Invoker-pray/INT8-CIM-of-jiao/Thesis/paper/paper.tex

\documentclass[bachelor,compact,nofont]{xjtuthesis}

% --- 手动字体设置（nofont 选项，因 Times New Roman / Arial 在 Linux 上不可用）---
\setmainfont{Liberation Serif}
\setsansfont{Liberation Sans}
\setmonofont{Liberation Mono}
\setCJKmainfont{Source Han Serif CN}
\setCJKsansfont{Source Han Serif CN}
\setCJKmonofont{Source Han Serif CN}
\setCJKfamilyfont{hei}{Source Han Serif CN}
\newcommand{\hei}{\CJKfamily{hei}}

% --- 额外宏包（正文内容需要）---
\usepackage{float}
\usepackage{pdfpages}
\usepackage{multirow}
\usepackage{tabularx}
\usepackage{listings}
\usepackage{xcolor}
\usepackage[bookmarksnumbered=true,bookmarksopen=true,bookmarksopenlevel=1,breaklinks=true,colorlinks=true,linkcolor=black,citecolor=black,urlcolor=black,plainpages=false,pdfborder=0 0 0]{hyperref}

% --- 图形路径 ---
\graphicspath{{figures/}{pics/}}

% --- 代码环境 ---
\lstset{
  basicstyle=\small\ttfamily,
  keywordstyle=\color{blue},
  commentstyle=\color{gray},
  numbers=left,
  numberstyle=\tiny\color{gray},
  frame=single,
  breaklines=true,
  captionpos=b
}

% --- 公式编号：分章编号 (章-序号) ---
\numberwithin{equation}{chapter}
\renewcommand{\theequation}{\thechapter-\arabic{equation}}

\begin{document}

\makeatletter
\g@addto@macro\normalsize{%
  \abovedisplayskip=3pt plus 1pt minus 1pt%
  \abovedisplayshortskip=3pt plus 1pt minus 1pt%
  \belowdisplayskip=5pt plus 1pt minus 1pt%
  \belowdisplayshortskip=5pt plus 1pt minus 1pt%
}
\makeatother
% ======================================================================
% 论文元信息
% ======================================================================
\ctitle{数字存算一体阵列架构设计与FPGA验证}
\cauthor{焦宏宝}
\ccollege{电子与信息学部\ \ 微电子学院}
\cmajor{微电子科学与工程}
\cclass{微电子2202班}
\corgnization{西安交通大学}
\stunum{2221411116}
\csupervisor{梁峰}
\cproddate{2026年05月}
\ckeywords{存算一体；INT8量化推理；FPGA验证；CIM阵列；AXI4-Stream DMA；双缓冲；PicoRV32}

\etitle{Design and FPGA Verification of a Digital Computing-in-Memory Array Architecture}
\eauthor{Jiao Hongbao}
\esupervisor{Liang Feng}
\ekeywords{Computing-in-Memory; INT8 quantized inference; FPGA verification; CIM array; AXI4-Stream DMA; double buffering; PicoRV32}

\cabstract{
随着深度学习在边缘智能场景中的广泛部署，传统冯·诺依曼架构中处理器与存储器分离所带来的数据搬运瓶颈日益突出。存算一体（Computing-in-Memory, CIM）技术通过在存储阵列内部或近存储位置完成计算，从体系结构层面缓解"内存墙"问题。

本文设计并实现了一种面向边缘推理的INT8数字存算一体矩阵计算阵列架构，在PYNQ-Z2（Zynq-7020）FPGA平台上完成了综合、部署与板级验证。系统以16×16 CIM Tile为原子计算单元，通过乘法器时分复用将单Tile的DSP48占用由256降至约64，在220块DSP的资源预算内部署输出并行度PAR\_OB=2/3（周期级仿真扫描至16）。核心引擎通过多级流水线状态机实现权重加载、零点减法、MAC运算、偏置累加、ReLU激活、重量化与结果写回的完整推理数据通路。数据通路采用AXI4-Stream + DMA双向批量传输替代逐字MMIO，配合输入/输出双缓冲乒乓结构与OBUF→IBUF层融合机制，将LeNet-5端到端延迟从约3,194 ms/幅降至29.88 ms/幅（约107倍数据通路加速）。软件侧引入块对角权重打包（SQ-mapping），将稀疏小卷积核场景下的MVM调用次数削减90\%以上。控制路径方面，集成了PicoRV32 RISC-V软核，通过总线桥接与双端口BRAM实现纯PL侧自主推理，且CIM IP完全不需修改。

实验结果表明，在64 MHz签核频率（PAR\_OB=2，WNS +0.013 ns）下，MLP网络（784→128→10）端到端延迟为1.94 ms/幅（约513 fps），LeNet-5 CNN端到端延迟为29.88 ms/幅（约33.5 fps），分类准确率99\%--100\%，全部硬件输出与自研Python整数golden model逐元素bit-exact一致。在与ARM Cortex-A9纯软件（NumPy/BLAS）同口径对比中，CIM硬件计算核快约65--191倍，系统级端到端仍快约1.23--2.24倍。PicoRV32模式以更少的逻辑资源（FF减少约2136个）实现纯PL自主推理，全部logits与ARM路径bit-exact一致。
}

\eabstract{
With the widespread deployment of deep learning at the edge, the data movement bottleneck caused by the separation of processor and memory in traditional von Neumann architectures has become increasingly prominent. Computing-in-Memory (CIM) technology mitigates the ``memory wall'' problem by performing computation within or near memory arrays.

This thesis designs and implements an INT8 digital CIM matrix computation array architecture for edge inference, with synthesis, deployment, and board-level verification on the PYNQ-Z2 (Zynq-7020) FPGA platform. The system employs a 16$\times$16 CIM Tile as the atomic compute unit; multiplier time-multiplexing reduces the per-tile DSP48 count from 256 to approximately 64, enabling output parallelism PAR\_OB=2/3 within the 220-DSP budget (with a cycle-level simulation sweep up to 16). The core engine implements the complete inference datapath—weight loading, zero-point subtraction, MAC operation, bias accumulation, ReLU activation, requantization, and result writeback—through a multi-stage pipelined FSM. The data path adopts an AXI4-Stream + DMA bidirectional bulk-transfer architecture in place of per-word MMIO, combined with input/output double-buffer ping-pong and OBUF$\rightarrow$IBUF layer fusion, reducing the LeNet-5 end-to-end latency from approximately 3,194 ms/image to 29.88 ms/image (about a 107$\times$ data-path speedup). On the software side, block-diagonal weight packing (SQ-mapping) is introduced to cut the number of MVM invocations for sparse small-kernel convolutions by over 90\%. For the control path, a PicoRV32 RISC-V soft-core is integrated; with a bus bridge and dual-port BRAMs, the accelerator achieves autonomous inference in pure programmable logic with zero modification to the CIM IP.

Experimental results show that at the 64 MHz signoff frequency (PAR\_OB=2, WNS +0.013 ns), the MLP network (784$\rightarrow$128$\rightarrow$10) achieves 1.94 ms/image end-to-end (about 513 fps), while LeNet-5 achieves 29.88 ms/image (about 33.5 fps), with classification accuracy of 99\%--100\%. All hardware outputs are element-wise bit-exact with a custom Python integer golden model. In an apples-to-apples comparison against pure ARM Cortex-A9 software (NumPy/BLAS), the CIM hardware is about 65--191$\times$ faster at the compute-core level and remains 1.23--2.24$\times$ faster at the system level. The PicoRV32 mode achieves autonomous inference in pure programmable logic with fewer logic resources (approximately 2,136 fewer FFs than ARM mode), and all logits are bit-exact with the ARM path.
}

% ======================================================================
% 封面、摘要、目录
% ======================================================================
\xjtuchead
\clearpage
\phantom{x}
\thispagestyle{empty}
\clearpage
\setcounter{page}{1}
\xjtucinfopage
\xjtueinfopage
\xjtutoc
\clearpage

% ======================================================================
% 正文开始
% ======================================================================
\xjtucontent

% ====================================================================
\chapter{绪论}
% ====================================================================

\section{选题背景}

近年来，以YOLO\cite{10}、SSD\cite{11}为代表的深度学习目标检测算法在智能安防、工业视觉、无人系统与车载感知等场景中被广泛采用，其共同特点是需要在较高精度下实现接近实时的推理能力，而网络内部又以卷积/矩阵乘加（MAC）为主导计算负载，导致整体计算量与数据访问量都十分庞大。YOLO将检测任务端到端地建模为单网络回归问题，SSD则是通过多尺度特征图上的卷积预测实现单阶段检测，这类方法在追求速度与精度的同时，也使得卷积算子成为系统性能与功耗优化的核心瓶颈之一。

进一步观察可以发现，无论是YOLO、SSD这类检测网络，还是更轻量的多层感知机（MLP）与LeNet-5等分类网络，其主干运算都可以归结为矩阵-向量乘法（Matrix-Vector Multiplication, MVM）：全连接层本身就是一次MVM，而卷积层在经过im2col变换之后同样可以转化为矩阵乘法的形式。这意味着，只要硬件能够高效地完成维度可配置的INT8 MVM运算，并在其后衔接偏置累加、激活函数与重量化等定点后处理，便可以覆盖绝大多数边缘推理网络的核心算力需求。这一观察是本文将设计目标聚焦于"面向任意层的通用INT8 MVM计算阵列"、而非针对某一特定网络定制专用电路的根本出发点；它使得同一套RTL能够通过运行时配置服务于不同规模、不同结构的网络，从而在工程上获得更好的复用性与可维护性。

然而，在传统冯·诺依曼架构中，处理器与存储器相互分离，权重与特征图等数据需要在存储层级与计算单元之间频繁搬运，导致数据搬运资源开销远比实际计算要大，系统性能逐渐受限于存储带宽与访问延迟，"内存墙（Memory Wall）"问题由此形成并长期存在（如图\ref{fig:vn_vs_cim}所示，图中左侧传统架构中计算单元与存储器分离，数据需在层级间频繁搬运，受"内存墙"制约）。Wulf与McKee早在1995年就指出处理器速度提升与存储器速度提升之间的差距会不断扩大，从而限制系统级性能提升\cite{1}。与此同时，能效维度的矛盾更加突出：在先进工艺条件下，数据搬运（尤其是跨层级、跨片外存储访问）相对于算术运算存在着显著更高的能量代价，使得"算得快"并不等价于"算得省"。Horowitz在ISSCC 2014的报告中系统讨论了计算系统的能耗拆分，强调需要从体系结构与数据流层面减少昂贵的数据访问\cite{2}。面向CNN的专用加速器研究也进一步表明：通过数据复用与数据流优化降低（尤其是片外）访存开销，是实现低功耗实时推理的关键路径之一\cite{3}。在边缘计算场景（比如电池供电、散热受限和实时性要求较高的场景）中，上述矛盾更加尖锐，传统"分离式计算-存储"模式难以同时满足吞吐与能效需求。图\ref{fig:energy_per_op}对比了典型算术运算与不同层级存储访问的单次操作能耗（对数坐标，45nm工艺典型值\cite{2}），可见片外DRAM访问的能耗比一次8-bit MAC运算高出约两个数量级，直观地解释了想要实现低功耗推理为何要同时降低数据搬运而非单纯提升算力。

\begin{figure}[H]
	\centering
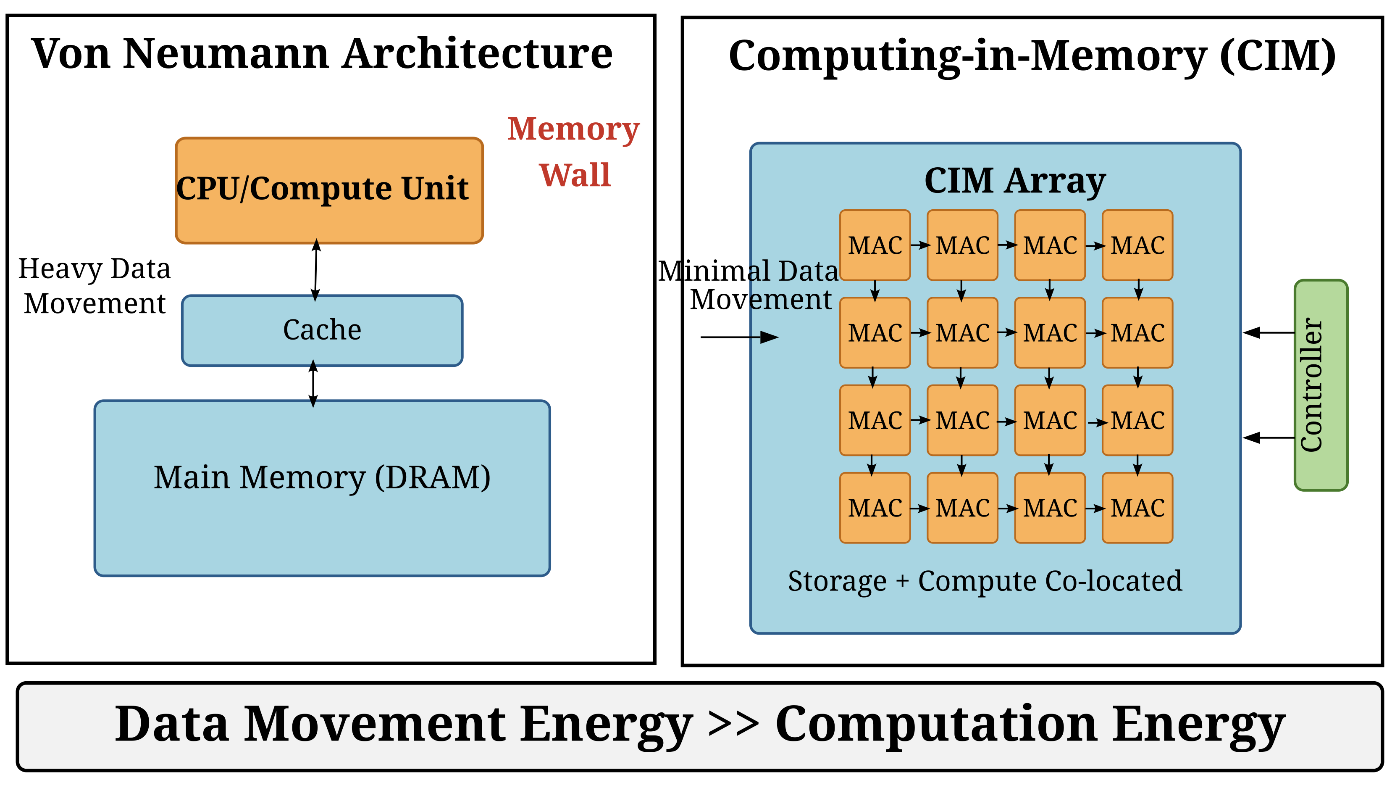
[picture p5: Thesis/paper/pics/1-1.png]
	
	\caption{冯·诺依曼架构与存算一体架构对比示意图}
	\label{fig:vn_vs_cim}
\end{figure}

\begin{figure}[H]
	\centering
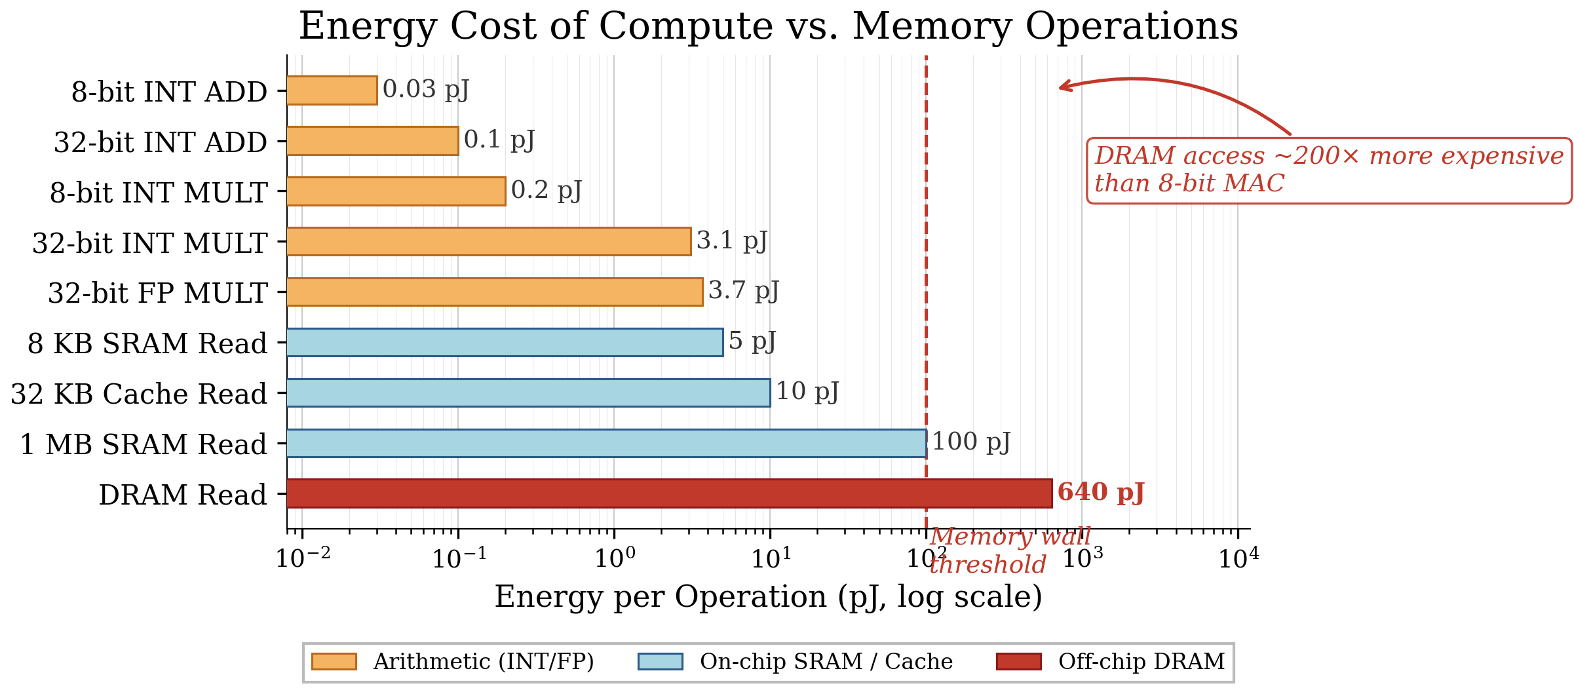
[picture p6: Thesis/paper/pics/1-2.png]
	
	\caption{计算与存储操作的单次能耗对比（pJ，对数坐标）}
	\label{fig:energy_per_op}
\end{figure}

存算一体（Computing-in-Memory, CIM）技术通过在存储阵列内部或近存储位置完成计算，将"数据搬运"转化为"原位计算"，从体系结构层面缓解冯·诺依曼瓶颈（如图\ref{fig:vn_vs_cim}所示，右侧为存算一体架构，将计算单元嵌入存储阵列内部，实现存储与计算的位置协同，显著减少数据搬运）。Nature Electronics的一些综述工作提出了覆盖不同存储器参与程度的CIM全谱系分类框架，并指出CIM可在逻辑运算与乘加运算等基本原语上实现能效提升\cite{4}。在诸多实现路径中，基于标准CMOS工艺的SRAM-CIM具有速度快、工艺成熟、可靠性高、与主流数字设计流程兼容等优点，是面向工程落地与系统集成的重要路线之一\cite{5}。Chuan-Jia Jhang团队系统综述了SRAM-CIM在AI边缘设备中的挑战与发展趋势\cite{30}，Si Xin与Dong Fangyuan团队也从设计挑战与方法学角度对SRAM-CIM进行了全面回顾\cite{31}\cite{34}。目前来讲，CIM技术被认为是突破内存墙、提升能效与吞吐率的重要方向。

从应用角度看，为在精度、硬件复杂度与系统吞吐之间取得平衡，INT8量化推理已成为工业界与学术界常用的落地方案之一。Jacob等人提出的整数算术推理量化方法表明，通过合理的量化尺度与训练以及恰当的校准策略，可在保持精度的前提下实现高效的整数运算推理流程\cite{6}。从硬件角度看，已有研究在SRAM-CIM宏单元中展示了面向多比特MAC的实现范式，如8b MAC的SRAM CIM宏以及支持Signed-INT8的SRAM CIM宏等工作，说明"多比特、可用于实际推理精度需求"的SRAM-CIM在工程上具有可行性\cite{8}\cite{32}。另外，在硬件加速方面，FPGA因其可重构性、低延迟与较高的能效比，已成为神经网络推理加速的重要平台\cite{meng2025}，已有工作在此基础上探索了注意力机制等特定算子的FPGA硬件加速\cite{feng2024}。

基于上述背景，本课题面向边缘智能推理的能效与实时性需求，在标准CMOS SRAM工艺假设下，设计了一种支持INT8数据类型的数字存算一体矩阵计算阵列架构（设计空间定位与两种实现极端的分析见§\ref{sec:two_extremes}）：以字级近存储方式组织权重存储与乘加及部分积生成（权重驻留BRAM、乘加由DSP48完成），结合合理的阵列并行组织、累加与数据通路调度，降低数据搬运开销并提升并行吞吐；通过Synopsys的VCS工具完成仿真测试，在AMD的Vivado(2024.2版本)完成综合和布局布线，并在FPGA平台完成实际综合部署与功能验证，形成了可复现的验证平台与完整代码交付。

\section{国内外现状及发展趋势}

存算一体研究近年来快速发展，已形成覆盖器件/电路/架构/算法的多层次技术体系。相关工作从实现介质（SRAM、DRAM、RRAM/PCM等）与计算形态（模拟/数字、阵列内/近存储）对CIM进行系统分类，指出其共同目标是减少访存与数据移动开销、利用阵列并行来提升吞吐\cite{4}\cite{5}\cite{12}\cite{14}\cite{30}\cite{31}\cite{34}\cite{r12}。近五年来，全数字SRAM-CIM在能效与精度上持续突破，相关宏单元与处理器工作密集涌现\cite{r1}\cite{r6}\cite{r8}\cite{r9}，成为面向边缘AI的重要研究热点。图\ref{fig:cim_taxonomy}按存储介质（SRAM/DRAM/RRAM/PCM等）与计算形态（模拟/数字、阵列内/近存储）给出了CIM技术的谱系分类，并标注了各分支的代表性工作；本文的设计落在"SRAM-CIM → 数字SRAM-CIM"这一分支（图中红框高亮），与ReDCIM、TranCIM、MulTCIM等数字CIM工作处于同一技术路线。

\begin{figure}[H]
	\centering
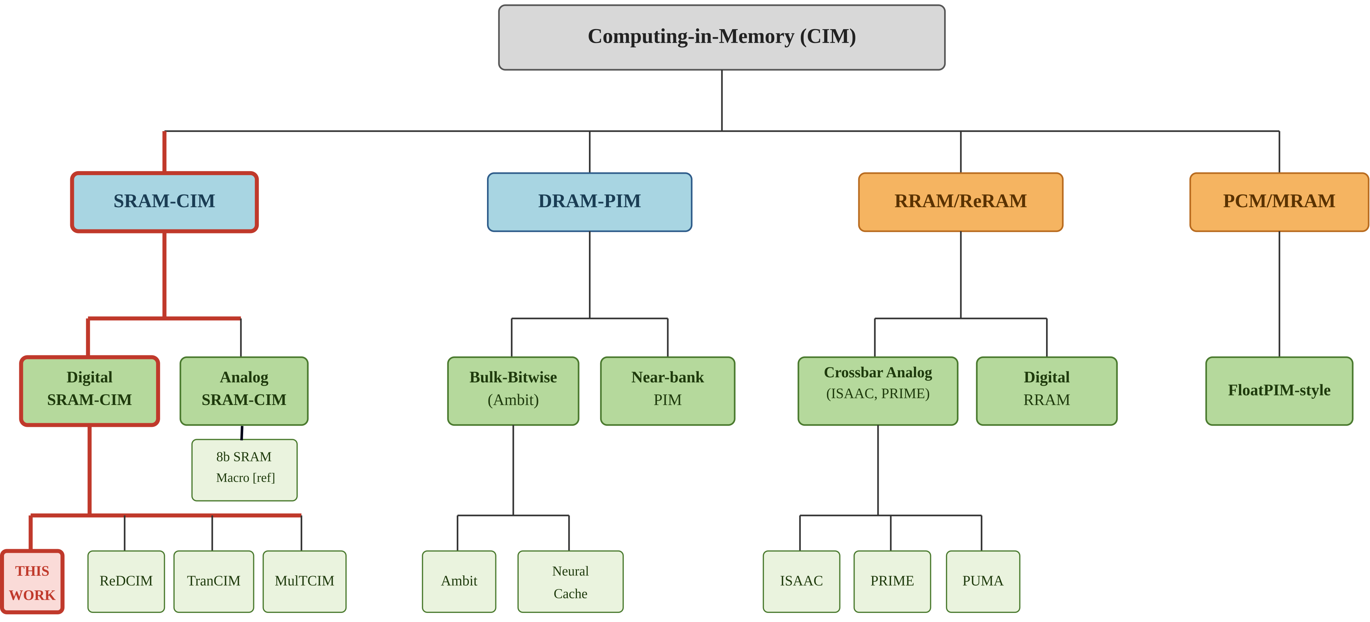
[picture p7: Thesis/paper/pics/1-3.png]
	
	\caption{存算一体技术分类谱系图}
	\label{fig:cim_taxonomy}
\end{figure}

在国际研究中，基于新型非易失存储器（如RRAM）交叉阵列的模拟CIM方案曾是重要热点，典型代表包括ISAAC\cite{17}和PRIME\cite{18}等工作。PUMA等可编程memristor加速器进一步探索了可编程的推理加速路径\cite{19}。近年来，基于ReRAM、STT-MRAM等新型器件的多比特CIM宏单元也在持续推进，进一步提升了边缘AI场景下的能效\cite{r11}\cite{r10}。但模拟CIM往往需要ADC/DAC等外围电路并面临器件非理想性、噪声等的影响，其精度与可校准性面临不小的挑战\cite{4}\cite{15}。面向通用存储体系的近存储计算也形成了多条路线，如Ambit\cite{21}、Neural Cache\cite{20}、FloatPIM\cite{22}等。

在电路与工程实现层面，基于标准CMOS工艺的SRAM-CIM因其速度、成熟度与数字设计流程兼容性而成为当前研究与产业化的重要路线\cite{5}\cite{12}\cite{14}。已有多项芯片级宏单元工作给出了可参考的实现范式，比如在28nm工艺下实现的64Kb 6T SRAM-CIM宏单元\cite{32}，以及支持Signed-INT8的ADC-less SRAM-CIM宏单元\cite{8}；近五年更涌现出面向更高精度与能效的多种宏单元设计，如POSIT数制CIM宏\cite{r2}、精度可重构数字CIM宏\cite{r3}、Booth编码近似数字CIM宏\cite{r5}，以及面向低功耗边缘的8T SRAM-CIM\cite{r16}与电流镜式SRAM-CIM宏\cite{r17}等。研究趋势正从"单个CIM宏单元验证"走向"可重构/可编程的数字CIM处理器与系统级加速器"。涂锋斌老师团队提出了支持BF16与INT8的可重构数字CIM处理器\cite{24}，其后续ReDCIM工作给出了统一FP/INT的数字CIM设计\cite{25}。同期也出现面向Transformer/注意力工作负载的数字CIM加速研究，如TranCIM\cite{26}、MulTCIM\cite{27}、面向注意力的近似数字CIM\cite{r4}等，以及支持浮点推理/训练的稀疏-数字CIM处理器\cite{r6}与新型动态逻辑CIM宏\cite{r7}。

在算法侧，INT8量化推理已成为常用的落地路径。Jacob等工作提出的整数算术推理量化方法提供了硬件采用INT8数据通路的算法依据\cite{6}。PACT\cite{28}与LSQ\cite{29}等研究进一步从训练与量化参数学习角度改善量化精度。在能效方面，Dong Qing等在7nm FinFET工艺下实现了351 TOPS/W的SRAM-CIM宏单元\cite{33}，展现了先进工艺下CIM的巨大能效潜力。

上述芯片级宏单元工作大多以ASIC流片或宏单元级别的能效、面积指标对比为主，而对"如何把一个CIM计算阵列接入完整的SoC数据通路、在真实硬件平台上端到端跑通一个神经网络、并保证逐元素数值正确"这一系统级问题着墨相对较少。在以FPGA为载体的神经网络推理加速方面，近年来也已有大量工作通过脉动阵列、INT8/低比特量化、数据复用与层间流水等手段提升端到端吞吐与能效\cite{r14}\cite{r15}，但其多以独立加速器为主，与CIM计算范式的结合仍有探索空间。对于以FPGA为载体的原型验证而言，除了计算核心本身的设计之外，权重/输入/输出的批量搬运效率、层与层之间的数据调度方式、以及软硬件数值一致性的可验证性，往往才是真正决定端到端吞吐率与结果可信度的关键环节——一个MVM算得再快，如果数据搬运成为瓶颈、或者无法证明硬件输出与软件参考逐位一致，其工程价值都会大打折扣。本课题正是面向这一相对薄弱的环节，强调在资源受限的小型FPGA上建立一套完整的工程验证闭环，而非单纯追求某一项孤立的峰值指标。

综合来看，国内外CIM研究呈现如下趋势：技术路线从"模拟/新型器件主导"扩展为"模拟与全数字并行发展"；算子与精度从低比特走向多比特MAC（尤其是Signed-INT8）；应用从CNN拓展到Transformer/多模态；验证方式越来越需要体系结构层面的可复现评估（包括RTL/FPGA原型验证、资源/频率/吞吐/延迟评估等）\cite{12}\cite{16}。本课题正是在此背景下，以数字SRAM-CIM阵列架构为核心，围绕数据通路、控制调度与FPGA验证建立了工程闭环。

\section{本文主要工作与贡献}

本文完成了以下工作：

（1）设计并实现了参数化的16×16 INT8 CIM Tile阵列与多级流水线加速器核心，支持可配置并行度（PAR\_OB参数）与Tile内MAC拆分因子（TILE\_SPLIT\_FACTOR），在单一FSM引擎中处理任意层的MVM运算。

（2）设计了完整的AXI4-Stream + DMA双向数据通路：MM2S方向实现权重/输入/偏置的批量加载，S2MM方向实现推理结果的DMA回读，将数据搬运效率相对逐字MMIO提升一个数量级。在此基础上，实现了输入/输出缓冲双bank乒乓结构，将DMA传输与硬件计算重叠执行，有效隐藏数据搬运延迟。

（3）针对连续全连接层场景，设计了OBUF→IBUF内部硬件直拷的层融合（Layer Fusion）机制，消除FC→FC层间的S2MM+MM2S DMA往返，并结合权重/偏置基址偏移实现多层权重共存与批量推理。

（4）在软件侧引入并适配了块对角权重打包（SQ-mapping）的卷积映射方法，通过将多个输出像素的im2col列与复制权重合并到同一次MVM调用，将稀疏小卷积核场景下的MVM调用次数削减90\%以上（Conv1 97.6\%、Conv2 89.1\%）、单次MVM的维度占用率从不足2\%提升至约60\%--98\%。SQ-mapping本身是已有的卷积映射技术，本文将其与本设计的硬件维度上限、双缓冲乒乓批处理与层融合数据通路相结合并完成工程落地与验证。

（5）解决了权重SRAM的BRAM推断问题：将2048位宽的weight SRAM拆分为16个独立的128位bank，确保Vivado成功推断为BRAM；设计了read-modify-write式的AXI写入通路，在保持32位AXI接口的同时实现128位整行写入。

（6）集成PicoRV32 RISC-V软核替代ARM PS进行推理控制，设计了总线桥接、双端口FW/Result BRAM等模块，实现了纯PL侧自主推理能力。

（7）建立了"Python golden model → VCS仿真 → PYNQ上板"三层一致的验证方法，在PYNQ-Z2平台上完成了MLP和LeNet-5 CNN的端到端验证，全部输出与软件参考模型bit-exact一致，并提供了完整的性能评估数据。

本文其余部分的组织结构如下。第2章介绍面向边缘推理的INT8数字存算一体矩阵计算阵列的总体架构与各关键模块设计，首先界定本课题在数字SRAM-CIM设计空间中的定位，随后依次展开CIM Tile原子计算单元、权重/偏置/输入输出存储子系统、量化与重定标流水线、AXI4-Stream + DMA双向数据通路、层融合机制以及核心引擎的流水线状态机等内容。第3章介绍以PicoRV32 RISC-V软核替代ARM PS、使CIM加速器能够在纯PL侧自主运行推理的集成方案，包括软核选型动机、总线桥接与地址映射设计，以及在集成过程中遇到的若干工程问题及其解决方法。第4章给出贯穿"软件参考模型—RTL仿真—板级实测"的三层一致验证方法学，并报告在PYNQ-Z2平台上的综合资源占用、时序与功耗结果，以及MLP、LeNet-5两类网络在多种数据通路配置下的端到端性能与逐元素一致性评估。第5章对全文工作进行总结，并讨论在并行度扩展、更大规模网络支持、更丰富算子覆盖与设计自动化等方面后续可拓展的方向。

% ====================================================================
\chapter{INT8 CIM阵列架构设计}
% ====================================================================

\section{数字SRAM-CIM的两种实现极端与本设计定位}
\label{sec:two_extremes}

在进入具体的模块设计之前，有必要先界定本课题在整个数字SRAM-CIM设计空间中的位置。现有数字SRAM-CIM的实现方式虽然种类繁多，但若按"单个存储位参与计算的粒度"这一维度来观察，可以抽象出两种典型的实现极端：一端是比特级bit-serial popcount架构，另一端是字级行为建模MAC架构。理解这两端的权衡，有助于解释为什么本课题在PYNQ-Z2资源约束下选择了后者。

\subsection{比特级 bit-serial popcount 架构}

这种架构把存储单元直接用作一位乘法器。该架构的典型形态是：SRAM cell只存储1位权重$w_i$，输入$x_i$的一位以WL广播进入阵列，BL/BLB上得到$x_i \cdot w_i$（实质是AND运算），再由阵列底部的加法器树对一整列做popcount累加得到一位×一位的点积。为支持INT8精度，输入的8个bit-plane需要在时间维度上顺次送入阵列，每次popcount结果按对应位权做移位累加，最终得到INT8$\times$INT8的MAC结果。

这种架构最贴近"存算一体"的本义：计算真正发生在存储阵列内部，每个bit-cell同时承担存储和计算角色，天然具备高并行度（一次popcount可覆盖数百行）、低数据搬运（输入只沿WL广播）和小面积（单cell仅含几颗晶体管）的优势。典型的阵列规模可达128行$\times$128列的1-bit cell，每8列打包为一个INT8权重通道，通过8-状态的bit-plane有限状态机实现INT8 MAC。

这一路线的代价也很直接：（1）一个INT8 MAC需要至少8个时钟周期完成，时序延迟被拉长为字级的$8\times$；（2）bit-serial流水对FPGA综合器并不友好，FPGA上很难推断出紧凑的BRAM+DSP结构，通常只能走LUT+寄存器，资源利用率反而偏低；（3）精度后处理（bias累加、ReLU、重量化）很难直接融入bit-serial流水，只能把INT32部分积搬回CPU处理。因此bit-serial架构在ASIC下确实有真正的面积与能效优势，但在面向FPGA原型验证和端到端闭环的场景下，性价比并不突出。

\subsection{字级行为建模MAC架构}

另一种架构则是把CIM阵列抽象为字级的行为模型：存储子系统按INT8/INT32字存取，计算单元一个周期内直接完成INT8$\times$INT8乘法与列方向累加，不再展开到bit-plane时间维度。在FPGA平台上，这种抽象可以被综合器自动映射到DSP48E1原语，每个DSP48能在一个时钟周期内完成一次有符号$18\times25$乘法与48位累加，对INT8 MAC是完全够用的。本课题的\texttt{cim\_tile.sv}即采用这一思路：16$\times$16的纯组合阵列在一拍内完成256个INT8 MAC，通过列方向的链式累加获得16个INT32部分和。

该路线带来的直接收益是：（1）单MAC延迟仅1拍，数据通路时序简洁，易在PYNQ-Z2上收敛至较高频率；（2）与传统数字综合流程完全兼容，可利用Vivado的DSP推断与BRAM推断自动优化；（3）因为计算单元是字级而非比特级，可以在MVM之后的同一条流水线中无缝嵌入bias累加、ReLU与multiply-shift重量化模块，做到INT8输入→INT8输出的端到端硬件闭环，PS仅在层与层之间介入；（4）单一FSM引擎通过CSR配置即可服务任意层，避免了为每一层设计专用硬件的冗余。

代价同样明显：（1）存储单元退化为常规BRAM，"存算一体"的物理含义被弱化，更接近近存储计算（near-memory computing）而非真正的in-memory computing；（2）DSP48数量成为硬性上限，PYNQ-Z2上只有220块DSP，若每个Tile行将16列乘法器全部组合实例化，单Tile即占满DSP而无法部署多份。为此本设计采用乘法器时分复用（详见后文"CIM Tile设计"一节）将单Tile的DSP占用压缩至约64块，从而在220块DSP的预算内部署多份Tile（板级PAR\_OB=2/3）。因此该路线本质是"牺牲CIM的物理严格性，换取FPGA平台下的工程可落地性与端到端闭环能力"。

\subsection{两种极端架构的对比与本设计的取舍}

图\ref{fig:two_extremes}从结构层面对比了上述两种实现极端：左侧为比特级bit-serial popcount架构（1-bit cell阵列 + popcount树 + 移位累加，单INT8 MAC需8拍），逼近"存算一体"本义但单MAC需8拍且FPGA不友好；右侧为本课题采用的字级行为建模MAC架构（16$\times$16 INT8 MAC阵列，单拍完成，易于映射到DSP48并在FPGA上闭合时序）。表\ref{tab:two_extremes}进一步将两种极端沿若干关键维度做了对比。

\begin{table}[H]
	\centering
	\caption{数字SRAM-CIM两种实现的对比}
	\label{tab:two_extremes}
	\begin{tabularx}{\textwidth}{>{\raggedright\arraybackslash}p{3.0cm} >{\raggedright\arraybackslash}X >{\raggedright\arraybackslash}X}
		\toprule
		维度 & 极端一：bit-serial popcount & 极端二：字级行为MAC（本课题） \\
		\midrule
		存储单元粒度 & 1-bit cell，AND+popcount & INT8/INT32字，BRAM \\
		INT8 MAC周期数 & 8拍（bit-plane shift-add） & 1拍（组合乘加） \\
		阵列规模示例 & $128\times128$ 位 $\times$ 8 bit-plane & $16\times16$ INT8 MAC \\
		FPGA资源映射 & LUT+FF为主，BRAM/DSP利用率低 & BRAM bank + DSP48推断 \\
		精度后处理位置 & CPU（bias/ReLU/重量化软件完成） & 硬件流水内完成 \\
		软件栈复杂度 & 高（需co-sim框架） & 中（Python golden model + 驱动） \\
		"存算一体"严格性 & 强（cell即MAC） & 弱（近存储字级MAC） \\
		ASIC面积/能效潜力 & 高 & 中 \\
		FPGA原型工程性 & 中 & 高 \\
		适用场景 & 芯片原型、算法-器件协同 & 工程闭环、系统级演示 \\
		\bottomrule
	\end{tabularx}
\end{table}

本课题的目标是在PYNQ-Z2这类资源受限的小型FPGA上，搭建一套从量化训练、RTL仿真、FPGA综合到板级推理验证的完整数字CIM闭环，并将其形态拓展到PicoRV32软核自主控制。

\begin{figure}[H]
	\centering
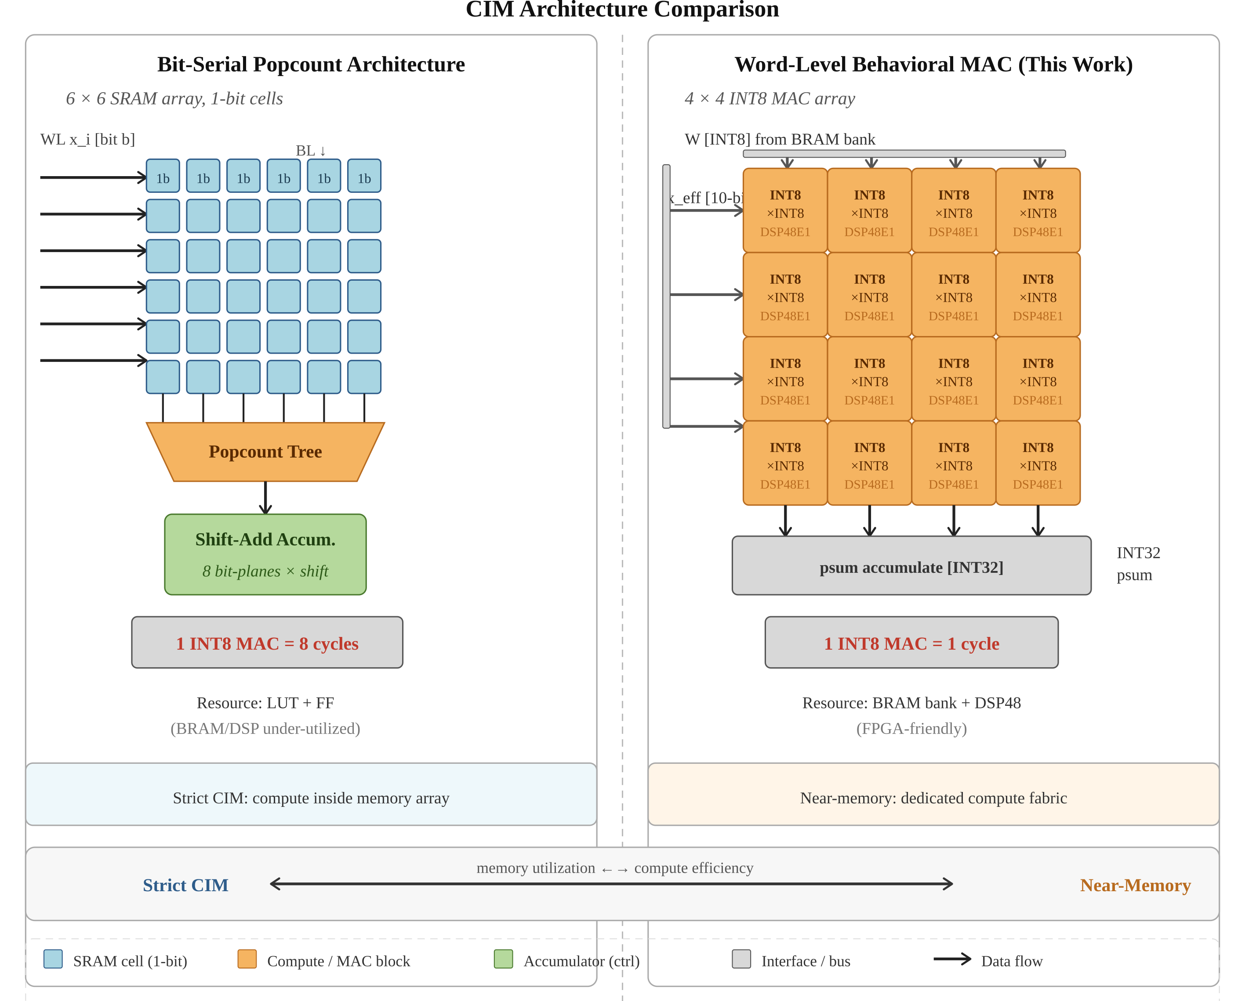
[picture p8: Thesis/paper/pics/2-1.png]
	
	\caption{数字SRAM-CIM两种实现的结构对比。图中阵列尺寸经缩小仅作示意，实际阵列为16×16}
	\label{fig:two_extremes}
\end{figure}

本项目重点思考以下内容：（i）硬件能否在目标频率下闭合时序并在PYNQ-Z2上布通；（ii）软硬一致性是否能做到逐层bit-exact可验证；（iii）整体数据通路是否能以单一FSM服务任意层。综合这三点约束，选择字级行为MAC路线是更合理的取舍。因此本章后续的所有模块设计，都围绕"字级INT8 MVM + 硬件化精度后处理 + 单FSM多层复用"这一核心展开。

\section{整体架构}

本设计采用"输入缓冲—CIM阵列—累加与量化—输出缓冲"的流水式组织，核心引擎以有限状态机（FSM）驱动完整的推理数据通路。系统顶层架构如图\ref{fig:top_arch}所示：ARM PS（或PicoRV32软核）通过AXI Interconnect以AXI4-Lite配置CSR、以AXI4-Stream（MM2S/S2MM）经AXI DMA与CIM IP批量交换数据；CIM IP内部由接口层（AXI4-Lite Slave、AXIS Sink/Source）、计算层（cim\_accel\_core、cim\_tile、psum\_accum、requant）与存储层（weight\_sram、bias\_sram、input/output\_buffer）三部分构成，图中箭头按数据类型着色：权重（红）、输入（蓝）、psum（绿）、INT8结果（黄）。系统由以下关键模块组成：
\begin{itemize}
	\item cim\_accel\_core：核心加速器引擎，包含多状态FSM与多级流水线，负责计算调度与性能计数；
	\item cim\_tile：16×16 CIM原子计算单元，采用乘法器时分复用（每行实例化\newline TILE\_COLS/TILE\_SPLIT\_FACTOR=4个物理乘法器，由FSM分4拍覆盖16列），等效完成256个INT8 MAC运算；
	\item psum\_accum：部分和累加器，带优先级清零机制；
	\item weight\_sram：16-bank权重SRAM，支持AXI DMA写入与tile-packed读取；
	\item bias\_sram：偏置SRAM，按输出神经元索引寻址；
	\item input\_buffer：输入缓冲，双bank乒乓结构，支持AXI写入与零点减法；
	\item output\_buffer：输出缓冲，双bank乒乓结构，含argmax逻辑；
	\item cim\_axi\_stream\_sink：AXI4-Stream slave，接收DMA批量数据并路由至各存储模块；
	\item cim\_axi\_stream\_source：AXI4-Stream master，将输出缓冲结果通过DMA批量回传；
	\item cim\_axi\_lite\_slave：AXI4-Lite接口，提供CSR配置、存储窗口访问及stream/legacy路径MUX。
\end{itemize}

所有可配置参数集中管理于\texttt{cim\_pkg.sv}文件中，包括Tile尺寸（TILE\_ROWS=16, TILE\_COLS=16）、并行度（PAR\_OB）、MAC拆分因子（TILE\_SPLIT\_FACTOR）、数据位宽（INT8输入/权重、INT32偏置/累加器）、最大层维度（MAX\_IN\_DIM=1536, MAX\_OUT\_DIM=256）、CSR地址映射与FSM状态编码。保证项目不存在magic number，所有RTL模块通过\texttt{import cim\_pkg::*}引用参数。

加速器的工作流程为：PS（或PicoRV32）通过AXI4-Stream DMA接口批量写入权重、偏置与输入数据，通过AXI4-Lite接口配置层参数（IN\_DIM, OUT\_DIM, N\_IB, N\_OB, requant\_mult, requant\_shift, act\_mode, input\_zp），然后触发start信号。核心引擎按output-block并行、input-block迭代的顺序完成MVM运算，每轮计算后进行偏置累加、激活与重量化，最终将INT8结果写入输出缓冲。完成后置位done信号并可触发IRQ。对于连续FC层，层融合机制可将OBUF结果通过内部硬件路径直接拷贝至IBUF，避免DMA往返。

上述"接口层—计算层—存储层"的三层划分把"会随平台/数据通路演进而改变的部分"与"承载核心算力、应当保持稳定的部分"解耦：接口层（AXI4-Lite Slave、AXIS Sink/Source）负责与外部总线和DMA交互，是后续从ARM切换到PicoRV32、或从逐字MMIO切换到AXI4-Stream时唯一需要改动的区域；计算层（cim\_accel\_core、cim\_tile、psum\_accum及重量化逻辑）封装了与控制方式无关的纯计算流水；存储层则以统一的整行/整字写接口对上屏蔽了bank拆分等实现细节。

\begin{figure}[H]
	\centering
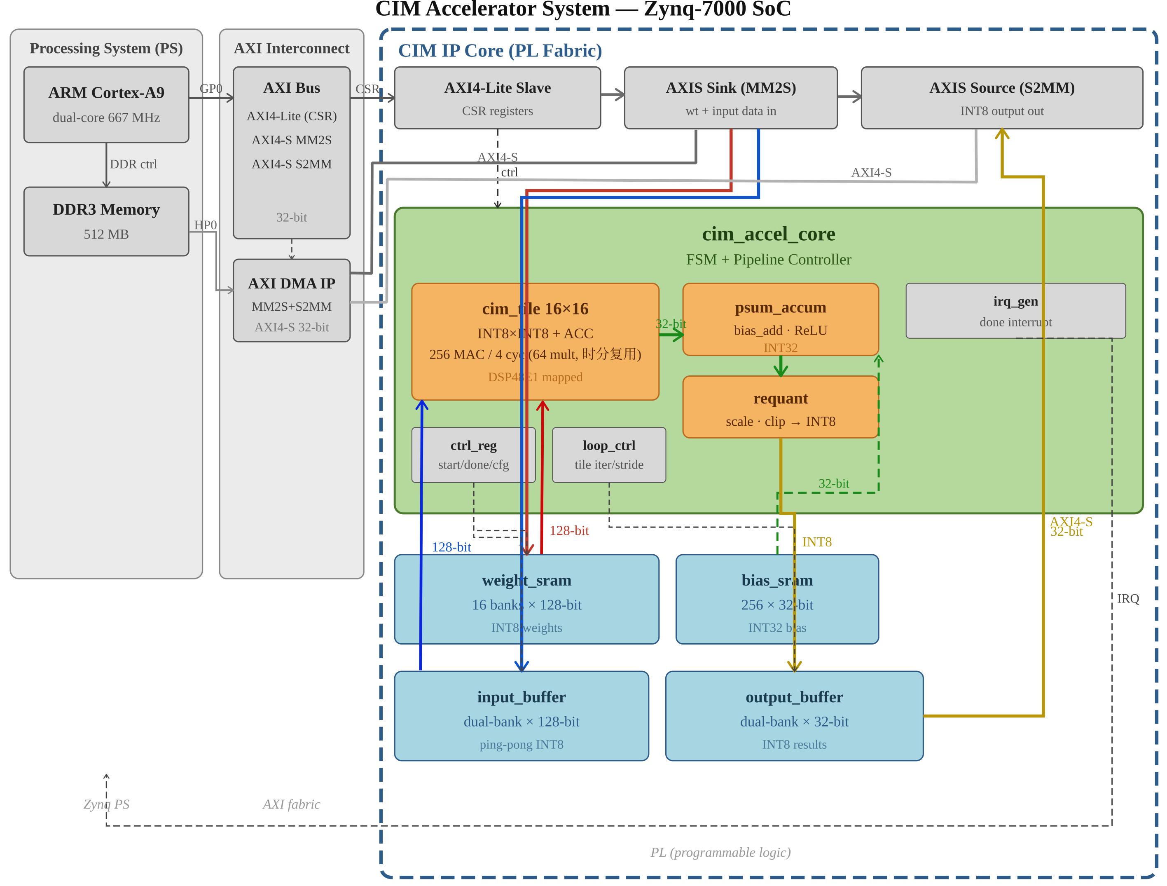
[picture p9: Thesis/paper/pics/2-2.png]
	
	\caption{CIM加速器系统顶层架构框图（Zynq-7000 SoC）}
	\label{fig:top_arch}
\end{figure}

正因如此，第3章用RISC-V软核替换ARM控制时，计算层与存储层可以做到"零RTL改动"。在计算调度上，核心引擎采用"外层按output-block、内层按input-block"的二重循环：外层每次处理由\texttt{PAR\_OB}个Tile行并行覆盖的一组输出神经元，内层沿输入维度逐个input-block地累加部分和；当某组输出的所有input-block累加完毕后，再统一对这组输出做偏置累加、激活与重量化并写回OBUF，然后进入下一组output-block。这种组织方式使得偏置累加、激活、重量化等"每个输出神经元只做一次"的后处理被自然地从内层MAC循环中分离出来，避免了重复计算。

\section{CIM Tile设计}

CIM Tile是本设计的原子计算单元，实现以下运算：

\begin{equation}
	\text{psum}[r] = \sum_{c=0}^{15} \text{x\_eff}[c] \times w[r][c], \quad r = 0, 1, \ldots, 15
\end{equation}

其中$\text{x\_eff}$为经过零点减法后的10位\emph{有符号}有效输入（位宽\texttt{X\_EFF\_W=10}，取值区间$[-512,511]$），$w$为Signed-INT8权重，输出为32位有符号部分和。本文所有MNIST/LeNet模型输入侧取$\text{input\_zp}=0$，UINT8像素$[0,255]$经零扩展后即作为有效输入$\text{x\_eff}\in[0,255]$（恰为有符号区间中的非负子集）；$\text{input\_zp}$为按层可配置的\emph{有符号}CSR量，当其取非零值时$\text{x\_eff}=x-\text{input\_zp}$可为负数，故采用有符号10位表示以正确容纳带非零零点的其他量化约定。

Tile采用纯组合逻辑实现，通过generate构造16行×16列的乘加阵列。每行独立计算一个输出神经元的部分和，列方向采用链式累加：

\begin{equation}
	\text{row\_acc}[c+1] = \text{row\_acc}[c] + \text{signed\_extend}(\text{x\_eff}[c]) \times w[r][c]
\end{equation}

在\texttt{TILE\_MAC\_REUSE=1}的默认配置下，每行并不组合实例化16个乘法器，而是仅实例化\texttt{TILE\_COLS/TILE\_SPLIT\_FACTOR}=4个物理乘法器，由核心引擎FSM在4个时钟周期内依次喂入第$q$组（$q=0,1,2,3$）的4列\texttt{x\_eff}与权重，从而以时分复用方式覆盖全部16列、等效完成$16\times16=256$次MAC。采用这种"少量乘法器+时分复用"设计的核心动机，是把单Tile的DSP48占用从256降至约64，使得在仅有220块DSP48的PYNQ-Z2上仍可部署多份Tile（\texttt{PAR\_OB}=2/3）实现输出并行。其内部结构如图\ref{fig:cim_tile}所示：有效输入$\text{x\_eff}$沿行方向广播，权重沿列方向由对应bank送入，每行的4个乘法器输出经寄存器打拍后通过短链式加法得到该组部分积，4组累加后得到一个INT32部分和。

对零点的处理如下。原始像素是$[0,255]$的无符号UINT8，而权重是有符号INT8；若把UINT8直接按有符号解释再与权重相乘，会在像素值$\ge 128$时产生符号歧义。为此，硬件在从输入缓冲读出时先对$x\_tile$做零扩展（对应RTL中的\texttt{\$signed(\{1'b0, x\_tile\})}），再减去CSR配置的有符号零点得到有效输入，即\,\texttt{x\_eff = \$signed(\{1'b0, x\_tile\}) - input\_zp}\,，其结果按\emph{有符号}10位（\texttt{X\_EFF\_W=10}，区间$[-512,511]$）表示并在越界时做饱和。采用有符号位宽是数值语义正确的前提。对本文涉及的全部MLP与LeNet-5模型，输入侧均取$\text{input\_zp}=0$、权重采用对称量化（zp=0），此时$\text{x\_eff}$即像素值本身、范围$[0,255]$（落在有符号区间的非负子集内），不引入任何额外偏移项，乘法为"有符号10位$\times$有符号8位"，golden model严格复现同一有符号零点约定，从而与硬件输出逐位一致。进一步地，\texttt{input\_zp}被保留为按层可配置的有符号CSR以兼容带非零输入零点的量化约定；在标准整数量化中，非零输入零点$z$所引入的交叉项$z\cdot\sum_{c} w[r][c]$会在离线标定时按输出通道折入INT32偏置，因此无论零点取何值，硬件都只需执行同一条"零点减法$\to$MVM$\to$加偏置"流水即可保持数值正确。在位宽方面，单个有符号$10\text{-bit}\times 8\text{-bit}$乘积的幅值不超过$512\times128=2^{16}$（约17位幅值），沿16列累加后理论上限约$2^{20}$（约21位幅值），因此用32位有符号部分和寄存器存放绝不会溢出，留有充足裕量。在流水实现上，Tile对每行乘法器的输出先打一拍寄存器再做链式累加（\texttt{C4\_MUL\_PIPE}），把原本"DSP乘法$\to$进位链累加"的长组合路径切分为"寄存$\to$DSP乘法$\to$寄存"与"寄存$\to$CARRY4累加$\to$寄存"两段，从而显著缩短关键路径、为更高时钟频率与双缓冲重叠预留时序裕量；与此同时，规则的乘加结构仍可被综合器识别并映射到FPGA内置的DSP48E1硬核上——每个DSP48E1可在一拍内完成一次有符号$18\times25$乘法与48位累加，对10位输入、8位权重的INT8 MAC而言绰绰有余，相比用查找表搭建乘法器，资源与时序都更优。

\begin{figure}[H]
	\centering
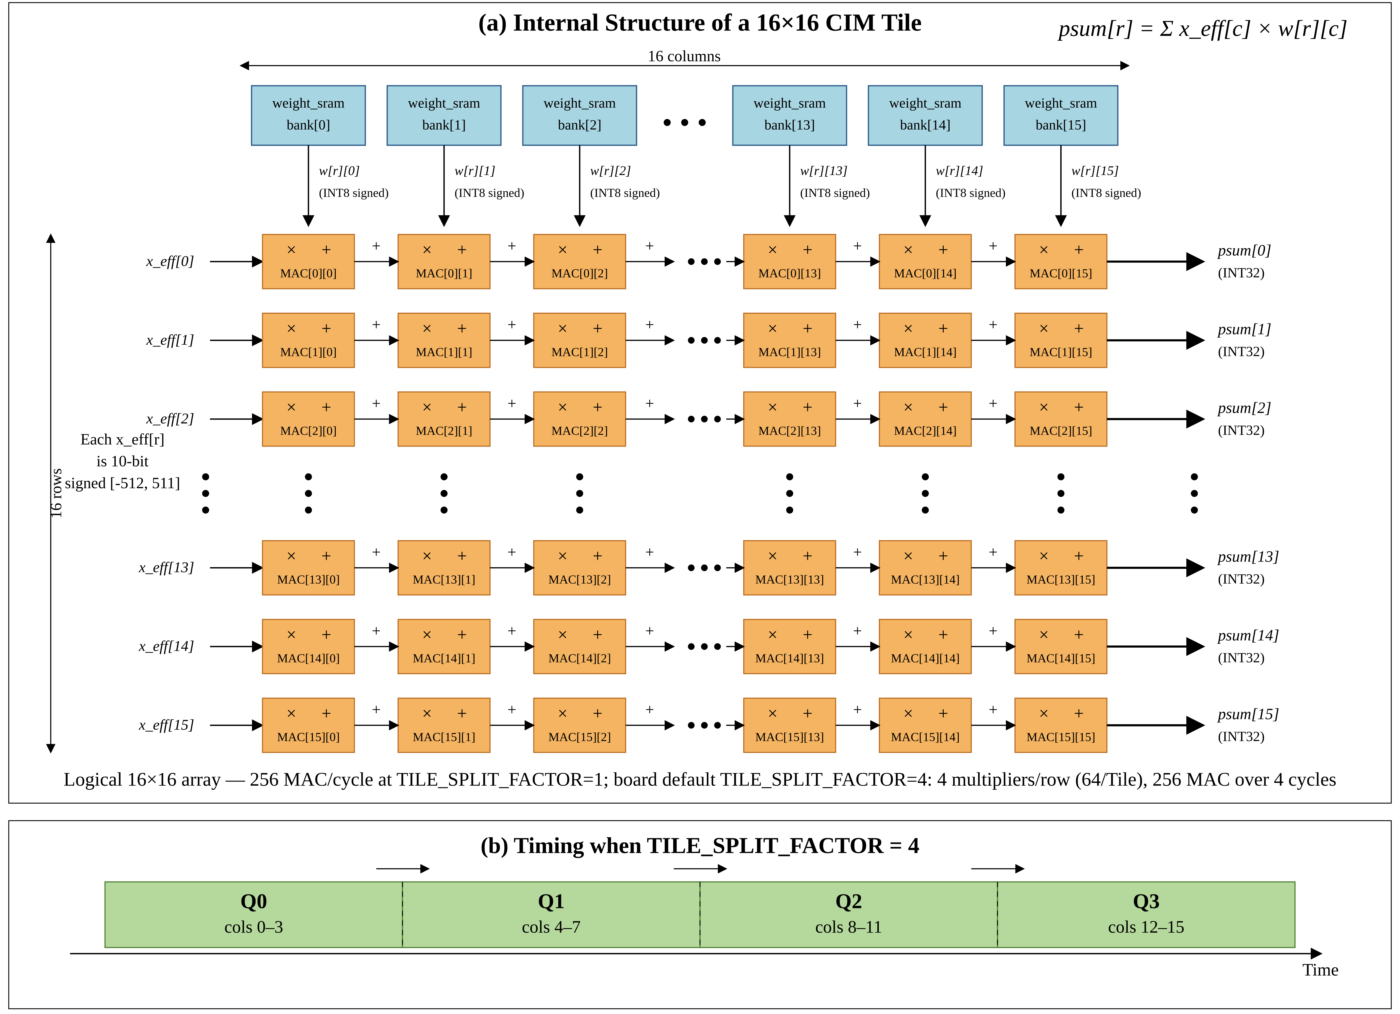
[picture p10: Thesis/paper/pics/2-3.png]
	
	\caption{16$\times$16 CIM Tile内部结构}
	\label{fig:cim_tile}
\end{figure}

为支持更高时钟频率，Tile内部的16列MAC可通过编译期参数\texttt{TILE\_SPLIT\_FACTOR}拆分为多组顺序执行。当\texttt{TILE\_SPLIT\_FACTOR}=4时，16列被分为4组（每4列一组），分4个时钟周期计算：

\begin{equation}
	\text{psum}[r] = \sum_{q=0}^{3} \sum_{c=4q}^{4q+3} \text{x\_eff}[c] \times w[r][c], \quad r = 0, \ldots, 15
\end{equation}

每组仅含4个MAC + 单个CARRY4进位链，再叠加乘积寄存器（\texttt{C4\_MUL\_PIPE}）将"DSP乘法$\to$进位链累加"进一步切分为两段流水，单段组合路径大幅缩短。FSM相应地从单一\texttt{ST\_MAC}状态扩充为每组三个子状态——\texttt{ST\_MAC\_Q*\_L}（锁存第$q$组的\texttt{x\_eff}/权重切片）$\to$\texttt{ST\_MAC\_Q*\_M}（寄存乘积）$\to$累加，四组（Q0$\sim$Q3）顺序执行，因此每个input-block迭代的MAC段由原来的约1拍扩展为若干拍。这一拆分与流水化策略的代价是MAC段周期数增加，但其价值在于把关键路径切短，使设计在PYNQ-Z2上于64 MHz完成时序收敛（75/80 MHz为功能性超频，WNS为负但常温功能正确），并为非MAC流水级（bias/ReLU/重量化）与双缓冲乒乓重叠提供时序裕量。

本版本默认开启\texttt{TILE\_MAC\_REUSE=1}，采用"乘法器时分复用"机制：每个Tile行只实例化\texttt{TILE\_COLS/TILE\_SPLIT\_FACTOR}=4个物理乘法器，由FSM分4拍轮流处理16列的四个切片，因此单Tile实际占用的乘法器约为$16\times4=64$个（而非$16\times16=256$个），"产出一次完整256-MAC结果需4拍"对应的是物理乘法器被复用4次。正是这一压缩使得在仅有220块DSP48E1的PYNQ-Z2上可以同时部署2$\sim$3份Tile：\texttt{PAR\_OB}=2的MAC部分约占128块DSP（连同重量化等逻辑实测共134块、约61\%），\texttt{PAR\_OB}=3的MAC部分约占192块（实测共198块、约90\%），DSP占用不再是早期单Tile全实例化时的100\%，从而把"用满DSP却只有一份Tile"的低效利用，转化为"在DSP预算内换取真实的输出并行度"。综合后各配置的DSP/BRAM/LUT精确占用见表\ref{tab:util_final}。

\section{存储子系统}

\subsection{权重SRAM的BRAM推断问题与bank拆分方案}

权重SRAM的设计是本项目的关键工程挑战之一。初始设计中，weight SRAM为一整块2048位宽（$\text{TILE\_ROWS} \times \text{TILE\_COLS} \times 8 = 2048$位）的存储器。然而，Vivado对这种超宽memory推断BRAM本身就困难；更关键的是，如果用bit-select方式做32位chunk部分写入，Vivado会直接放弃BRAM推断，退化为纯寄存器，导致资源爆炸。

解决方案是将weight SRAM拆分为16个独立的bank，每个bank仅$\text{ROW\_W} = \text{TILE\_COLS} \times \text{WEIGHT\_W} = 128$位宽，对应Tile的一行权重。16个bank通过generate实例化，每个bank独立推断为BRAM：

\begin{equation}
	\text{bank\_mem}[r][\text{tile\_idx}] = \{w[r][15], w[r][14], \ldots, w[r][0]\}, \quad r = 0, \ldots, 15
\end{equation}

写入侧使用staging register将4个32位AXI写入累积为完整的128位行数据，然后通过单周期整字写入送入对应bank，确保了BRAM推断所需的"纯整字写入"条件。该bank拆分前后的对比如图\ref{fig:weight_bank}所示。图中上半部分表示原始2048位单块在32位部分写入下无法被Vivado推断为BRAM，退化为FF/LUT；下半部分表示的是拆分为16个独立128位bank，配合staging register将4个32位AXI beat组装为128位整行写入，每个bank均成功推断为BRAM。

这一"先攒齐128位、再整行写入"的read-modify-write式通路，本质上是在32位的AXI接口与128位的BRAM整行写入之间架设了一个宽度转换桥：上层软件仍按32位字（chunk）逐个送权重，硬件在staging寄存器里把连续4个chunk拼成一整行，只在第4个chunk到达时拉高一拍写使能、把整行一次性写进BRAM。这样既保持了对软件友好的32位写接口（与既有的\texttt{weight\_to\_chunks}打包格式兼容），又满足了综合器对BRAM"整字写、不做位选择部分写"的苛刻要求。BRAM推断是本设计资源可行性的关键前提：权重存储的最坏容量约为$16\times128\times1536/8\approx 384\text{ KB}$，若退化为寄存器实现，所需的触发器数量将远超xc7z020全片10万余个FF的规模，整个工程将无法满足资源约束；而一旦正确推断为BRAM，这部分存储几乎不占用LUT/FF，仅消耗Block RAM资源。因此这一拆分既是功能正确性的保证，也是资源可行性的前提。

\begin{figure}[H]
	\centering
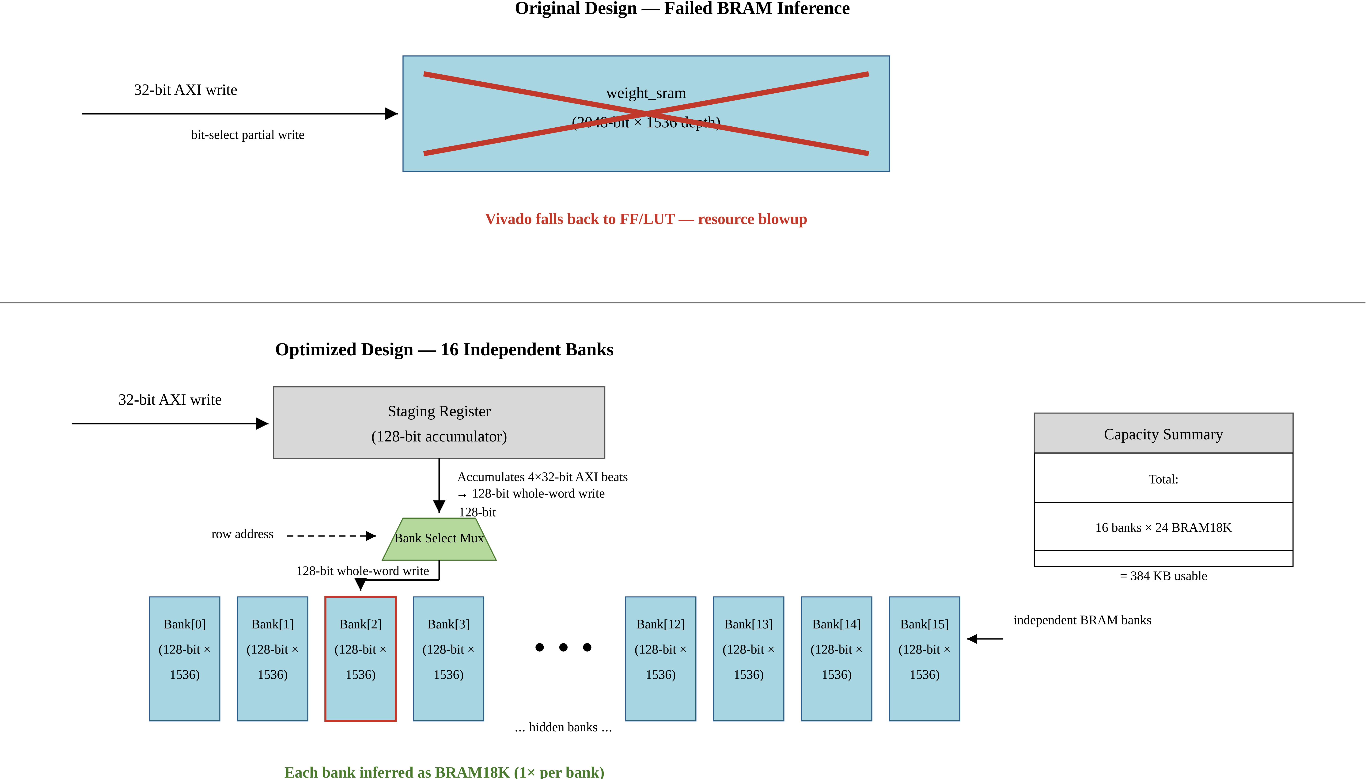
[picture p11: Thesis/paper/pics/2-4.png]
	
	\caption{权重SRAM的16-bank拆分方案对比}
	\label{fig:weight_bank}
\end{figure}

\begin{table}[H]
	\centering
	\caption{权重SRAM设计参数}
	\begin{tabularx}{\textwidth}{l>{\centering\arraybackslash}X>{\centering\arraybackslash}X}
		\toprule
		参数 & 值 & 说明 \\
		\midrule
		Bank数量 & 16 & 对应TILE\_ROWS \\
		Bank宽度 & 128 bits & TILE\_COLS $\times$ WEIGHT\_W \\
		Bank深度 & 1536 & 扩展后的最大tile容量 \\
		总容量 & 393,216 bytes & $16 \times 128 \times 1536 / 8$ \\
		写入接口 & 128-bit whole-word & 确保BRAM推断 \\
		读取延迟 & 1 cycle & registered read \\
		\bottomrule
	\end{tabularx}
\end{table}

\subsection{偏置SRAM与输入/输出缓冲}

偏置SRAM按输出神经元索引寻址，每个条目32位（INT32），深度为MAX\_OUT\_DIM=256。输入缓冲存储tile-packed的输入数据，每条目$\text{TILE\_COLS} \times \text{INPUT\_W} = 128$位。输入缓冲在读取时自动完成零点减法：

\begin{equation}
	\text{x\_eff}[c] = \text{input}[c] - \text{input\_zp}
\end{equation}

其中input\_zp通过CSR按层配置（有符号量）；本文所有模型输入侧取input\_zp=0，即x\_eff为UINT8像素值本身（落在有符号10位区间$[-512,511]$的非负子集$[0,255]$内）。当input\_zp取非零值时，$x-\text{input\_zp}$可能为负，故x\_eff以有符号10位表示，为非零零点的量化约定预留正确的数值语义与余量。输出缓冲存储INT8推理结果，并内置argmax比较逻辑，在末层推理完成后自动给出预测类别。

\subsection{IBUF/OBUF双缓冲乒乓设计}

为将DMA数据传输与CIM计算重叠执行，输入缓冲和输出缓冲各自实现了双bank（bank0/bank1）乒乓结构。设计原则为最小化核心改动：\texttt{cim\_accel\_core.sv}完全不感知bank的存在，bank选择逻辑完全封装在\texttt{cim\_axi\_lite\_slave.sv}中，通过单个CSR位\texttt{CSR\_PING\_CTRL}（地址0x06C）控制，写1翻转（toggle）、写0为no-op。

Bank选择规则如表\ref{tab:pingpong_bank}所示：CIM compute始终使用\texttt{reg\_ping\_ctrl}选中的"活跃bank"（读IBUF活跃bank、写OBUF活跃bank），而DMA始终访问其反码对应的"非活跃bank"（写IBUF非活跃bank、读OBUF非活跃bank）。一次toggle操作即可原子性地交换DMA与compute的访问目标，实现DMA传输与硬件计算的无冲突重叠。

\begin{table}[H]
	\centering
	\caption{双缓冲Bank选择逻辑}
	\label{tab:pingpong_bank}
	\begin{tabularx}{\textwidth}{l>{\raggedright\arraybackslash}Xl}
		\toprule
		信号 & 公式 & 用途 \\
		\midrule
		ibuf rd bank & \texttt{reg\_ping\_ctrl} & Compute从活跃bank读取输入 \\
		obuf wr bank & \texttt{reg\_ping\_ctrl} & Compute向活跃bank写入结果 \\
		ibuf wr bank & \texttt{\textasciitilde reg\_ping\_ctrl} & DMA向非活跃bank写入下一批输入 \\
		obuf rd bank & \texttt{\textasciitilde reg\_ping\_ctrl} & DMA从非活跃bank读回上一批结果 \\
		\bottomrule
	\end{tabularx}
\end{table}

\begin{figure}[H]
	\centering
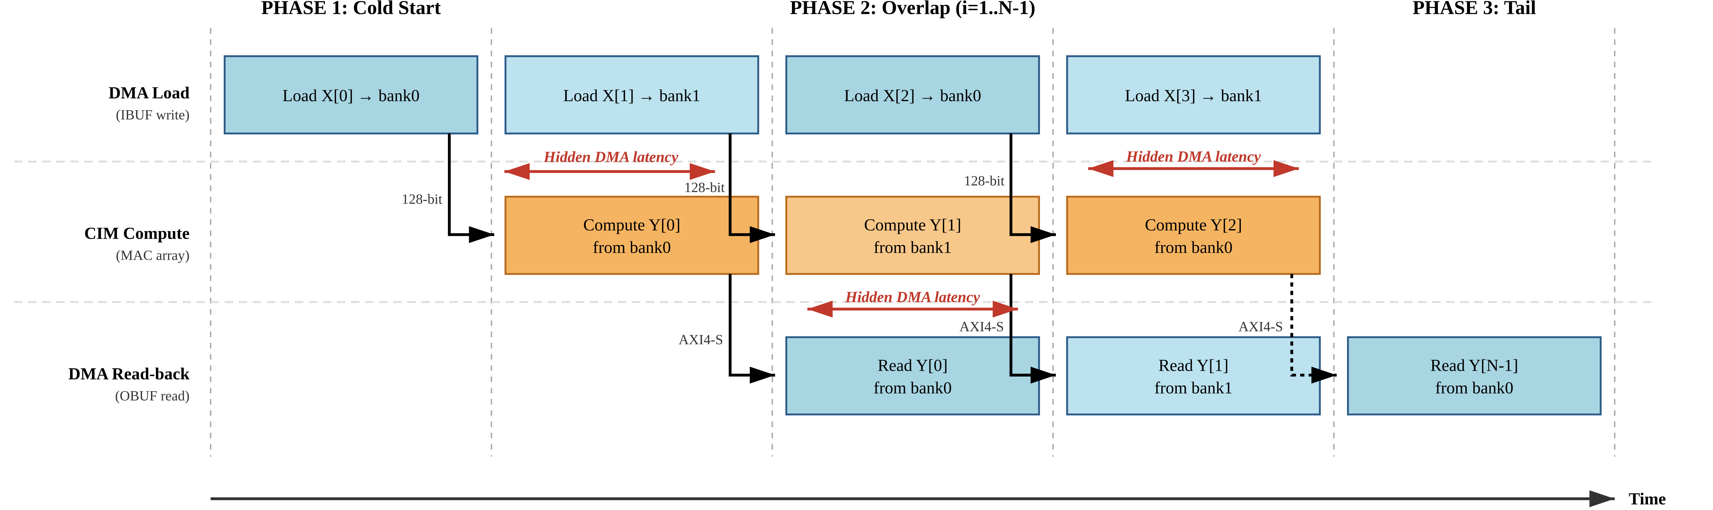
[picture p12: Thesis/paper/pics/2-5.png]
	
	\caption{IBUF/OBUF双缓冲乒乓执行时序图}
	\label{fig:pingpong}
\end{figure}

Python驱动侧有\texttt{toggle\_bank()}、\texttt{start\_compute()}（非阻塞触发）与\newline\texttt{wait\_for\_done()}（阻塞轮询）三个原语。核心编排逻辑的乒乓序列如图\ref{fig:pingpong}所示，分为cold start、overlap与tail三个阶段：cold start阶段加载首批的输入→翻转bank→启动计算；overlap循环阶段在compute(i-1)进行的同时通过DMA向非活跃的bank加载input(i)，compute完成后翻转bank并立即启动下一轮计算，同时从非活跃的bank读回上一轮结果；tail阶段处理最后一批结果的读回。一次\texttt{toggle}操作原子性地交换DMA与compute的bank分配。对于Conv层的批量推理，将所有图像的$k_{\text{pack}}$批次收集为单一列表，一次乒乓调用完成整个卷积层的全部MVM推理，最大化重叠批次数。

\section{量化与重定标}

本设计的量化流程遵循标准INT8整数推理规范\cite{6}，确保与软件golden model的bit-exact一致性。完整的量化链路为：

\begin{equation}
	\text{psum} = \sum_c \text{x\_eff}[c] \times w[r][c] + \text{bias}[r]
\end{equation}

\begin{equation}
	\text{prod} = \text{psum} \times \text{requant\_mult}
\end{equation}

\begin{equation}
	\text{shifted} = \left\lfloor \frac{\text{prod} + 2^{\text{requant\_shift}-1}}{2^{\text{requant\_shift}}} \right\rfloor
\end{equation}

\begin{equation}
	\text{output} = \text{clamp}(\text{shifted}, -128, 127)
\end{equation}

其中requant\_mult和requant\_shift为每层可配置的量化参数，通过CSR在运行时设置。重定标过程中使用64位中间乘积以避免溢出，移位时采用带舍入的算术右移（round-half-up），最后clamp到INT8范围$[-128, 127]$。

从原理上看，这条重定标链路是浮点缩放因子的定点化近似。在标准INT8量化推理中，一层累加得到的INT32结果需要乘以一个介于0与1之间的实数缩放因子$M=S_xS_w/S_y$（由输入、权重、输出三者的量化尺度决定）才能回到下一层的INT8动态范围。硬件无法直接做浮点乘法，于是把$M$近似为$M\approx \text{requant\_mult}/2^{\text{requant\_shift}}$这样一个"定点乘数加右移"的组合：先用一个32位整数乘数与INT32部分和相乘，再算术右移指定位数。式中的$+2^{\text{requant\_shift}-1}$是四舍五入项，等价于在右移前加上半个最低有效位，使移位结果做到"就近取整"（round-half-up）而非简单截断，这一点对于把硬件输出与软件参考模型对齐到逐位一致至关重要——若硬件用截断、软件用四舍五入，二者在大量边界样本上就会产生$\pm1$的偏差。关于位宽，INT32部分和与32位乘数相乘最坏可达约$63$位，因此中间乘积必须用64位容器承载，否则会溢出；右移并截断回INT8之前再做一次$[-128,127]$的饱和clamp，防止个别超界值回绕。\texttt{cim\_pkg.sv}中以一个\texttt{requantize()}纯函数精确描述了上述运算（64位乘积、带舍入右移、饱和），仿真testbench、综合RTL与Python golden model三者复用同一套定义，从源头上保证了三层数值的一致性。

激活函数支持三种模式：无激活（ACT\_NONE）、ReLU（ACT\_RELU，将负值归零）、范围截断（ACT\_CLAMP）。模式通过CSR的ACT\_MODE寄存器配置。这三种模式已足以覆盖本文涉及的MLP与LeNet-5网络：隐藏层使用ReLU、输出层使用无激活（直接给出logits供argmax），而ACT\_CLAMP则为将来需要硬截断的层预留。完整的量化重定标数据通路及各级位宽与对应FSM状态如图\ref{fig:requant}所示。下图展示了从psum累加经加偏置、ReLU/clamp、乘requant\_mult（升至64位）、加舍入项、算术右移、clamp至INT8，逐级标注位宽（32$\to$32$\to$32$\to$64$\to$64$\to$32$\to$8）与对应FSM状态。

\begin{figure}[H]
	\centering
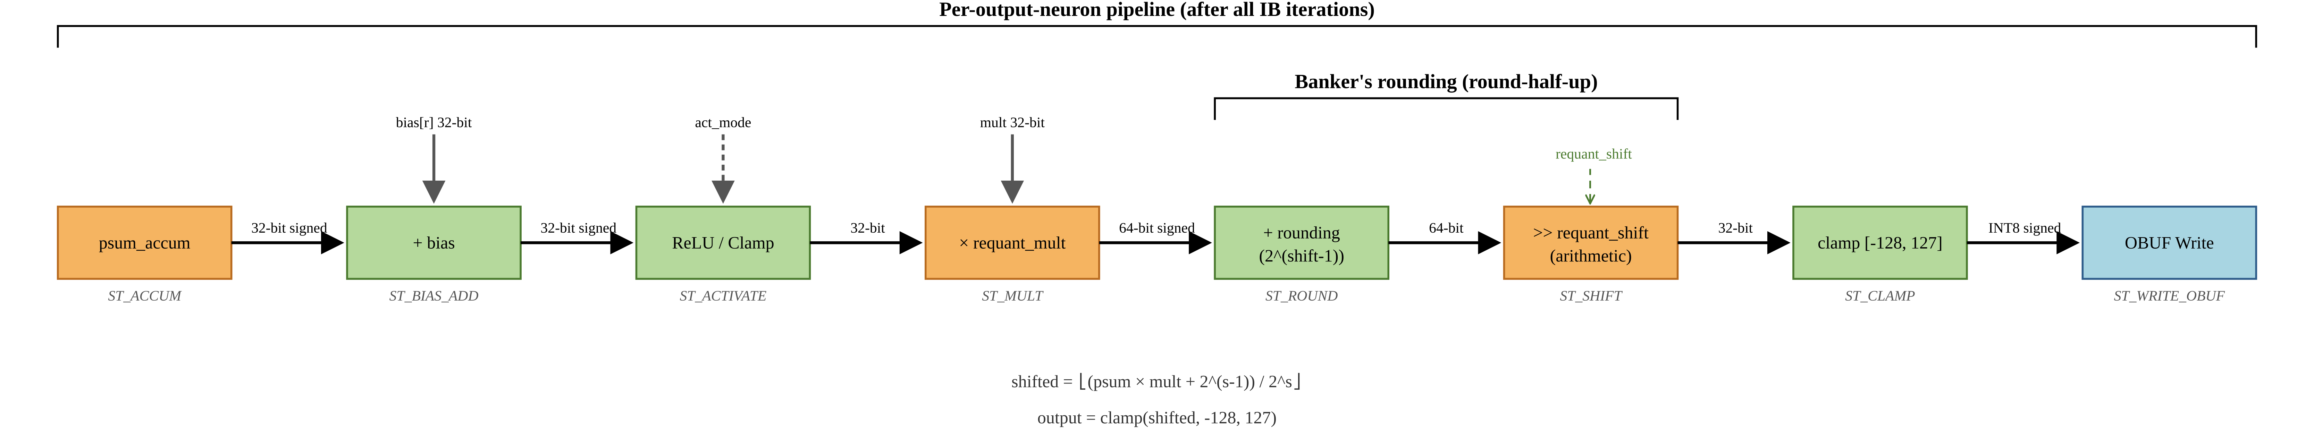
[picture p13: Thesis/paper/pics/2-6.png]
	
	\caption{量化重定标数据通路流水线}
	\label{fig:requant}
\end{figure}

\section{AXI4-Stream DMA数据通路}

系统通过AXI4-Stream + Xilinx axi\_dma IP实现双向批量数据传输，替代传统AXI4-Lite逐字MMIO。

之所以要做这一重构，是因为在早期以AXI4-Lite逐字MMIO搬运数据的版本中，数据通路而非计算本身成为了端到端性能的绝对瓶颈。逐字MMIO的根本问题在于：从PYNQ的Python侧看，一次\texttt{mmio.write()}是一次系统调用（经由Python运行时、libc、\texttt{/dev/mem}映射直至产生一笔AXI事务），单次软件开销约数微秒，而真正的AXI4-Lite单事务硬件耗时仅约数十纳秒——也就是说，软件循环把每笔传输的有效成本放大了数十倍。对于权重数据量较大的网络，这一放大尤其致命：LeNet-5单图打包后的权重就有约数万个32位字，若全部用Python循环逐字写入，仅权重加载一项就需要上百毫秒，从而使逐字MMIO配置下LeNet-5的端到端延迟高达每张数千毫秒，其中绝大部分时间都耗在了纯软件循环上而非硬件计算。修复思路是按数据特性分流：对量小、对延迟敏感的CSR配置仍保留AXI4-Lite（适合\texttt{mmio.write}逐个写）；对量大、可批量的权重/输入/输出数据，改走AXI4-Stream + \texttt{axi\_dma}，由PYNQ的\texttt{pynq.lib.dma}一行调用即可发起一次连续DMA，把数千个字一次性从DDR经HP高性能端口搬入CIM，彻底摊薄每字的软件开销。

\subsection{MM2S写入通路}

权重、输入与偏置的加载走DDR→\allowbreak S\_AXI\_HP0→\allowbreak axi\_dma→\allowbreak M\_AXIS\_MM2S→\allowbreak cim\_axi\_stream\_sink的批量stream路径。\texttt{cim\_axi\_stream\_sink}内部实现4-beat到128-bit行装配：每4个32-bit AXI4-Stream beat组成一个完整的128-bit行写入，根据CSR配置的dest字段（0=weight, 1=input, 2=bias）路由至对应存储模块。CSR控制仍保留原AXI4-Lite接口，CIM计算核心（\texttt{cim\_tile}、\texttt{psum\_accum}、\texttt{cim\_accel\_core}）完全不动。

关键设计决策包括：（1）AXIS数据宽度=32-bit，与现有weight\_to\_chunks软件packing兼容，DMA内部利用Data Realignment Engine做64→32dwidth转换；（2）dual-path共存——在\texttt{cim\_axi\_lite\_slave}内部通过CSR\_CTRL[3]对写入路径做MUX，legacy MMIO路径保留用于A/B对照与回归隔离；（3）cfg\_start通过写CSR\_STREAM\_LEN隐式触发，原子化操作省去额外的CSR写开销；（4）s\_axis\_tready恒为1——BRAM写为单周期完成，sink内部无需排队，反压沿由DMA侧向PS端反向传播。该sink将4个32位beat装配为128位行并按dest字段路由的过程如图\ref{fig:axis_sink}所示。

\begin{figure}[H]
	\centering
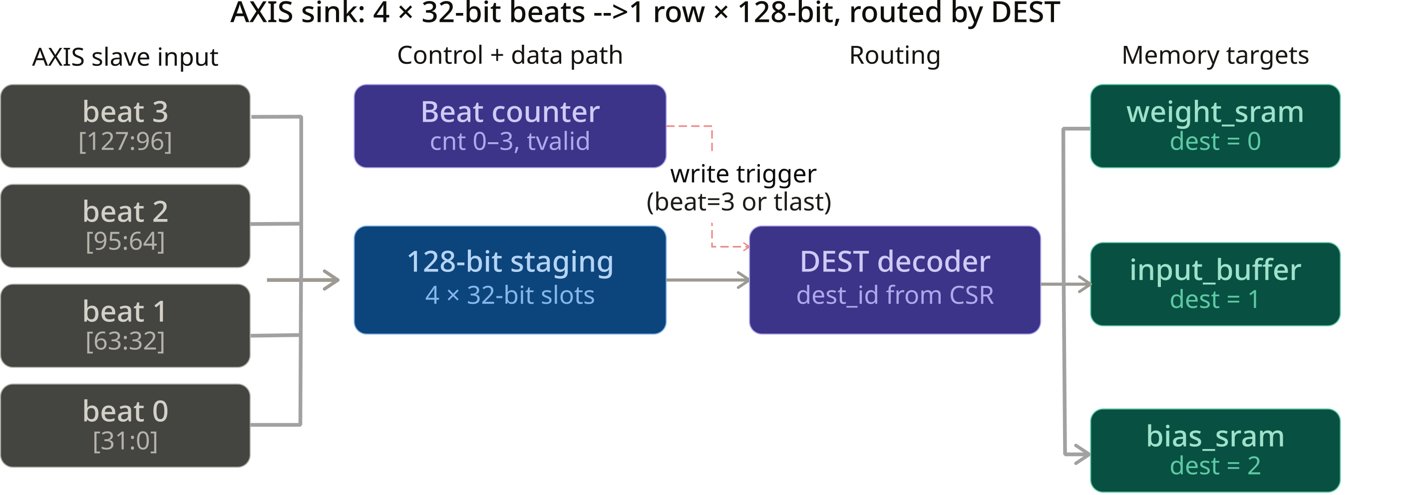
[picture p14: Thesis/paper/pics/2-7.png]
	
	\caption{cim\_axi\_stream\_sink的4-beat到128-bit行装配示意图}
	\label{fig:axis_sink}
\end{figure}

从微结构上看，\texttt{cim\_axi\_stream\_sink}本质是一个由\texttt{cfg\_dest}选择目的地、按beat计数驱动的小型状态机。它内部维护一个128位移位寄存器：每当一个32位beat有效（\texttt{tvalid \&\& tready}）时，就把新数据移入寄存器高位、原有数据整体右移一个字；当累计到第4个beat时，4个32位字恰好拼成一整行128位，于是拉高一拍对应存储模块的整行写使能，并据当前行计数、tile计数给出写地址，随后行计数自增，写满16行即tile计数自增。状态机同时用\texttt{beat\_count}与传入的\texttt{cfg\_len}、\texttt{tlast}做交叉校验：若在到达预期beat数之前就收到\texttt{tlast}则报underflow、若超过预期仍未收到则报overflow，这些状态经CSR回报给软件用于断言。该设计的特点是让\texttt{s\_axis\_tready}恒为高：由于BRAM写是单周期完成、sink内部不存在需要排队的情形，因此无需对DMA反压；真正的反压沿（当DDR或总线暂时供不上数据时）由DMA引擎一侧自然向PS方向回传，sink只需被动接收即可。这样既简化了握手逻辑，又不会因sink侧的人为停顿而拖慢传输。

\subsection{S2MM读回通路}

推理结果的读回走output\_buffer→\allowbreak cim\_axi\_stream\_source→\allowbreak M\_AXIS\_RESULT→\allowbreak axi\_dma/S\_AXIS\_S2MM→\allowbreak S\_AXI\_HP1→\allowbreak DDR的批量stream路径。\newline\texttt{cim\_axi\_stream\_source}采用5状态FSM（IDLE→WAIT→WARMUP→READ→SEND）处理BRAM的2-cycle读延迟与非4对齐末字打包。每4个INT8结果打包为一个32-bit AXI4-Stream beat，末拍置tlast=1告知DMA结束接收。Python驱动侧采用direct register mode直接操作S2MM的DMACR/DA/LENGTH寄存器，并实现双缓冲交替机制避免缓冲区复用问题。

\section{Layer Fusion: 层间融合}

针对连续全连接层（如LeNet-5 FC3→FC4→FC5或MLP FC1→FC2），标准数据流需要在层间执行完整的S2MM读回→DDR→MM2S重新加载循环。本设计在\texttt{cim\_axi\_lite\_slave}中实现了OBUF→IBUF内部硬件拷贝的层融合（Layer Fusion）机制。需要说明的是，本文所称"层融合"特指OBUF→IBUF的片上硬件直拷（层间数据在片内直接转发、不经DDR往返），与深度学习框架中将Conv+BN+ReLU等多个算子合并为单一计算核的"算子融合"（operator fusion）是不同的，不应混淆。

融合FSM包含4个状态（F\_IDLE→F\_WAIT\_MUX→F\_PACK→F\_WRITE），工作流程为：OBUF按字节读取INT8结果→在硬件内部重新打包为128-bit tile字（16 INT8/tile）→直接写入IBUF。通过F\_WAIT\_MUX状态处理OBUF读路径的流水线延迟（always\_comb MUX传播 + BRAM registered read共2周期），确保byte-to-tile装配的字节对齐正确性。

约束条件为融合元素数$n\_elements \leq \text{MAX\_OUT\_DIM} = 256$，单次融合耗时$n\_elements + 1 + \lceil n\_elements/16 \rceil \times 2$周期。以FC1→FC2（128元素）为例，融合延迟约1.5 $\mu$s，远小于等效的DMA S2MM+MM2S往返延迟（数十毫秒）。图\ref{fig:layer_fusion}（a）对比了有无层融合两种数据流的层间延迟，无融合时FC1$\to$FC2需经S2MM$\to$DDR$\to$MM2S往返（数十毫秒），融合时仅需OBUF$\to$IBUF硬件直拷（约1.5~$\mu$s）；（b）给出了融合FSM的状态转移（F\_IDLE$\to$F\_WAIT\_MUX$\to$F\_PACK$\to$F\_WRITE）。

为支持多层权重共存，系统中增设了CSR\_WEIGHT\_BASE和CSR\_BIAS\_BASE偏移寄存器，使不同FC层的权重/偏置可在SRAM中存储于不同offset。FC1权重存于tile 0..N1-1，FC2权重存于tile N1..N1+N2-1，batch推理时仅需切换base寄存器即可在不同层之间切换。Python驱动侧的\texttt{setup\_fc\_fused\_pair()}预加载双layer权重，\texttt{infer\_fc\_fused\_batch()}实现批融合推理，无需每张图像重新加载FC2权重。

\begin{figure}[H]
	\centering
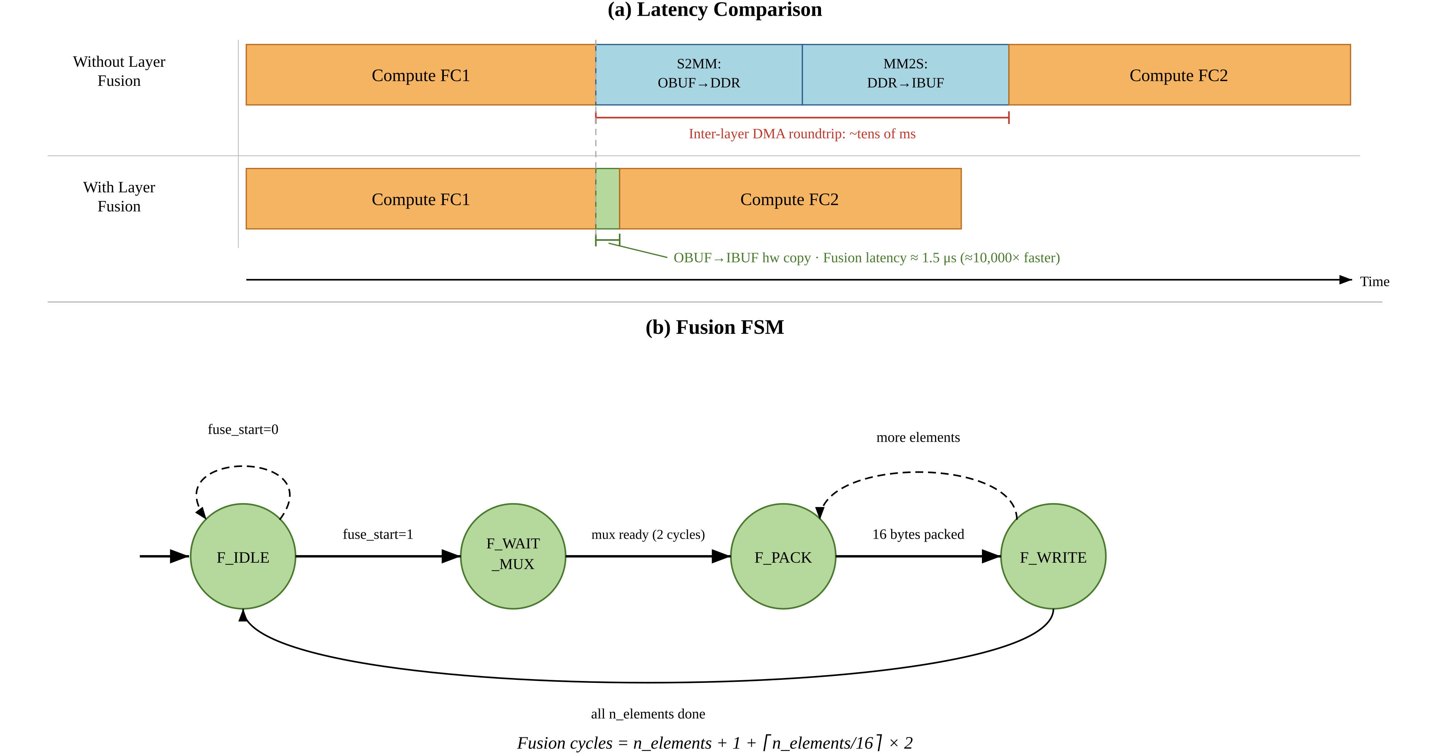
[picture p15: Thesis/paper/pics/2-8.png]
	
	\caption{层融合（Layer Fusion）机制示意图}
	\label{fig:layer_fusion}
\end{figure}

层融合之所以能带来数量级的层间延迟收益，根源在于它彻底绕开了"片上→DDR→片上"这条昂贵的往返路径。在没有融合的标准数据流中，上一层算完的INT8结果要先经S2MM通道DMA回DDR，再由下一层经MM2S通道DMA读回片上，这一来一回不仅要两次穿越HP端口，还要承担两次DMA描述符配置的软件开销，单次往返动辄数十毫秒；而融合路径让上一层的OBUF结果直接在片内通过硬件通路重打包后写入下一层的IBUF，全程不出片、不经DDR、不需软件介入，单次仅约$1.5\,\mu\text{s}$。这里需要处理的一个工程细节是数据排布的转换：OBUF以字节（INT8）为粒度存放结果，而IBUF要求以128位tile字（每字16个INT8）为粒度写入，因此融合FSM必须把连续的字节流重新按16个一组打包成tile字；又因为OBUF的读出路径存在组合MUX传播加BRAM寄存读共两拍的流水延迟，状态机专门设置了\texttt{F\_WAIT\_MUX}等待级来吸收这一延迟，保证字节到tile装配时的字节对齐严格正确，从而维持逐位一致。

\section{流水线状态机与TILE\_SPLIT优化}

核心引擎的FSM包含多个状态，其中计算数据通路划分为以下流水线级：

计算流水线（每个input-block迭代）：
\begin{enumerate}
	\item ST\_FETCH / ST\_WAIT\_SRAM：发出BRAM读地址，等待权重SRAM输出（1 cycle latency）；
	\item ST\_XEFF\_REG：输入BRAM输出就绪 + 零点减法 → 锁存x\_eff\_reg；
	\item ST\_MAC（或ST\_MAC\_Q0--Q3）：cim\_tile以时分复用方式计算 x\_eff\_reg $\times$ w\_tile\_reg → 锁存tile\_psum\_reg。当TILE\_SPLIT\_FACTOR=4时，该级按四个切片（Q0--Q3）顺序执行，每个切片含锁存（\_L）、乘积寄存（\_M）与累加子状态，每次处理4列MAC、由4个物理乘法器复用覆盖全部16列；
	\item ST\_COMPUTE：psum\_accum += tile\_psum\_reg（寄存器加法）。
\end{enumerate}

输出流水线（每个output neuron，所有IB迭代完成后）：
\begin{enumerate}
	\setcounter{enumi}{4}
	\item ST\_BIAS\_ADD → ST\_ACTIVATE：加偏置 → ReLU激活；
	\item ST\_STORE：64位乘法（psum $\times$ requant\_mult）→ 锁存prod\_r；
	\item ST\_SHIFT\_CLAMP → ST\_WRITE\_OBUF：移位 + 舍入 + clamp → 写输出缓冲。
\end{enumerate}

上述计算流水线与输出流水线由核心引擎的FSM统一调度，其完整状态转移如图\ref{fig:core_fsm}所示，图中的内层循环（橙色，每IB迭代）完成取数、零点减法与MAC累加；外层循环（蓝色，每output block）完成偏置累加、激活、重量化与结果写回。单一FSM经CSR配置即可服务任意层维度。包含按input-block迭代的内层MAC循环与按output-block迭代的外层循环。

为进一步提升时钟频率，后量化路径（原ST\_SHIFT\_CLAMP）被拆分为ST\_SHIFT（执行rounding加法并锁存pre\_shift\_r）和ST\_CLAMP（barrel shift + clamp至INT8范围）两级流水。该拆分将包含多级CARRY4进位链的组合路径分割为两段，每段关键路径显著缩短。配合Tile内的乘法器时分复用与乘积寄存器流水，本设计在PAR\_OB=2配置下于64 MHz完成时序收敛（WNS +0.013 ns，0个failing endpoints），PAR\_OB=3配置亦在64 MHz收敛（WNS +0.158 ns）；在75 MHz下出现时序违例（PAR\_OB=2时WNS -2.290 ns、72个failing endpoints），在80 MHz下违例更严重（WNS -3.324 ns、2212个failing endpoints），但75/80 MHz配置在室温上板功能完全正确、逐元素结果与golden model一致，作为功能性超频实验保留。

\begin{figure}[H]
	\centering
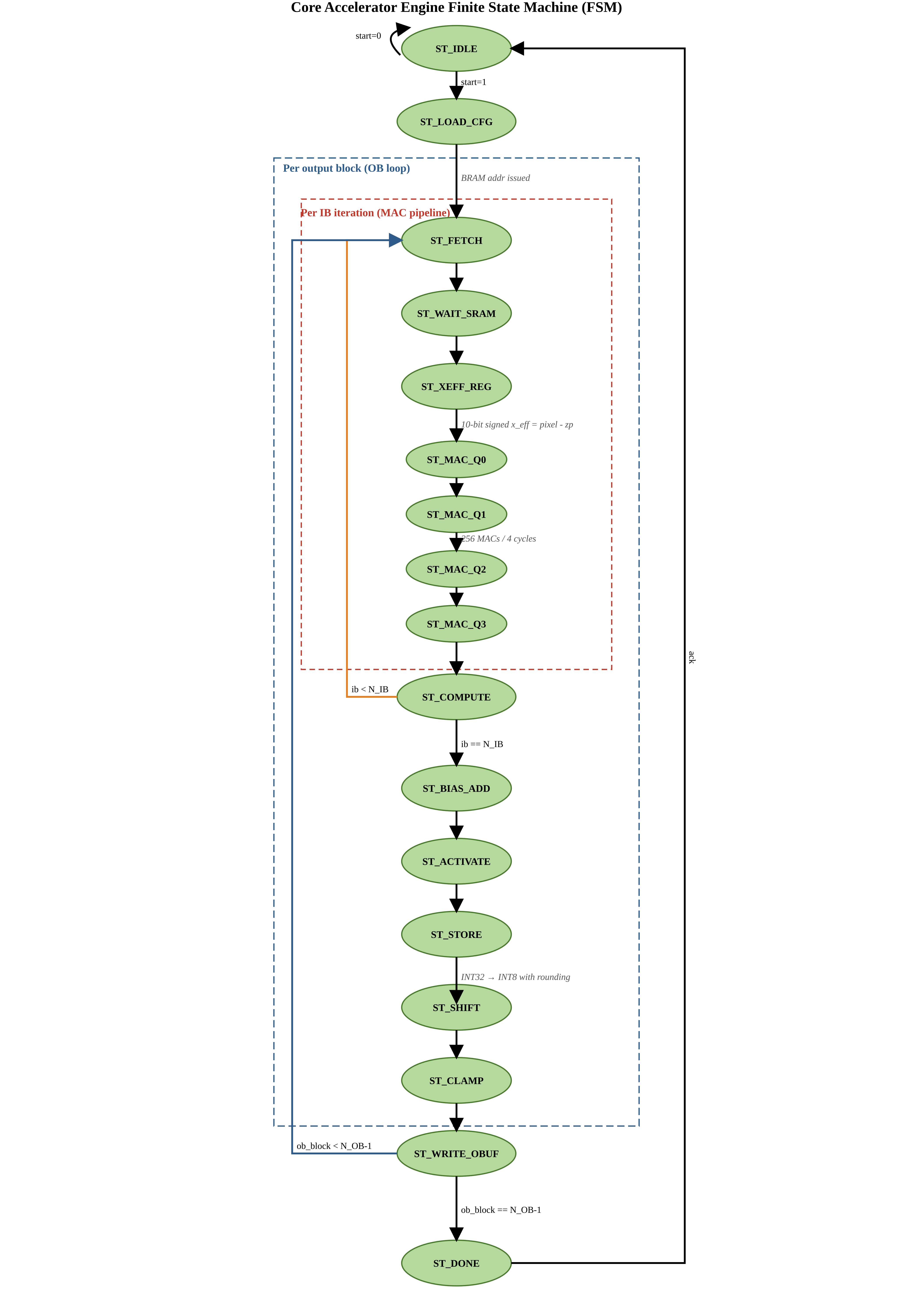
[picture p16: Thesis/paper/pics/2-9.png]
	
	\caption{核心加速器引擎FSM状态转移图}
	\label{fig:core_fsm}
\end{figure}
把上述流水级放回整体循环来看，单层的总周期数可以拆解为三部分之和：每个output-block都要把$N_{IB}$个input-block逐个取数并累加，随后对$\text{PAR\_OB}\times\text{TILE\_ROWS}$个输出神经元做一次偏置累加、激活与重量化，如此重复$\lceil N_{OB}/\text{PAR\_OB}\rceil$组，再加上启动、配置与收尾的固定开销。这一可解析的周期模型可与硬件性能计数器读到的实测周期相互印证（各层实测周期见后文表\ref{tab:mlp_perf}与表\ref{tab:lenet5_perf}）。由于MAC段采用时分复用、且偏置/激活/重量化等后处理对每个输出神经元串行执行，单Tile的\emph{有效}MAC吞吐率远低于$16\times16$阵列的峰值256 MAC/cycle，系统级有效吞吐主要由这些串行段而非乘法器峰值决定。提升有效吞吐的可行方向是提高输出并行度\texttt{PAR\_OB}（本设计已借助时分复用在板级部署PAR\_OB=2/3）并对输出/重量化段做并行化或流水化，相关的并行度扫描与瓶颈分析见第4章中关于PAR\_OB扫描的小节。在拆分因子的取舍上，\texttt{TILE\_SPLIT\_FACTOR=4}是一个典型的"以吞吐换频率"决策：它把原本一拍完成的16列MAC摊成四拍并叠加乘积寄存器流水，单看MAC吞吐率确实下降，但换来的是把组合关键路径大幅压缩，使设计能够在64 MHz下闭合时序，同时也为偏置/激活/重量化等非MAC流水级以及双缓冲乒乓的重叠争取到了时序裕量。

综合权衡下，更高的时钟频率与更充分的流水重叠所带来的收益，超过了单纯MAC吞吐率下降的损失。本文统一以64 MHz签核频率作为性能数据的标称频率：计算核延迟由性能计数器实测周期数除以64 MHz折算（周期数本身与频率无关）；端到端延迟为板级实测值，因受DMA带宽主导、已由75 MHz与80 MHz对照实测验证与PL时钟频率基本无关，故该值对工作频率不敏感。75/80 MHz配置存在时序违例但室温上板功能正确、逐元素结果bit-exact，作为功能性超频实验在下文时序分析中单独讨论。

\section{AXI4-Lite CSR接口}

系统通过AXI4-Lite slave接口与外部控制器（PS ARM或PicoRV32）交互，采用14位地址空间（16KB），CSR地址映射如表\ref{tab:csr_map}所示。为更直观地展示CSR地址空间的布局，图\ref{fig:csr_map}以地址条形图的形式给出了各功能区段的分布。

\begin{table}[H]
	\centering
	\caption{CSR地址映射}
	\label{tab:csr_map}
	\begin{tabularx}{\textwidth}{l>{\raggedright\arraybackslash}X}
		\toprule
		地址范围 & 功能 \\
		\midrule
		0x000--0x00C & 控制/状态/IRQ寄存器 \\
		0x010--0x02C & 层配置（IN\_DIM, OUT\_DIM, N\_IB, N\_OB, 量化参数） \\
		0x030--0x03C & 性能计数器（cycle count, MAC count） \\
		0x040 & argmax预测结果 \\
		0x050--0x058 & Stream控制（DEST, LEN, STATUS） \\
		0x060--0x06C & Result/S2MM控制 + Ping-Pong CTRL \\
		0x070--0x080 & Layer Fusion控制 + Weight/Bias Base偏移 \\
		0x100--0x2FF & Logits回读窗口 \\
		\bottomrule
	\end{tabularx}
\end{table}

从功能上看，整个16 KB的CSR空间大致可分为五个区段。最低端是控制与状态区：\texttt{CSR\_CTRL}承载start、清done、软复位以及stream/legacy路径选择等控制位，\texttt{CSR\_STATUS}回报busy/done与当前FSM状态，\texttt{CSR\_IRQ\_EN}/\texttt{CSR\_IRQ\_STATUS}则提供"算完中断"的使能与写1清除。其次是层配置区，集中存放\texttt{IN\_DIM}、\texttt{OUT\_DIM}、由两者推得的\texttt{N\_IB}/\texttt{N\_OB}以及量化相关的\texttt{REQUANT\_MULT}、\texttt{REQUANT\_SHIFT}、\texttt{INPUT\_ZP}、\texttt{ACT\_MODE}——一层换一组配置即可，无需改动RTL。第三段是性能计数区：硬件内置了周期计数器与MAC计数器（各以高/低32位两个寄存器读出），使软件可以直接读到某次推理实际消耗的时钟周期与MAC次数，这也是后文延迟分解与理论吞吐率核对的数据来源。第四段是数据通路控制区，依次容纳stream传输的目的地/长度/状态、S2MM结果回读控制、乒乓bank翻转位\texttt{CSR\_PING\_CTRL}、层融合的启动/长度/状态，以及多层权重共存所需的\texttt{CSR\_WEIGHT\_BASE}/\texttt{CSR\_BIAS\_BASE}基址偏移。最高端则是较大的存储窗口区，用于按地址直接读出logits等结果，配合argmax寄存器\texttt{CSR\_PRED\_CLASS}给出预测类别。这种"控制—配置—计数—数据通路—结果"分区清晰的地址布局，使得无论控制方是ARM还是PicoRV32，固件都只需按同一张地址表读写即可驱动整个加速器。

\begin{figure}[H]
	\centering
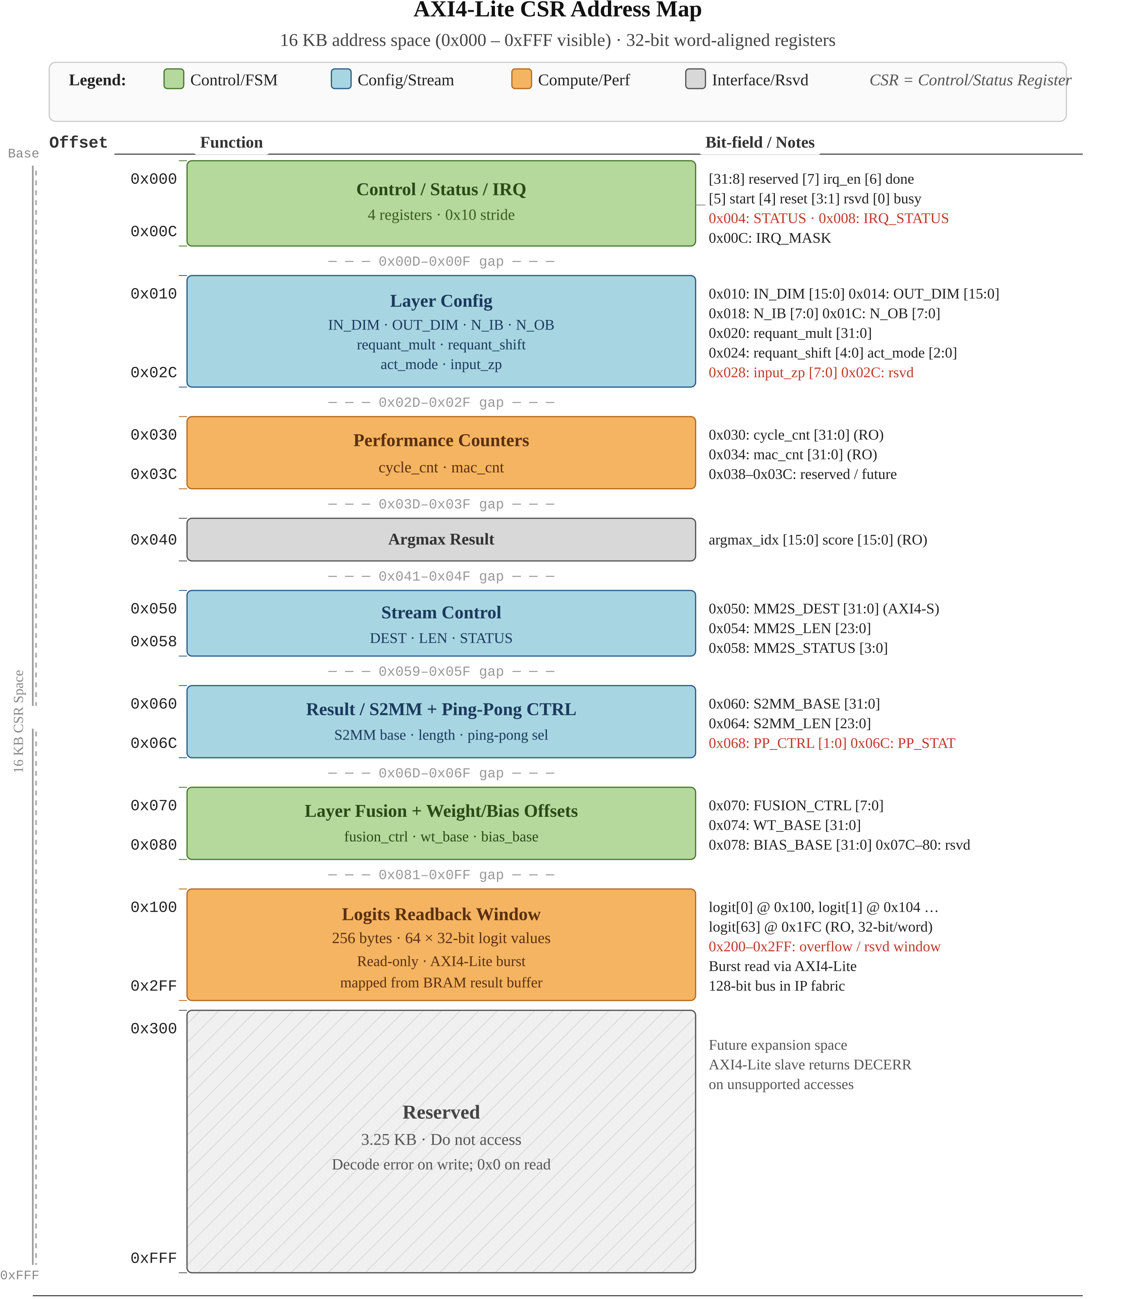
[picture p17: Thesis/paper/pics/2-10.png]
	
	\caption{AXI4-Lite CSR地址空间映射条形图}
	\label{fig:csr_map}
\end{figure}

% ====================================================================
\chapter{PicoRV32 RISC-V软核集成}
% ====================================================================

\section{设计动机}

前述ARM PS控制模式下，CIM加速器依赖ARM Cortex-A9进行推理调度与数据搬运。为实现纯PL侧自主推理能力，本设计集成PicoRV32开源RISC-V软核（YosysHQ，MIT License）替代ARM PS。其优势包括：

\begin{itemize}
	\item 单文件实现（\texttt{picorv32.v}），RV32IM指令集；
	\item 资源开销低且反直觉地轻量：PicoRV32核心约1,500个LUT，完整子系统（含bridge、UART TX、FW/Result BRAM接口）因去除了axi\_dma及关联AXI互连，总LUT与FF反而比ARM模式更少（LUT减少336个、FF减少2136个，详见表\ref{tab:util_rv32}和表\ref{tab:rv32_vs_arm}），以更少的逻辑资源实现更自主的控制；
	\item 成熟的native memory interface，适合直接桥接到CIM CSR。
\end{itemize}

最终目标是让CIM加速器在纯PL中自主运行推理，不依赖PS控制。

在软核选型上，本设计在若干主流开源RISC-V核之间做了权衡。VexRiscv虽然性能可观、可裁剪性强，但其核是由SpinalHDL生成的，引入它意味着要额外搭建一套SpinalHDL工具链；SERV是面积极小（约200 LUT）的位串行核，但正因为是串行执行，逐位处理使其运行速度过慢，不适合承担逐字写CSR这类需要一定吞吐的控制任务；Ibex则是工业级、配置完备的RV32IMC核，但相对偏大、配置也更复杂。相比之下，PicoRV32以"单文件Verilog、约1,500 LUT、MIT许可、支持RV32IM（含乘法指令）、且对外暴露极简的native memory interface"这几个特点胜出：单文件意味着可以直接加入Vivado工程而无需任何外部生成器；约1,500 LUT的占用相对xc7z020全片5万余个LUT几乎可以忽略，不会挤占CIM的资源；RV32IM则足以编译运行驱动推理所需的C固件。尤其关键的是其native memory interface——只有valid/ready/addr/wdata/rdata等寥寥数根信号、不涉及AXI或Wishbone的复杂握手，使得后续把它桥接到CIM的CSR地址空间变得相当直接。综合这些因素，PicoRV32是在"足够小、足够成熟、足够好接"三者之间最平衡的选择。

PicoRV32系统与ARM版本共享相同的CIM IP RTL（含TILE\_SPLIT\_FACTOR=4、乘法器时分复用、双缓冲、Layer Fusion、WEIGHT\_BASE/BIAS\_BASE等全部优化），本模式部署PAR\_OB=2配置，同样基于64 MHz签核频率。以下各节给出的性能数据基于64 MHz频率。

\section{系统架构}

PicoRV32集成后的系统顶层架构如图\ref{fig:rv32_soc}所示：PS仅承担固件加载与结果回读，PicoRV32子系统（核心 + bridge + 双端口FW/Result BRAM + AXI GPIO复位控制）在纯PL侧自主驱动推理，右侧CIM IP保持零RTL改动。

\begin{figure}[H]
	\centering
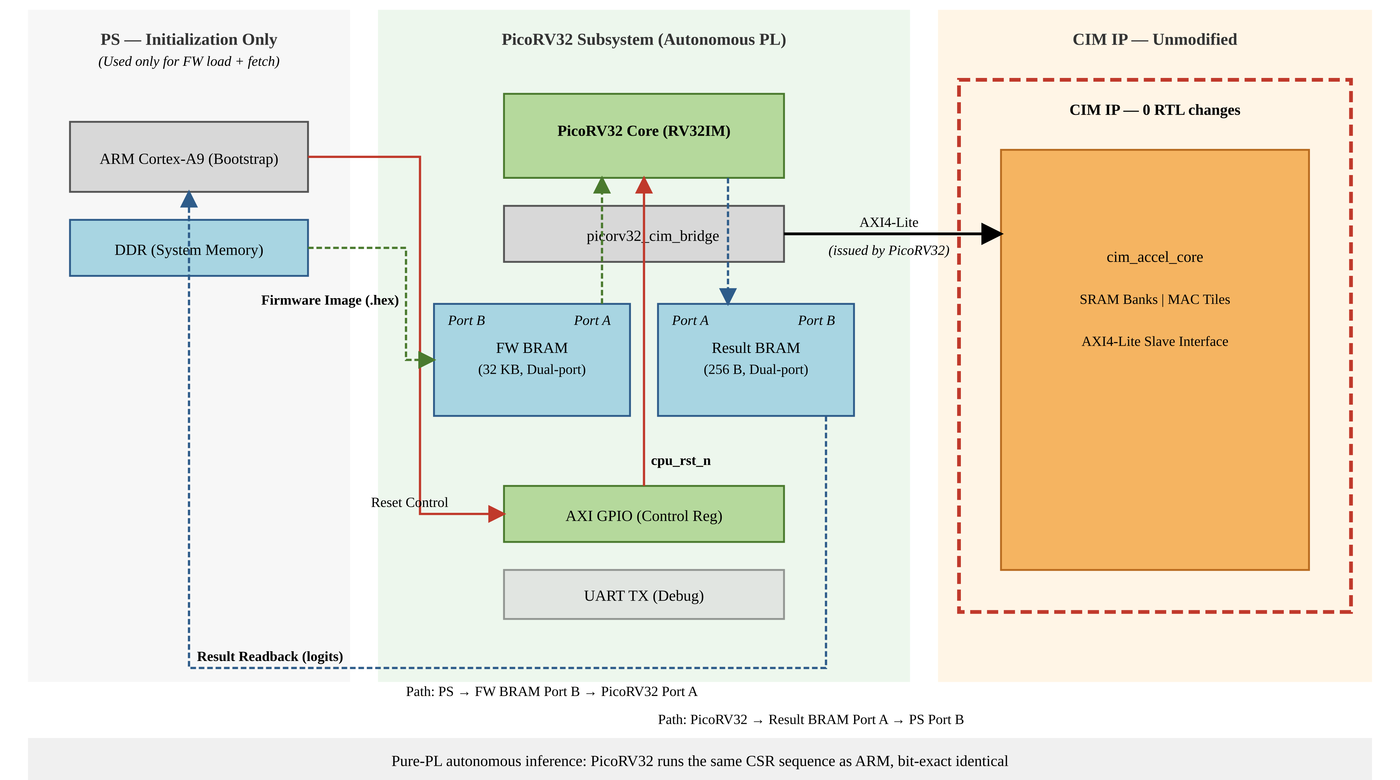
[picture p18: Thesis/paper/pics/3-1.png]
	
	\caption{PicoRV32 + CIM SoC系统框图}
	\label{fig:rv32_soc}
\end{figure}

系统设计要点包括：

（1）CIM IP不做修改：PicoRV32通过mini AXI master发送与ARM完全相同的AXI事务，CIM IP的AXI slave接口无需任何改动，确保了与ARM控制路径的完全兼容。

（2）双端口FW BRAM：固件通过PS侧AXI写入FW BRAM port B，而不是烧写到bitstream中。这使得每次更换测试图片无需重新生成bitstream，只需重新加载firmware.hex。FW BRAM容量32KB，足以容纳784→16→10小型MLP模型的权重数据与C固件代码（共约17.3KB）。

（3）Result BRAM：PicoRV32将推理结果（预测类别、logits、magic标记）写入Result BRAM，PS通过AXI读取结果。这避免了PL侧UART与PS侧USB的连接性问题。

（4）CPU复位控制：PS通过AXI GPIO控制cpu\_rst\_n信号，实现hold → write firmware → release的操作流程。

\section{Bus Bridge与地址映射}

\texttt{picorv32\_cim\_bridge}模块将PicoRV32的native memory interface桥接到各外设，地址映射如下表所示。Bridge根据地址高位进行译码，对CIM CSR区域的访问转换为AXI读写事务。PicoRV32访问CIM的流程与ARM通过MMIO访问完全等价，固件中的CSR读写函数直接对应AXI事务。该32位地址空间的整体布局如图\ref{fig:rv32_addrmap}所示，图中低地址段为FW BRAM（代码+权重+数据），0x4000\_0000段映射至CIM CSR/存储窗口（经bridge转为AXI4-Lite），0x8000\_0000段为UART TX，0xC000\_0000段为Result BRAM，其余为未映射区。

\begin{table}[H]
	\centering
	\caption{PicoRV32地址映射}
	\begin{tabularx}{\textwidth}{l>{\raggedright\arraybackslash}Xl}
		\toprule
		地址范围 & 大小 & 设备 \\
		\midrule
		0x0000\_0000 -- 0x0000\_7FFF & 32KB & FW BRAM (port A) \\
		0x4000\_0000 -- 0x4000\_3FFF & 16KB & CIM CSR / 存储窗口 \\
		0x8000\_0000 & 4B & UART TX数据寄存器 \\
		0x8000\_0004 & 4B & UART TX状态寄存器 \\
		0xC000\_0000 -- 0xC000\_00FF & 256B & Result BRAM (port A) \\
		\bottomrule
	\end{tabularx}
\end{table}

\begin{figure}[H]
	\centering
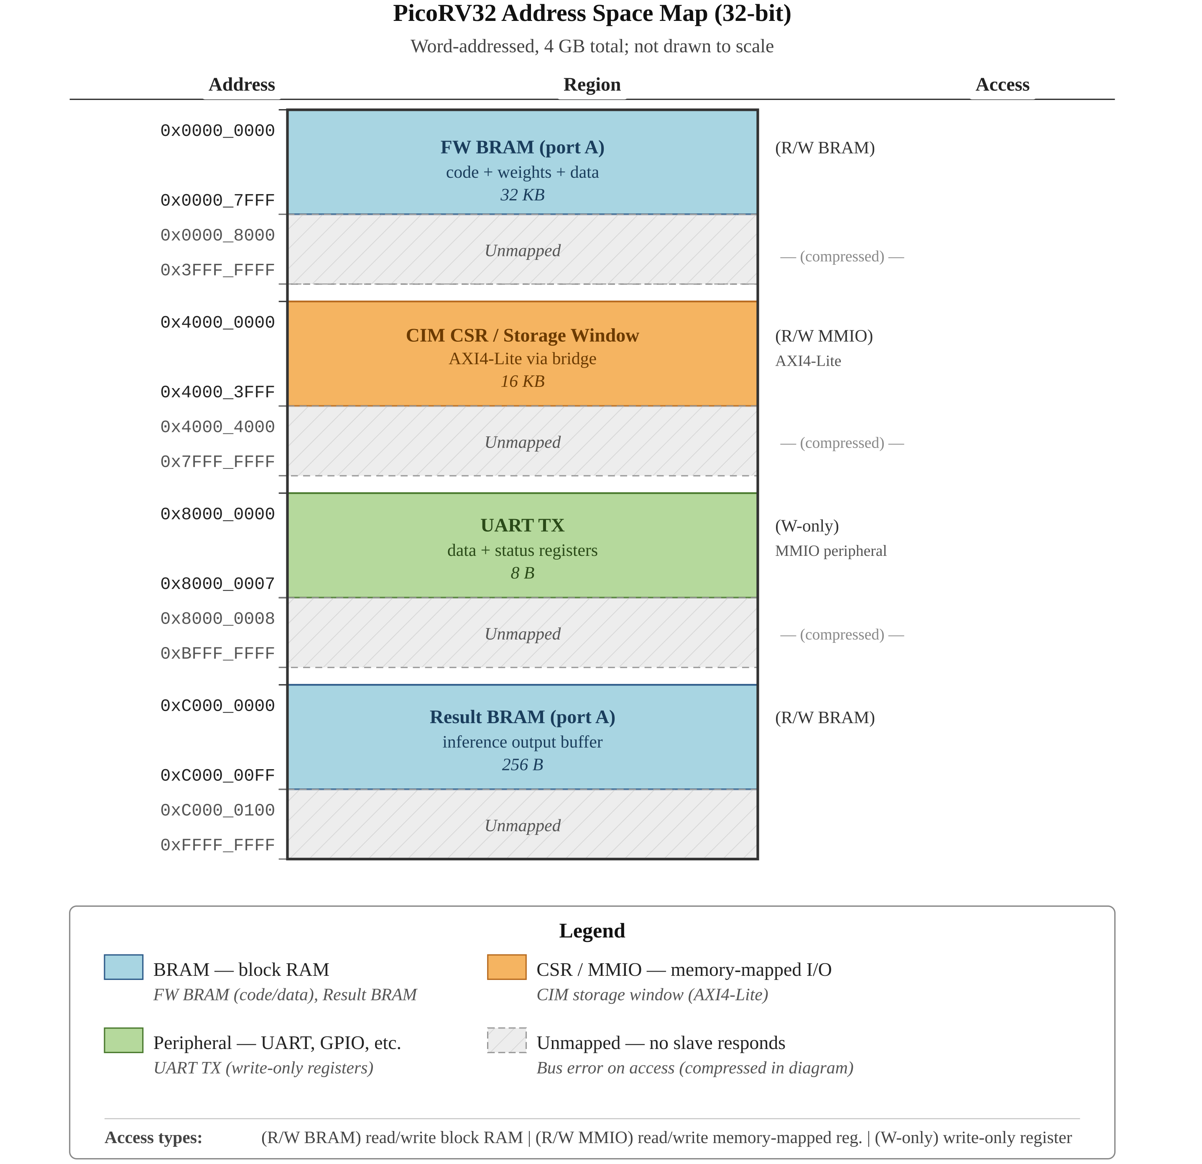
[picture p19: Thesis/paper/pics/3-2.png]
	
	\caption{PicoRV32地址空间布局}
	\label{fig:rv32_addrmap}
\end{figure}
具体而言，\texttt{picorv32\_cim\_bridge}本身是一个小型状态机。PicoRV32发起访存时拉高\texttt{mem\_valid}并给出地址、写数据与字节选通；bridge在\texttt{S\_IDLE}态对地址高位译码，判断目标是FW BRAM、CIM CSR、UART还是Result BRAM，再分别进入相应的处理分支——访问BRAM类外设走读/写直通，访问CIM则进入等待AXI事务完成的子状态，处理完毕统一回到\texttt{S\_DONE}拉高一拍\texttt{mem\_ready}通知CPU、随后返回\texttt{S\_IDLE}。其中通往CIM的分支尤为关键：由于PicoRV32的native总线不能直接驱动AXI，bridge内嵌了一个mini AXI master，把一次native写/读翻译成标准的AXI4-Lite写（AWVALID+WVALID→等BVALID）或读事务。这样CIM IP的AXI slave接口所看到的与ARM PS发来的事务在时序和语义上完全一致。这一层翻译使得第2章设计的整个CIM IP（接口层之外的计算层与存储层）在更换控制核时能够不修改RTL，最大程度复用已验证的设计。

\section{模型规模约束}

虽然PicoRV32反而节省了LUT资源，但是固件中需要放入32KB FW BRAM，模型规模受到限制(将MLP模型缩小为784→16→10)。FW BRAM中需要存储：C固件代码、权重数据（INT8打包）、偏置数据（INT32）与输入数据。对于784→16→10的小型MLP模型，数据量约为：

\begin{equation}
	784 \times 16 \times 1 + 16 \times 10 \times 1 + (16 + 10) \times 4 + 784 \times 1 \approx 13.3\text{KB}
\end{equation}

加上C固件代码约4KB，总计约17.3KB，可以放入32KB BRAM中。该模型在MNIST测试集上INT8量化推理准确率超过95\%。

另外，关于PicoRV32版本可支持的模型规模还需补充说明，32KB FW BRAM在扣除约4KB固件代码后，约余28KB用于权重、偏置与输入，至多可容纳约28K个INT8参数。例如784→32→10（约25K参数）尚可放入，而784→128→10（约102K参数）或LeNet-5则远超此容量——这正是PicoRV32模式仅验证784→16→10小型MLP、而把较大网络留给ARM模式的根本原因。若要在纯PL侧支持更大模型，需扩大FW BRAM容量，或改由片外存储分批载入权重（代价是引入额外搬运开销）。本项目暂未对此展开深入研究。

\section{PicoRV32子系统设计}

PicoRV32子系统的最终架构采用混合PS+PL设计：通过Vivado Block Design纳入Zynq PS以提供时钟与AXI通道，PicoRV32软核在PL侧自主运行，经由总线桥接模块（\texttt{picorv32\_cim\_bridge}）将native总线事务翻译为标准AXI4-Lite事务以访问CIM CSR、FW BRAM与UART TX。增设双端口Result BRAM：PicoRV32将推理结果写入其一端口，PS通过AXI BRAM Controller从另一端口读出。FW BRAM同样采用双端口结构，PS在运行时通过AXI BRAM Controller写入固件（先拉低\texttt{cpu\_rst\_n}复位CPU，写入完毕后释放复位），使单一bitstream即可覆盖全部测试图片而无需重新综合。

% ====================================================================
\chapter{FPGA验证与性能评估}
% ====================================================================

\section{验证方法学}

本项目建立了"Python golden model → VCS仿真 → PYNQ上板"三层一致的验证方法学：

第一层：Python bit-exact参考模型。\texttt{golden\_model.py}以纯整数算术实现与硬件完全相同的计算流程（零点减法、MVM、偏置累加、ReLU、重量化），输出hex格式测试向量供RTL仿真和板级验证使用。

具体而言，该参考模型的核心是一组与RTL流水级一一对应的纯函数：
\newline
\texttt{apply\_zero\_point}完成零点减法、\texttt{cim\_mvm}完成矩阵乘加、\texttt{add\_bias}加偏置、\texttt{relu}做激活、\texttt{requantize\_int32\_to\_int8}做带舍入的定点重定标，再由\texttt{infer\_layer}与\texttt{infer\_mlp}把它们串接为单层与多层推理。这些函数被刻意写成与第2章硬件数据通路的每一级严格对应，并采用与硬件一致的零点处理约定（输入像素先按$[0,255]$无符号取值、零扩展后再减去零点，得到\emph{有符号}有效输入），从而保证软件参考值与硬件输出在每一拍都一致。针对卷积，模型提供了\texttt{im2col\_explicit}与基于地址表的\texttt{im2col\_implicit}两套展开实现，把卷积转化为矩阵乘法后交由同一MVM内核处理，并以\texttt{infer\_conv\_layer}给出卷积层参考输出；\texttt{calibrate\_requant}则用于离线标定每层的requant\_mult与requant\_shift。模型自带的\texttt{self\_test}可在完全脱离硬件的情况下回归整条数值流程，是后续所有bit-exact比对的"真值"来源。

第二层：VCS RTL仿真。采用"单元级→阵列级→系统级"分层验证策略：
\begin{itemize}
	\item tb\_cim\_tile：CIM Tile单元测试，103个测试向量（含3个定向测试与100个随机向量），验证MAC运算正确性；
	\item tb\_cim\_accel\_core：系统级MVM测试，覆盖随机向量与边界用例（全零、全$-128$、最大维度等）；
	\item tb\_mnist\_e2e：MNIST端到端测试，784→128→10两层MLP，与golden model逐元素对比。
\end{itemize}

通过\texttt{run\_regression.sh}脚本一键运行全部测试并汇总PASS/FAIL结果。

这三个testbench覆盖了从原子单元到完整网络的不同验证粒度。\texttt{tb\_cim\_tile}用103个测试向量专门验证16×16阵列的MAC正确性；\texttt{tb\_cim\_accel\_core}则搭建一个IN=32、OUT=PAR\_OB×16（即恰好一组output-block）的小层，通过整行写权重、整tile写输入的接口把数据灌入存储，触发计算后读回输出缓冲并与片内golden逐元素比对——这里有一个容易出错的细节被特别处理：golden计算\,x\_eff\,时必须把输入像素按$[0,255]$的无符号值零扩展后再减去零点（对应RTL中的\texttt{\$signed(\{1'b0, x\_tile\})}），得到\emph{有符号}的x\_eff，而不能把原始8位像素直接按有符号解释，否则当输入大于等于128时软硬件就会分歧；此外该testbench刻意构造了全零、全$-128$、最大维度等边界用例以暴露符号、进位与边界处理上的潜在缺陷。\texttt{tb\_mnist\_e2e}则以784→128→10两层MLP做端到端验证。三者经\texttt{run\_regression.sh}统一驱动，任何一处逐位不一致都会被立即捕获并标红。

第三层：PYNQ-Z2上板验证。将bitstream与hwh文件部署到PYNQ板，通过Python驱动程序（\texttt{cim\_driver.py}的\texttt{CIMModel}类），加载真实MNIST手写数字图片，逐层执行推理并与golden model对比。

为使"硬件与软件逐位一致"这一论断可被逐层审计，板级驱动还内置了逐层比对开关：开启后，驱动会在每层推理完成时把该层的输入、硬件输出、golden输出以及二者的逐元素差异分别dump到约定的日志目录，并对每层断言硬件结果与golden数组完全相等。这样一旦某层出现偏差，便能立即定位到具体的层与具体的元素，而不必从最终分类结果反向猜测出错环节。正是依托这一基础设施，本文后续才得以给出"全部硬件输出与软件参考模型bit-exact一致"的强结论，而非仅以分类准确率间接佐证。

上述三层验证的整体流程与层间bit-exact对比关系如图\ref{fig:verify_flow}所示。

\begin{figure}[H]
	\centering
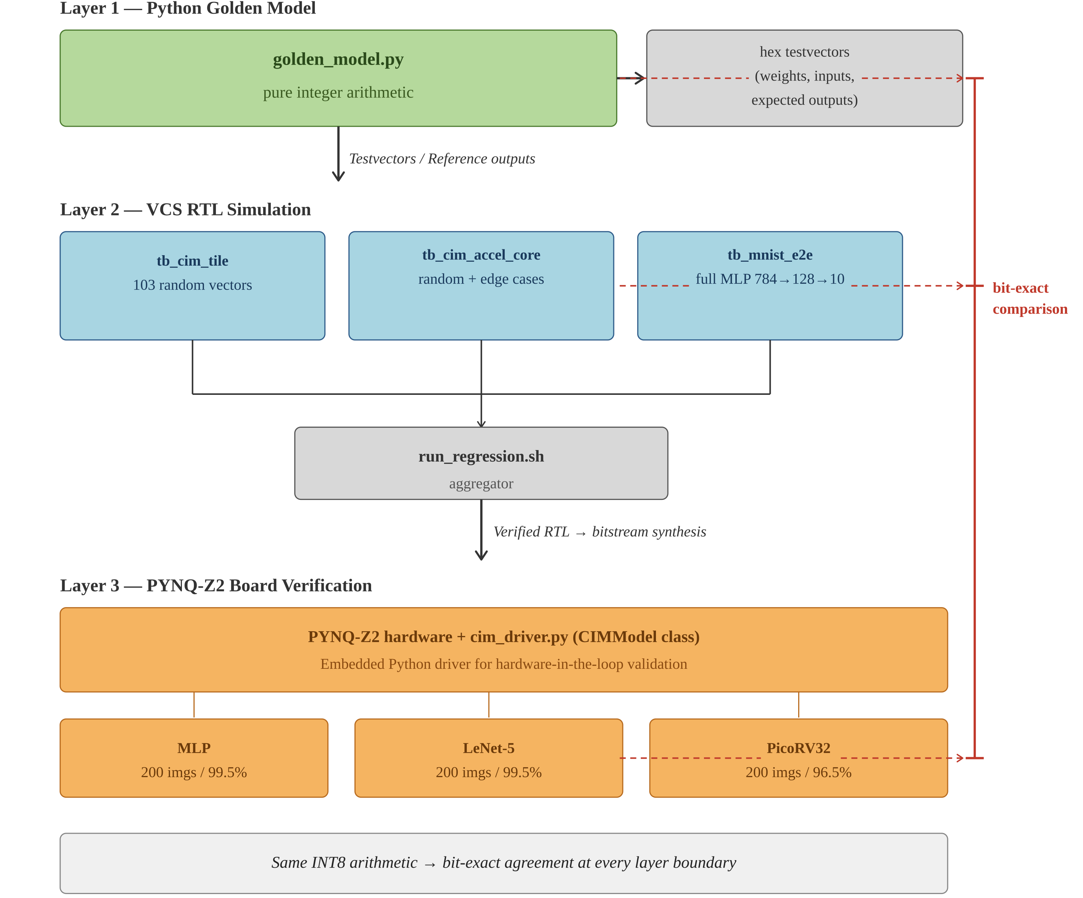
[picture p20: Thesis/paper/pics/4-1.png]
	
	\caption{三层一致的验证方法学}
	\label{fig:verify_flow}
\end{figure}

\section{PYNQ-Z2综合结果}

设计在Vivado 2024.2中针对Zynq-7020（xc7z020clg400-1）进行综合与实现。表\ref{tab:util_final}列出了最终配置（Phase B双缓冲 + Layer Fusion + TILE\_SPLIT\_FACTOR=4 + 乘法器时分复用，PAR\_OB=2，64 MHz）下的资源使用量。

\begin{table}[H]
	\centering
	\caption{CIM SoC资源占用（最终配置，ARM模式，64 MHz，PAR\_OB=2，PYNQ-Z2）}
	\begin{tabularx}{\textwidth}{l>{\centering\arraybackslash}X>{\centering\arraybackslash}X>{\centering\arraybackslash}X}
		\toprule
		资源类型 & 使用量 & 可用量 & 占用率 \\
		\midrule
		Slice LUT & 15567 & 53,200 & 29.26\% \\
		Slice Register (FF) & 16790 & 106,400 & 15.78\% \\
		Block RAM (36Kb) & 123.5 & 140 & 88.21\% \\
		DSP48E1 & 134 & 220 & 60.91\% \\
		\bottomrule
	\end{tabularx}
	\label{tab:util_final}
\end{table}

\noindent 注：上表为64 MHz、PAR\_OB=2配置经布局布线后的实现资源占用（Vivado 2024.2，xc7z020clg400-1）；PAR\_OB=3配置DSP占用198块（90.00\%），其余资源与PAR\_OB=2接近。在乘法器时分复用下，单Tile的MAC阵列约占64块DSP48，PAR\_OB=2的MAC部分约$2\times64=128$块，叠加重量化乘法等逻辑后实测共占用134块（60.91\%）；PAR\_OB=3的MAC部分约192块、连同其余逻辑占用198块（90.00\%）。无论何种配置，DSP占用均显著低于全实例化方案。

时序方面，本设计在PAR\_OB=2配置下于64 MHz（15.625 ns周期）完成时序收敛（WNS +0.013 ns，0个failing endpoints），PAR\_OB=3配置亦在64 MHz收敛（WNS +0.158 ns）；在75 MHz（13.333 ns周期）下出现时序违例（PAR\_OB=2时WNS -2.290 ns、72个failing endpoints），在80 MHz（12.5 ns周期）下违例更严重（WNS -3.324 ns、2212个failing endpoints）。关键路径位于权重地址生成的乘法运算（\texttt{ob\_group}→DSP48→\texttt{w\_rd\_tile\_idx}），主要受控制路径组合逻辑延迟影响。64 MHz为满足时序约束的签核频率（WNS为正、完全收敛），75/80 MHz为功能性超频频率（WNS为负、存在时序违例），但二者在常温下经板级实测功能均完全正确、逐元素结果与golden model bit-exact一致——超频工作点并未覆盖工艺—电压—温度（PVT）裕量。本文统一以64 MHz签核频率作为性能数据的标称频率：计算核延迟由实测周期数除以64 MHz折算（周期数本身与频率无关）；端到端延迟因受DMA带宽主导、与PL时钟频率基本无关（已由75/80 MHz对照实测验证），故以板级实测值为准。

Vivado功耗分析（routed后vector-less估计，置信度Medium）表明，64 MHz配置下系统总片上功耗为1.941 W（动态1.784 W，静态0.157 W）。其中CIM IP（\texttt{cim\_0}）动态功耗为0.243 W，其内部主要贡献来自DSP48（约0.071 W）、互连信号（约0.054 W）与Block RAM（约0.073 W）；而PS7（ARM Cortex-A9双核 + DDR控制器，约1.532 W）才是系统功耗的绝对主导因素，约占动态功耗的八成以上。PicoRV32模式的Vivado功耗分析（同为routed后vector-less估计、置信度Medium、64 MHz）表明，系统总片上功耗为2.050 W（动态1.886 W、静态0.164 W），结温约48.6 °C。其中PS7仍为绝对主导（约1.526 W，约占动态功耗81\%）；PL侧整体（PicoRV32软核 + 总线桥 + CIM IP + 双端口FW/Result BRAM）动态功耗约0.358 W，主要来自Block RAM（约0.161 W）、DSP48（约0.073 W）与互连信号（约0.072 W）。与ARM模式（总功耗1.941 W、PL侧动态约0.25 W）相比，PicoRV32模式虽去除了AXI DMA及其流水寄存器（FF显著减少，见表\ref{tab:rv32_vs_arm}），但新增了RISC-V软核与32 KB双端口BRAM，故PL侧动态功耗反而略有上升（约+0.11 W）、系统总功耗略高于ARM模式。此为vector-less估计且PS7按工具默认活动度建模；而PicoRV32模式下ARM核仅在上电时加载固件、推理期间空闲，实际PS7功耗应低于该估计，故纯PL侧自主推理在系统功耗上的潜在优势并未被充分体现。与ARM模式同理，本数字仅为综合工具量级参考，不具备与ASIC横向比较的意义。若仅考察CIM计算核自身，以全网MLP实测有效算力约1.536 GMACs/s（见§\ref{sec:hw_throughput}的吞吐分析，64 MHz下）与CIM IP动态功耗0.243 W估算，能效约为6.3 GMACs/s/W。此值仅为架构功能验证下的量级参考，不具备与ASIC宏单元横向比较的意义：其一，分母为综合工具估算功耗而非硅后实测；其二，本设计运行于FPGA可重构逻辑而非定制电路，二者能效本就相差数个数量级，与文献中7nm工艺下351 TOPS/W的SRAM-CIM宏（§1.2）完全不可比；其三，系统级能效因PS7占据较大比例动态功耗而显著低于此值。本文给出该数字仅为说明计算核的算力—功耗量级——FPGA平台的能效本非本设计的优化目标（参见§\ref{sec:two_extremes}的设计定位），严格的能效评估需在ASIC流程下进行。图\ref{fig:util_bar}以条形图形式直观对比了两种控制模式下的资源占用。

\begin{figure}[H]
	\centering
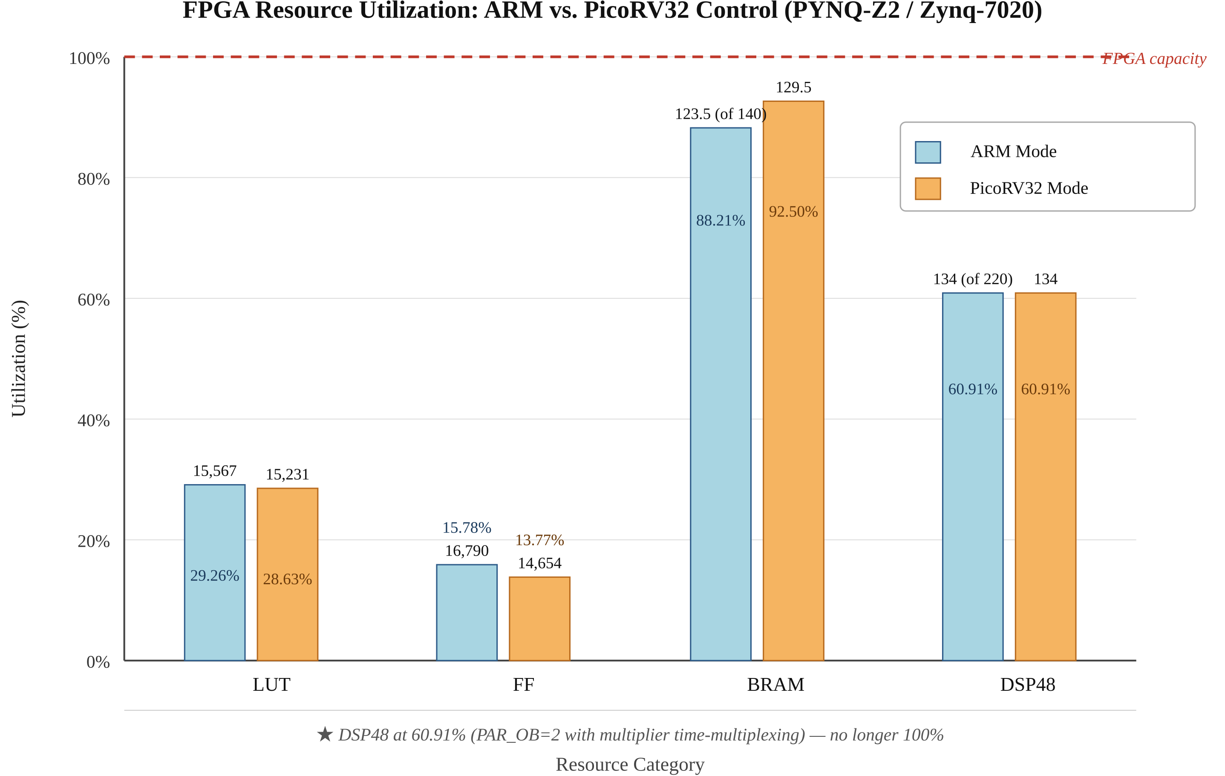
[picture p21: Thesis/paper/pics/4-3.png]
	
	\caption{两种控制模式下的FPGA资源占用对比（PYNQ-Z2/Zynq-7020）}
	\label{fig:util_bar}
\end{figure}

在乘法器时分复用下，DSP占用不再为100\%（PAR\_OB=2实测60.91\%、PAR\_OB=3实测90.00\%）；进一步提升输出并行度\texttt{PAR\_OB}主要受DSP总量与输出/重量化串行段的共同约束（详见后文PAR\_OB扫描分析）。

\section{MLP网络推理验证}

在ARM控制模式下，使用784→128→10两层MLP网络（INT8量化，200张MNIST测试图片板级分类准确率99.5\%）进行上板验证。表\ref{tab:mlp_perf}给出了各层的推理周期数与MAC操作数。

\begin{table}[H]
	\centering
	\caption{MLP推理性能（最终配置，ARM模式，PAR\_OB=2，64 MHz）}
	\begin{tabularx}{\textwidth}{l>{\centering\arraybackslash}X>{\centering\arraybackslash}X>{\centering\arraybackslash}X}
		\toprule
		层 & 维度 & 周期数 & MAC操作数 \\
		\midrule
		FC1 & 784→128 & 3737 & 100,352 \\
		FC2 & 128→10 & 529 & 2,048 \\
		\midrule
		总计 & & 4,266 & 102,400 \\
		\bottomrule
	\end{tabularx}
	\label{tab:mlp_perf}
\end{table}

\noindent 注：总周期数4,266为性能计数器实测值（与频率无关），计算核延迟按64 MHz折算得66.66 µs。该周期数包含了乘法器时分复用与乘积寄存器流水带来的MAC段扩展。

单幅推理的硬件计算延迟为：
\begin{equation}
	T_{\text{MLP, compute}} = \frac{4266}{64 \times 10^6} \approx 66.66\,\mu\mathrm{s}
\end{equation}

端到端延迟则包含Python驱动开销与DMA传输。表\ref{tab:mlp_arm_configs}给出了ARM控制模式下MLP网络在三种数据通路配置下的200张实测端到端性能。

\begin{table}[H]
	\centering
	\caption{ARM模式下MLP（784→128→10）200张端到端性能对比（PAR\_OB=2，64 MHz，两测试集均值）}
	\label{tab:mlp_arm_configs}
	\begin{tabularx}{\textwidth}{l>{\centering\arraybackslash}X>{\centering\arraybackslash}X>{\centering\arraybackslash}X>{\centering\arraybackslash}X}
		\toprule
		配置 & 总时间（s） & ms/img & fps & 准确率 \\
		\midrule
		MMIO-only & 94.75 & 473.75 & 2.11 & 99.50\% \\
		DMA & 5.49 & 27.43 & 36.46 & 99.50\% \\
		DMA + batch & 0.39 & 1.94 & 513.5 & 99.50\% \\
		\bottomrule
	\end{tabularx}
\end{table}

\noindent 注：三行均为PAR\_OB=2配置下的200张实测均值；计算核延迟按64 MHz折算，端到端为板级实测值（DMA带宽受限，与PL频率基本无关）。MMIO-only配置受数据搬运而非硬件计算瓶颈主导，列出以量化数据通路工程优化的相对收益。

从MMIO-only到DMA+batch，端到端加速约244倍。在200张真实MNIST手写数字测试中，硬件输出与Python golden model逐元素完全一致（100\% bit-exact），分类准确率99.5\%（199/200）；1张错分与golden model预测一致，源于INT8量化精度损失。Layer Fusion启用后，FC1→FC2的层间延迟从DMA S2MM+MM2S往返的数十毫秒降至约1.5 $\mu$s。

\section{LeNet-5 CNN推理验证}

LeNet-5是一个包含2个卷积层、2个最大池化层和3个全连接层的经典CNN。由于CIM硬件本身只支持MVM运算，卷积层通过软件侧im2col变换转化为矩阵乘法后供给硬件引擎，在硬件上通过MVM完成计算。im2col将卷积的滑窗操作展开为一个大矩阵，使得$\text{col\_len} = C_{in} \times K \times K$作为MVM的输入维度。MaxPool层在Python侧以向量化方式实现，连续FC层通过OBUF$\to$IBUF层融合然后在硬件上执行。LeNet-5的网络结构及各层在CIM上的软硬件执行映射如图\ref{fig:lenet5}所示。上方为各层维度，下方标注执行方式。池化层在Python侧向量化执行，表\ref{tab:lenet5_perf}列出了各层的推理周期数。

\begin{figure}[H]
	\centering
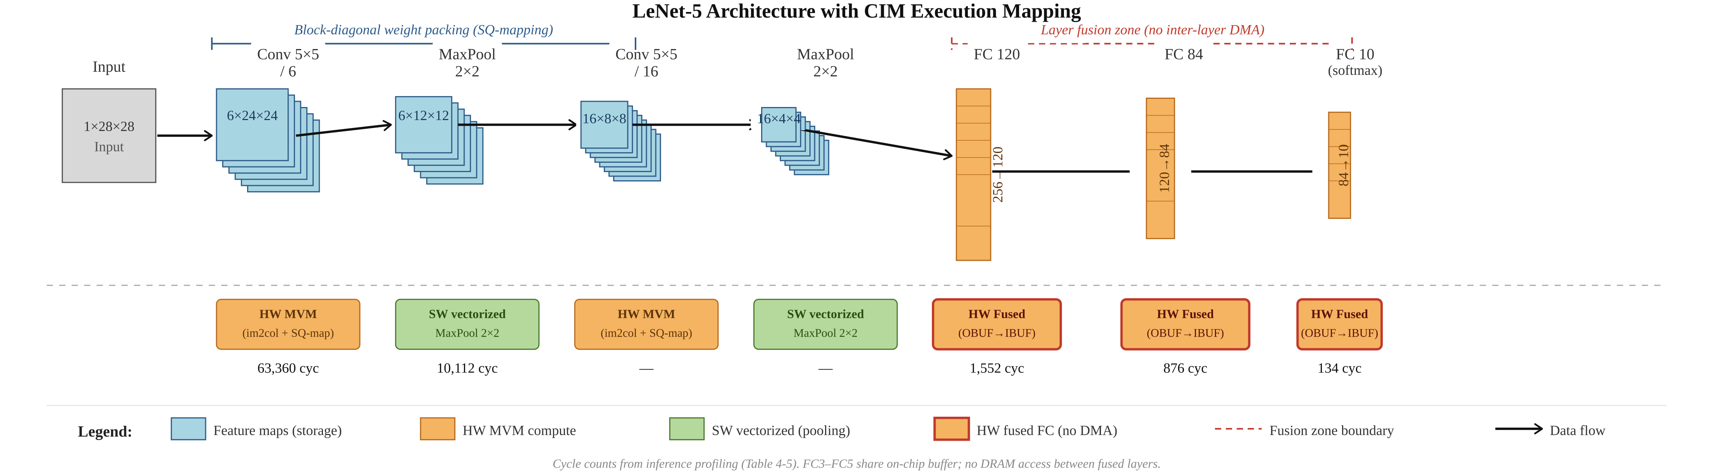
[picture p22: Thesis/paper/pics/4-4.png]
	
	\caption{LeNet-5网络结构与CIM执行映射}
	\label{fig:lenet5}
\end{figure}

\begin{table}[H]
	\centering
	\caption{LeNet-5各层推理周期数（最终配置，ARM模式，PAR\_OB=2，64 MHz）}
	\begin{tabularx}{\textwidth}{l>{\centering\arraybackslash}X>{\centering\arraybackslash}X>{\centering\arraybackslash}X}
		\toprule
		层 & 类型 & 维度 & 平均周期数 \\
		\midrule
		conv1 & Conv 5×5 & 1×28×28→6×24×24 & 63,601 \\
		conv2 & Conv 5×5 & 6×12×12→16×8×8 & 113,068 \\
		fc3 & FC & 256→120 & 22,613 \\
		fc4 & FC & 120→84 & 7,420 \\
		fc5 & FC & 84→10 & 620 \\
		\midrule
		总计 & & & 207,322 \\
		\bottomrule
	\end{tabularx}
	\label{tab:lenet5_perf}
\end{table}

\noindent 注：总周期数207,322为性能计数器实测值（与频率无关），计算核延迟按64 MHz折算得3239.4 µs。

在200张真实MNIST手写数字测试中（两个独立测试集）：
\begin{itemize}
	\item 硬件分类准确率（vs 标签）：99\%--100\%（测试集一200/200、测试集二198/200）
	\item 与Python golden model的bit-exact一致率：100.0\%（200/200）
	\item 计算错误数：0
\end{itemize}

两测试集中的错分（测试集一0张、测试集二2张）均与Python golden model的预测完全一致，说明这是INT8量化精度损失导致的，而非硬件计算错误。全部200张图片的全部层输出均与Python参考模型bit-exact一致，验证了硬件实现的正确性。

\section{SQ-mapping：块对角权重打包的卷积映射优化}
\label{sec:sqmapping}

在LeNet-5这类小卷积核网络中，直接把im2col得到的每个输出像素逐一送入MVM引擎会严重浪费CIM阵列的利用率。以Conv1层（$1\times5\times5\to6$）为例，单次MVM的有效输入维度仅为$\text{col\_len} = C_{in}\times K_h\times K_w = 25$，而硬件支持的最大输入维度为1536，利用率不足$25/1536\approx 1.6\%$；同时单次MVM产生$C_{out}=6$个输出神经元，输出侧利用率同样极低。这种"瘦长矩阵挤在大阵列里"的映射方式使得每次硬件调用的建立与DMA开销被完全暴露，无法被有效均摊。

针对这一问题，本文引入并应用了块对角权重打包（SQ-mapping）这一已有的软件映射优化方法：当$\text{col\_len}\times C_{out}$远小于硬件容量时，把$k_{\text{pack}}$个输出像素的im2col列与权重一起打包到同一次MVM调用中。

SQ-mapping的基本思想并非本文首创，本文的贡献在于将其与本设计的硬件维度上限（MAX\_IN\_DIM/MAX\_OUT\_DIM）、双缓冲乒乓批处理流程及Python驱动侧的权重预打包相结合，给出在本平台上的具体参数化实现与bit-exact验证。原始权重矩阵$W\in\mathbb{Z}^{C_{out}\times \text{col\_len}}$沿对角线复制$k_{\text{pack}}$份构造块对角矩阵：

\begin{equation}
	W_{\text{packed}} = \begin{bmatrix}
		W & & & \\
		& W & & \\
		& & \ddots & \\
		& & & W
	\end{bmatrix} \in \mathbb{Z}^{(k_{\text{pack}}\cdot C_{out})\times (k_{\text{pack}}\cdot \text{col\_len})}
\end{equation}

输入侧同时将$k_{\text{pack}}$个输出像素对应的im2col列串联成长向量。一次硬件调用即可同时得到$k_{\text{pack}}\cdot C_{out}$个输出神经元，再按$C_{out}$拆回$k_{\text{pack}}$组像素结果。打包因子由硬件维度上限决定：

\begin{equation}
	k_{\text{pack}} = \min\!\left(\left\lfloor\frac{\text{MAX\_IN\_DIM}}{\text{col\_len}}\right\rfloor,\ \left\lfloor\frac{\text{MAX\_OUT\_DIM}}{C_{out}}\right\rfloor\right)
\end{equation}

SQ-mapping的块对角打包思想如图\ref{fig:sqmapping}所示：左侧逐像素映射时瘦长权重矩阵仅占据阵列极小一角，利用率不足5\%且每次调用开销无法均摊；右侧将$k_{\text{pack}}$份权重沿对角线复制构成块对角矩阵，一次MVM调用即可并行处理$k_{\text{pack}}$个输出像素，从而显著削减MVM调用次数。表\ref{tab:sqmapping}给出了LeNet-5两个卷积层在MAX\_IN\_DIM=1536、MAX\_OUT\_DIM=256配置下的打包结果。

该优化不需要修改任何RTL，完全在Python驱动侧通过权重矩阵构造与输入向量拼接实现。启用SQ-mapping后，200张LeNet-5图片的逐层bit-exact验证全部通过，分类准确率仍为99.5\%（199/200），与逐像素调用模式完全一致。

\begin{table}[H]
	\centering
	\caption{LeNet-5卷积层SQ-mapping打包参数与效果}
	\label{tab:sqmapping}
	\small
	\begin{tabularx}{\textwidth}{l>{\centering\arraybackslash}X>{\centering\arraybackslash}X>{\centering\arraybackslash}X>{\centering\arraybackslash}X>{\centering\arraybackslash}X>{\centering\arraybackslash}X}
		\toprule
		层 & $\text{col\_len}$ & $C_{out}$ & $k_{\text{pack}}$ & 逐像素MVM次数 & 打包后MVM次数 & MVM削减比例 \\
		\midrule
		Conv1 & 25 & 6 & 42 & 576 & 14 & 97.6\% \\
		Conv2 & 150 & 16 & 10 & 64 & 7 & 89.1\% \\
		\bottomrule
	\end{tabularx}
\end{table}

\begin{figure}[H]
	\centering
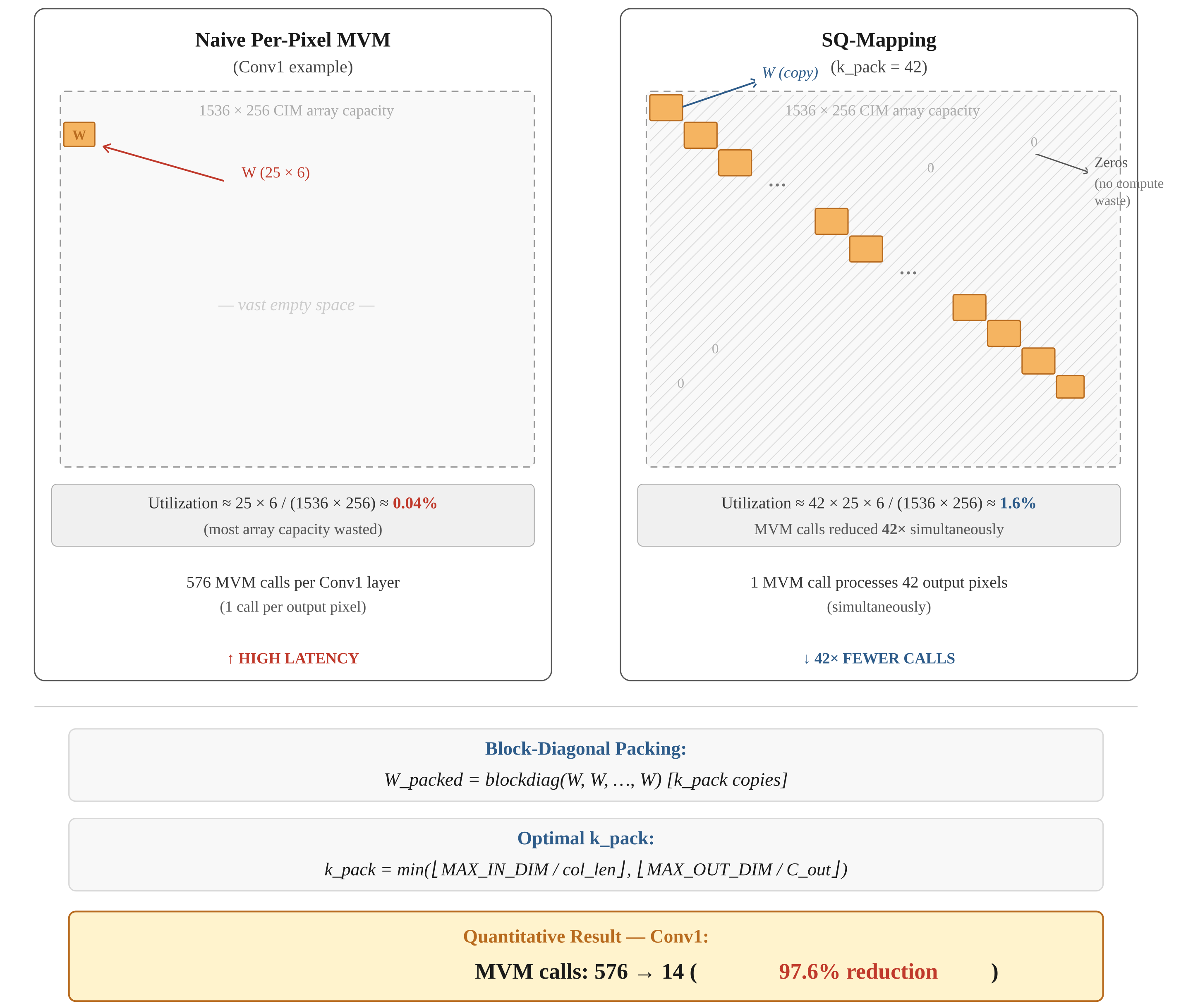
[picture p23: Thesis/paper/pics/4-5.png]
	
	\caption{SQ-mapping块对角权重打包示意图}
	\label{fig:sqmapping}
\end{figure}

\section{端到端性能分析}

\subsection{延迟分解}

表\ref{tab:latency_breakdown}给出了LeNet-5在最终配置（64 MHz签核频率、PAR\_OB=2，双缓冲乒乓，Layer Fusion，SQ-mapping，MAX\_IN\_DIM=1536）下200张图片的逐项延迟分解分析。端到端延迟由DMA乒乓wall time（受DMA带宽约束）与Python侧的im2col/pool/pack等CPU开销共同构成，二者均与PL时钟频率基本无关，总延迟实测约29.88 ms/幅。

\begin{table}[H]
	\centering
	\caption{LeNet-5端到端延迟分解（200张MNIST，64 MHz签核频率、PAR\_OB=2，最终配置）}
	\label{tab:latency_breakdown}
	\small
	\begin{tabularx}{\textwidth}{l>{\raggedleft\arraybackslash}X>{\raggedleft\arraybackslash}X}
		\toprule
		阶段 & 延迟（ms/img） & 占比 \\
		\midrule
		MVM乒乓wall time（max(DMA, compute)） & 26.0 & 87.0\% \\
		im2col（向量化） & 2.1 & 7.0\% \\
		pool（向量化） & 0.9 & 3.0\% \\
		pack（预打包） & 0.4 & 1.3\% \\
		setup（摊薄） & 0.3 & 1.0\% \\
		final（argmax） & 0.2 & 0.7\% \\
		\midrule
		合计 & 29.88 & 100\% \\
		\bottomrule
	\end{tabularx}
\end{table}

\noindent 注：上表合计延迟29.88 ms/幅为200张MNIST的实测端到端均值。由于MVM乒乓wall time受DMA带宽约束、Python侧开销为纯CPU耗时，二者均与PL时钟频率无关，故各阶段绝对延迟相对早期测量预期基本不变，MVM乒乓wall time仍为绝对主导项（约占87\%）。

双缓冲乒乓机制已成功将DMA load\_x和read\_out隐藏在compute之后，约29.9 ms的端到端延迟主要由MVM调用的乒乓wall time即max(DMA传输时间, 硬件计算时间)的逐次累加构成（约占87\%）。由于LeNet-5各MVM调用的compute耗时（单张约3.24 ms，即表\ref{tab:lenet5_perf}的207,322 cycle）远小于其DMA传输时间（单张DMA约26 ms），该wall time实质上由DMA带宽决定，与PL时钟频率无关。在此之后，不可重叠的Python侧开销（im2col + pool + pack + setup）为纯CPU耗时，合计约占总延迟的13\%，同样不随PL频率变化。图\ref{fig:latency_pie}以饼图形式直观呈现了该延迟分解的量级关系。各项合计约29.9 ms/幅，与表\ref{tab:arm_multi_model}中200张批量基准给出的29.88 ms/幅（约33.5 fps）一致。

\begin{figure}[H]
	\centering
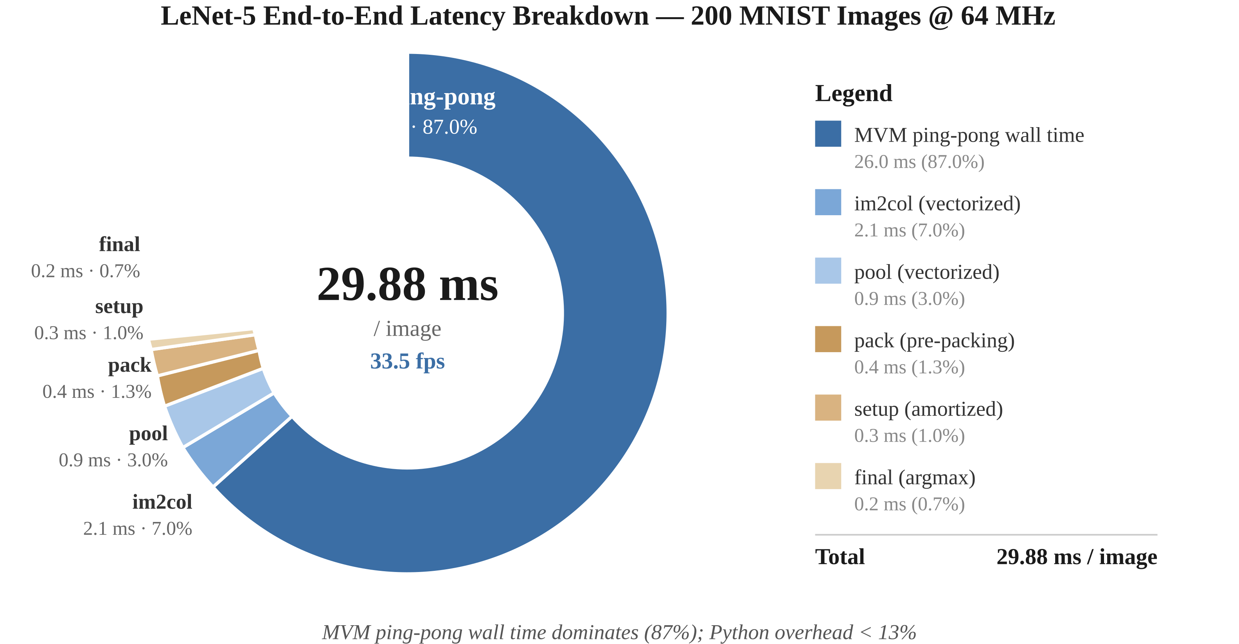
[picture p24: Thesis/paper/pics/4-6.png]
	
	\caption{LeNet-5端到端延迟分解}
	\label{fig:latency_pie}
\end{figure}

上述延迟分解已表明本系统在端到端层面属于典型的内存带宽受限（memory-bound）场景。以ARM模式64 MHz配置为例：DMA经由64位AXI HP端口（理论带宽约488 MB/s）搬运数据；而CIM计算核的有效吞吐为1.536 GMACs/s，按每MAC约需6字节（1 B权重 + 1 B输入 + 4 B输出）折算，若计算核满负荷运行需约9.2 GB/s的存储带宽，约为实际DMA带宽的19倍。这正是计算核延迟仅占总延迟约13\%、而DMA乒乓wall time占87\%的根源：数据搬运速度远跟不上计算速度，系统瓶颈在带宽而非算力。双缓冲乒乓通过将DMA传输与计算重叠，隐藏了部分搬运延迟，但并未改变带宽受限的本质——MVM调用的wall time仍由DMA传输时间决定。这一分析也解释了为何端到端延迟对PL时钟频率不敏感：提升的是算力，而瓶颈在带宽。

\subsection{优化历程}

本设计的端到端性能经历了系统的优化过程，表\ref{tab:optimization_journey}以LeNet-5为例汇总了三种数据通路配置下的端到端延迟演进。三种配置均在统一的PAR\_OB=2工作点与同一份CIM IP RTL下实测，阶段之间仅改变数据通路与批处理方式，因此累计加速比反映的是数据通路重构所带来的纯粹收益。优化路线遵循"先消除数据通路瓶颈，再隐藏剩余延迟"的策略：首先以AXI4-Stream + DMA双向数据通路替代逐字AXI4-Lite MMIO，从根本上消除数据搬运瓶颈；在此基础上，软件侧的SQ-mapping块对角权重打包（详见§\ref{sec:sqmapping}）提升了小卷积核场景下的CIM阵列利用率、削减了MVM调用次数；最后通过输入/输出双缓冲乒乓将DMA传输与硬件计算重叠，并利用Layer Fusion消除连续FC层间的S2MM+MM2S往返，结合批量推理摊薄逐图固定开销。

从逐字MMIO基线到最终的DMA+批量配置，累计端到端加速比达到约107倍，吞吐率从0.31 fps提升至33.5 fps，越过了~30fps的实时阈值。最终配置分类准确率为99\%--100\%，各配置输出均与Python golden model逐元素bit-exact一致。该优化历程的延迟递减与累计加速比演进如图\ref{fig:opt_waterfall}所示，图中柱状（左轴）为三种数据通路配置下延迟逐步下降，折线（右轴）为相对AXI4-Lite逐字MMIO基线的累计加速比。

\begin{figure}[H]
	\centering
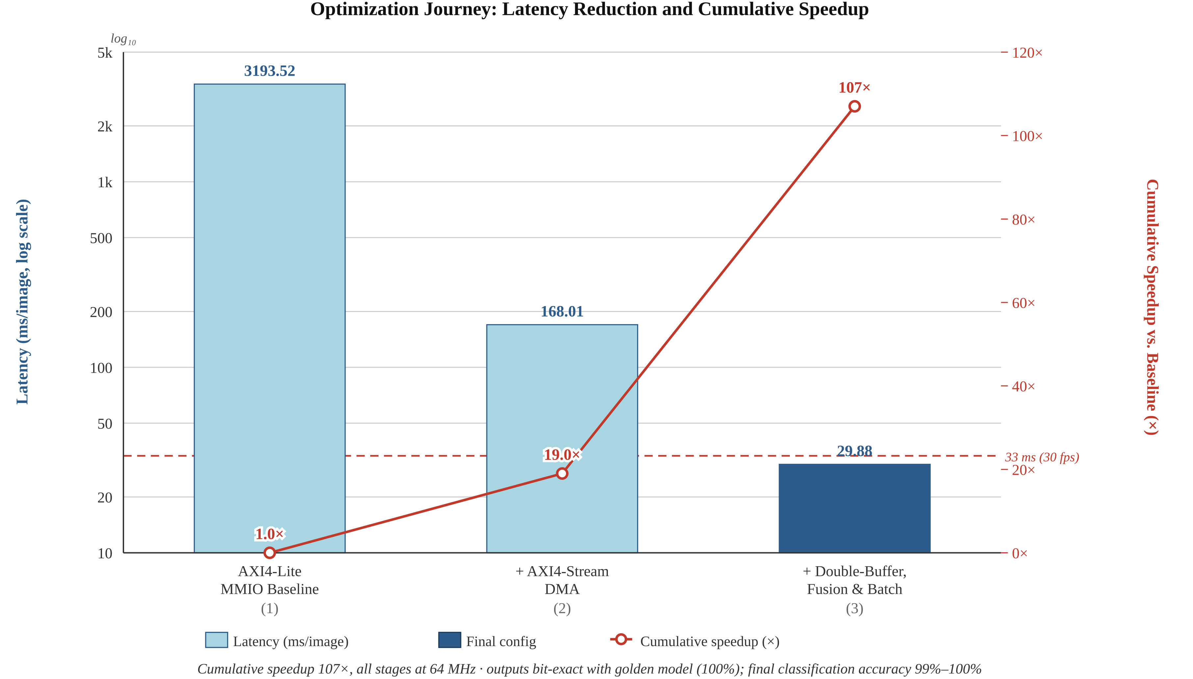
[picture p25: Thesis/paper/pics/4-7.png]
	
	\caption{LeNet-5端到端优化历程瀑布图}
	\label{fig:opt_waterfall}
\end{figure}

\begin{table}[H]
	\centering
	\caption{LeNet-5端到端优化历程（200张MNIST，PYNQ-Z2，两测试集均值）}
	\label{tab:optimization_journey}
	\small
	\begin{tabularx}{\textwidth}{l>{\centering\arraybackslash}X>{\centering\arraybackslash}X>{\centering\arraybackslash}X}
		\toprule
		阶段 & 延迟（ms/img） & fps & 累计加速比 \\
		\midrule
		AXI4-Lite逐字MMIO基线 & 3193.52 & 0.31 & 1.0× \\
		\quad + AXI4-Stream/DMA双向数据通路 & 168.01 & 5.95 & 19.0× \\
		\quad + 双缓冲乒乓 + Layer Fusion + 批量推理 & 29.88 & 33.5 & 107× \\
		\bottomrule
	\end{tabularx}
\end{table}

\subsection{层融合消融实验}

为单独量化层融合机制（连续FC层间OBUF$\to$IBUF硬件直拷）对端到端性能的贡献，在保持双缓冲乒乓与批量推理不变的前提下，对比关闭/启用层融合两种情形下DMA+batch配置的200张实测延迟，结果如表\ref{tab:fusion_ablation}所示。

\begin{table}[H]
	\centering
	\caption{层融合消融对比（DMA+batch配置，64 MHz签核频率、PAR\_OB=2，200张MNIST，两测试集均值）}
	\label{tab:fusion_ablation}
	\small
	\begin{tabularx}{\textwidth}{l>{\centering\arraybackslash}X>{\centering\arraybackslash}X>{\centering\arraybackslash}X}
		\toprule
		模型 & 关闭层融合 ms/img（fps） & 启用层融合 ms/img（fps） & 层融合加速 \\
		\midrule
		MLP（784→128→10） & 2.19（455.8） & 1.94（513.5） & 1.13× \\
		LeNet-5（7层） & 30.49（32.8） & 29.88（33.5） & 1.02× \\
		\bottomrule
	\end{tabularx}
\end{table}

层融合在两种模型上分别带来1.02×$\sim$1.13×的端到端加速，对应每幅约0.25$\sim$0.61 ms的延迟下降。以全连接层为主的MLP相对收益最大（1.13×，每幅省约0.25 ms），因其唯一的FC1→FC2层间边界在其较短的推理流水线中占比较高；LeNet-5的相对收益最小（1.02×，每幅省约0.61 ms），因其延迟由卷积与池化阶段主导，仅末端的FC层边界受益于融合。此处测得的增量（毫秒量级）小于§2.8中单边界"数十毫秒$\to$约1.5\,$\mu$s"的对比：在已启用双缓冲乒乓的最终配置中，FC层间的DMA往返已被乒乓机制与计算重叠所隐藏，层融合在此之上进一步省去重叠后仍残留的往返开销与软件介入，因此其边际收益相对较小。两种模型在开/关层融合下分类准确率均保持不变（MLP 99.5\%、LeNet-5 99\%--100\%），印证层融合为无损的纯性能优化。
\section{加速比分析}

\subsection{硬件理论吞吐率}
\label{sec:hw_throughput}

CIM硬件的核心优势在于利用存储阵列的并行性实现高通量MAC运算。需要区分\emph{标称峰值}与\emph{有效吞吐}：在乘法器时分复用下，单个$16\times16$ Tile每4拍完成一次256-MAC，叠加逐输出神经元的串行偏置/激活/重量化后处理，单层的有效MAC吞吐显著低于阵列的瞬时峰值。以全连接网络MLP（784→128→10）为整体实测（其硬件实际执行约102,400次MAC，含将输出维度对齐至16倍数的padding，分层明细见表\ref{tab:mlp_perf}）：

\begin{itemize}
	\item FC1层（784→128）总MAC操作数：$784 \times 128 = 100{,}352$
	\item FC1层硬件周期数：3,737
	\item 全网MLP实测周期数（PAR\_OB=2）：4,266
	\item 全网有效MAC吞吐：$102{,}400 / 4{,}266 \approx 24.0$ MACs/cycle（含层间切换与后处理串行开销）
	\item 有效吞吐率（64 MHz）：$24.0 \times 64 \times 10^6 \approx 1.536 \text{ GMACs/s}$
\end{itemize}

\noindent 该有效吞吐率远低于$16\times16$阵列的标称峰值，主要瓶颈在于MAC段的时分复用（完整覆盖16列需多拍）与逐神经元串行重量化；提升途径为增大输出并行度\texttt{PAR\_OB}并对输出/重量化段做流水化（详见§\ref{sec:par_ob_sweep}）。

\subsection{软件基线对比}
\label{sec:sw_baseline}

为定量评估CIM硬件相对纯软件实现的性能优势，本文在同一块PYNQ-Z2的ARM Cortex-A9处理器上，用NumPy/BLAS实现了与硬件\emph{逐元素bit-exact一致}的INT8整数推理，并对同一批200张MNIST测试图片逐图计时（每图预热后多次重复取均值）。软件基线脚本（\texttt{benchmark\_sw\_baseline.py}）直接读取硬件端到端实测CSV作为对照，并在两个独立测试集上各运行一次。本节给出\emph{两种口径}的对比，二者结论一致——CIM硬件在两种口径下均显著快于ARM软件。

口径一：纯计算对比（compute-only，对称口径）。 硬件侧取性能计数器实测的纯MAC周期数除以64 MHz，软件侧取NumPy矩阵运算内核时间，两侧均不含数据搬运，是对等的"计算核"比较。结果如表\ref{tab:speedup_compute}所示。LeNet-5的卷积层比较分两种软件实现：sequential模式与硬件相同地按输出像素逐一调用矩阵乘法（与硬件执行模型等价，是更直接的对比），SW延迟约619.1 ms，计算核加速比约191.1倍；batched模式将所有像素合并为单次大矩阵乘法（充分利用ARM BLAS的最优软件实现上界），SW延迟约40.1 ms，计算核加速比约12.4倍。即便对比ARM上最优的batched-BLAS实现，CIM计算核仍快约12.4倍；对FC类网络（MLP/small\_mlp）则快约65$\sim$150倍（约一到两个数量级）。

\begin{table}[H]
	\centering
	\caption{纯计算口径：CIM计算核 vs ARM NumPy矩阵运算（两侧均为compute-only，200张均值）}
	\begin{tabularx}{\textwidth}{l>{\centering\arraybackslash}X>{\centering\arraybackslash}X>{\centering\arraybackslash}X}
		\toprule
		网络 & SW计算延迟（$\mu$s） & HW计算核延迟（$\mu$s） & 计算核加速比 \\
		\midrule
		MLP（784→128→10） & 4,357.2 & 66.66 & 65.4× \\
		small\_mlp（784→16→10） & 2,175.2 & 14.53 & 149.7× \\
		LeNet-5（7层，sequential） & 619{,}070.8 & 3{,}239.4 & 191.1× \\
		LeNet-5（7层，batched BLAS） & 40{,}078.7 & 3{,}239.4 & 12.4× \\
		\bottomrule
	\end{tabularx}
	\label{tab:speedup_compute}
\end{table}

口径二：系统级端到端对比（end-to-end，公平口径）。硬件侧采用与软件\emph{完全同口径}的端到端逐图实测墙钟时间（表\ref{tab:arm_multi_model}中DMA+batch配置），软件侧为ARM上完整逐图推理时间，二者均为"从输入到输出"的系统级延迟。结果如表\ref{tab:speedup_e2e}所示。

\begin{table}[H]
	\centering
	\caption{系统级端到端口径：CIM硬件（DMA+batch）vs ARM NumPy（两侧均为完整逐图墙钟时间，200张均值）}
	\begin{tabularx}{\textwidth}{l>{\centering\arraybackslash}X>{\centering\arraybackslash}X>{\centering\arraybackslash}X}
		\toprule
		网络 & SW端到端（ms/img） & HW端到端（ms/img） & 端到端加速比 \\
		\midrule
		MLP（784→128→10） & 4.36 & 1.94 & 2.24× \\
		small\_mlp（784→16→10） & 2.18 & 1.77 & 1.23× \\
		LeNet-5（vs batched-BLAS） & 40.08 & 29.88 & 1.34× \\
		LeNet-5（vs sequential） & 619.07 & 29.88 & 20.7× \\
		\bottomrule
	\end{tabularx}
	\label{tab:speedup_e2e}
\end{table}

由表\ref{tab:speedup_e2e}可见，在与软件完全同口径的系统级端到端对比下，CIM硬件在三种网络上均快于ARM Cortex-A9软件：MLP约2.24倍、small\_mlp约1.23倍、LeNet-5相对ARM最优的batched-BLAS实现约1.34倍（相对与硬件同执行模型的sequential实现则达约20.7倍）。即便计入DMA搬运与Python侧的im2col/打包/调度等全部系统开销，CIM硬件的端到端延迟仍低于ARM软件，且在计算核纯算力口径下领先约一到两个数量级（约65$\sim$191倍，表\ref{tab:speedup_compute}）。两种口径的对比如图\ref{fig:sw_vs_hw}所示。

软件基线与硬件运行的是\emph{完全相同的INT8整数算法}，二者逐图分类结果与全部中间张量bit-exact一致（脚本中已交叉校验准确率，两侧完全吻合），因此上述加速比是在数值结果完全等价前提下的纯性能对比。本设计的价值在于：在资源受限的PYNQ-Z2小型SoC上，CIM硬件不仅在计算核层面相对CPU快约一到两个数量级（约65$\sim$191倍），在计入全部数据搬运开销的系统级端到端口径下仍保持对ARM软件的速度优势。进一步的性能提升空间（如§\ref{sec:future_work}所述DSP48 INT8 SIMD打包带来的compute吞吐翻倍、提升输出并行度PAR\_OB、更大批量与片上权重驻留以进一步摊薄DMA）将使这一优势继续扩大。

\begin{figure}[H]
	\centering
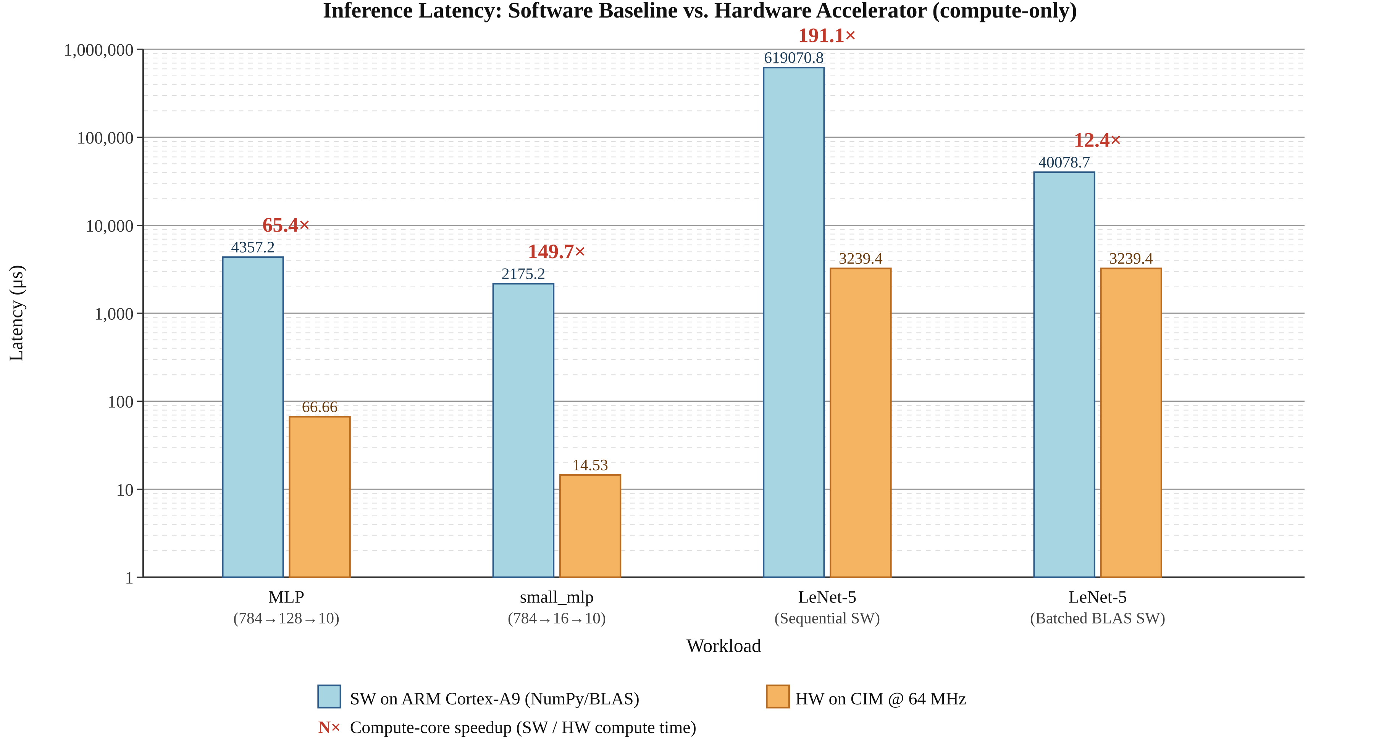
[picture p26: Thesis/paper/pics/4-8.png]
	
	\caption{软件基线与硬件推理延迟对比（对数坐标，ARM Cortex-A9 vs CIM @ 64 MHz、PAR\_OB=2）}
	\label{fig:sw_vs_hw}
\end{figure}

\subsection{多模型多配置ARM端到端性能汇总}

表\ref{tab:arm_multi_model}汇总了ARM控制模式下三种网络（small\_mlp 784→16→10、MLP 784→128→10、LeNet-5）在三种数据通路配置（MMIO-only、DMA、DMA+batch）下的200张端到端实测性能（在两个独立测试集上各测一次后取均值）。

\begin{table}[H]
	\centering
	\caption{ARM模式多模型多配置端到端性能汇总（64 MHz签核频率、PAR\_OB=2，200张MNIST，两测试集均值）}
	\label{tab:arm_multi_model}
	\small
	\begin{tabularx}{\textwidth}{l>{\raggedright\arraybackslash}X>{\centering\arraybackslash}X>{\centering\arraybackslash}X>{\centering\arraybackslash}X>{\centering\arraybackslash}X}
		\toprule
		模型 & 配置 & 总时间（s） & ms/img & fps & 准确率 \\
		\midrule
		\multirow{3}{*}{small\_mlp（784→16→10）} & MMIO & 15.96 & 79.82 & 12.5 & 95.5--96.5\% \\
		& DMA & 1.38 & 6.92 & 144.6 & 95.5--96.5\% \\
		& DMA+batch & 0.35 & 1.77 & 565.3 & 95.5--96.5\% \\
		\midrule
		\multirow{3}{*}{MLP（784→128→10）} & MMIO & 94.75 & 473.75 & 2.1 & 99.50\% \\
		& DMA & 5.49 & 27.43 & 36.5 & 99.50\% \\
		& DMA+batch & 0.39 & 1.94 & 513.5 & 99.50\% \\
		\midrule
		\multirow{3}{*}{LeNet-5（7层）} & MMIO & 638.70 & 3,193.52 & 0.31 & 99--100\% \\
		& DMA & 33.60 & 168.01 & 5.95 & 99--100\% \\
		& DMA+batch & 5.98 & 29.88 & 33.5 & 99--100\% \\
		\bottomrule
	\end{tabularx}
\end{table}

从表可见：（1）DMA相比MMIO的加速比随模型规模增大而增大——MLP约17.3倍、LeNet-5约19.0倍，因数据搬运量越大DMA的批量优势越明显；（2）DMA+batch（双缓冲乒乓+层融合）在DMA基础上进一步加速——MLP约14.1倍、LeNet-5约5.6倍，将数据搬运延迟隐藏在计算之后，small\_mlp由MMIO到DMA+batch的累计加速约45.1倍；（3）各配置的硬件输出与Python golden model始终保持逐元素bit-exact一致（一致率100\%），即数据通路重构不引入任何计算误差；表中分类准确率为INT8量化模型相对标签的分类精度，由模型量化本身决定，与硬件数据通路无关（两测试集上MLP均为99.5\%，LeNet-5为99\%--100\%，small\_mlp约96\%）。

\section{PicoRV32验证结果}

PicoRV32模式在PYNQ-Z2上基于64 MHz签核频率（PAR\_OB=2，15.625 ns约束）存在轻微时序违例（WNS -0.160 ns，11个failing endpoints），但在常温上板功能正常。表\ref{tab:util_rv32}列出了该模式下的资源占用情况。

\begin{table}[H]
	\centering
	\caption{PicoRV32模式资源占用（PYNQ-Z2）}
	\begin{tabularx}{\textwidth}{l>{\centering\arraybackslash}X>{\centering\arraybackslash}X>{\centering\arraybackslash}X>{\centering\arraybackslash}X}
		\toprule
		资源类型 & 使用量 & 可用量 & 占用率 & 相对ARM模式增量 \\
		\midrule
		Slice LUT & 15231 & 53,200 & 28.63\% & -336 \\
		Slice Register & 14654 & 106,400 & 13.77\% & -2136 \\
		Block RAM & 129.5 & 140 & 92.50\% & +6.0 \\
		DSP48E1 & 134 & 220 & 60.91\% & +0 \\
		\bottomrule
	\end{tabularx}
	\label{tab:util_rv32}
\end{table}

PicoRV32模式相比ARM模式的逻辑资源变化为：FF显著减少（因去除了axi\_dma及关联AXI Stream/Interconnect IP中的大量流水寄存器），LUT略有增加（来自PicoRV32核心约1,500 LUT + bridge + UART TX），BRAM略有增加（FW BRAM 32KB + Result BRAM 256B）。总体而言，PicoRV32模式以更少的FF资源实现了纯PL侧自主推理，代价是额外BRAM存储与模型规模受限。DSP使用量与ARM模式相同（在乘法器时分复用、PAR\_OB=2下约占134块、约60.91\%），因为两种模式共享完全相同、未经修改的CIM IP。

\subsection{PicoRV32功能验证}

在PYNQ-Z2上针对784→16→10小型MLP模型（INT8量化，模型数据约13.3KB）进行了200张MNIST手写数字图片的端到端推理验证（两个独立测试集），结果如表\ref{tab:rv32_verify}所示。

\begin{table}[H]
	\centering
	\caption{PicoRV32推理验证结果（784→16→10 MLP，200张MNIST图片，两测试集）}
	\begin{tabularx}{\textwidth}{l>{\centering\arraybackslash}X}
		\toprule
		指标 & 值 \\
		\midrule
		测试图片数 & 200（×2测试集） \\
		分类准确率（vs 标签） & 95.50\%（191/200，两测试集一致） \\
		Bit-exact一致率（vs Python golden） & 100.0\%（200/200） \\
		计算错误数 & 0 \\
		\bottomrule
	\end{tabularx}
	\label{tab:rv32_verify}
\end{table}

200张图片的全部10维logits输出均与ARM控制模式下相同模型的预测结果完全一致（bit-exact），计算错误为零。分类错误均源于784→16→10模型自身的INT8量化精度损失（两测试集均为191/200，约95.5\%），验证了RISC-V固件控制逻辑的正确性。

PicoRV32模式在small\_mlp（784→16→10）上的端到端实测性能为：逐图推理延迟（不含Python侧SD卡文件读取）的均值约6.3--6.4 ms（约157 fps）、p50约6.2--6.3 ms、最小约6.0--6.1 ms、最大约18.3--18.4 ms（首图含权重加载开销）；200张总墙钟时间约2.40 s，折合约12.0 ms/img，其中约5.7 ms/张为测试脚本读取hex测试文件的纯软件开销，非推理数据通路延迟。全部logits与ARM路径bit-exact一致，准确率约95.5\%（两测试集均为191/200）。相比ARM模式下相同模型的DMA+batch配置（1.77 ms/img，ARM侧已预加载全部图片故不含文件读取开销），PicoRV32的逐图推理延迟约为3.6倍，主要差距来自PicoRV32缺少DMA批量传输能力——权重与输入数据需由CPU逐字写入CIM CSR（等效于ARM MMIO路径），而非通过AXI-Stream DMA批量搬运。该差距是控制路径（轻量RISC-V软核 vs ARM Cortex-A9 + DMA引擎）的固有差异，而非CIM计算核心的性能差异。事实上，两种模式运行的是同一份CIM IP RTL，对同一small\_mlp模型的硬件MVM计算周期数完全相同，端到端差异完全来自数据搬运方式。

\section{两种控制模式对比}

\begin{table}[H]
	\centering
	\caption{ARM控制 vs PicoRV32控制模式对比}
	\label{tab:rv32_vs_arm}
	\begin{tabularx}{\textwidth}{l>{\centering\arraybackslash}X>{\centering\arraybackslash}X}
		\toprule
		指标 & ARM控制 & PicoRV32控制 \\
		\midrule
		时钟频率 & 64 MHz & 64 MHz \\
		时序收敛 & 收敛（WNS +0.013 ns） & 轻微违例（WNS -0.160 ns） \\
		LUT占用 & 15567 & 15231 \\
		BRAM占用 & 123.5 & 129.5 \\
		small\_mlp延迟 & 1.77 ms/img（DMA+batch） & 6.4 ms/img \\
		small\_mlp吞吐 & 565.3 fps & 157 fps \\
		PS依赖 & 需要ARM PS运行Python & PS仅用于固件加载 \\
		支持网络 & 任意（受MAX\_DIM限制） & 受FW BRAM 32KB限制 \\
		CIM IP修改 & -- & 无修改 \\
		\bottomrule
	\end{tabularx}
\end{table}

两种模式均基于64 MHz签核频率且共享相同的CIM IP RTL。ARM模式在绝对性能上领先（受益于DMA批量数据传输），但PicoRV32模式展现出显著的轻量化优势——尽管集成了完整的32位RISC-V处理器、总线桥接与双端口BRAM，其LUT和FF占用均显著低于ARM模式（LUT: 15231 vs 15567，减少336个；FF: 14654 vs 16790，减少2136个），BRAM占用增加6块（129.5 vs 123.5）。资源减少的主要原因是PicoRV32模式不需要AXI DMA IP及其关联的AXI4-Stream FIFO与状态机，这些IP包含大量逻辑资源和流水寄存器；BRAM增加来自双端口指令/数据RAM（32KB FW BRAM）。PicoRV32以更少的逻辑资源实现了纯PL侧自主推理，对小模型的推理延迟已处于实用范围（small\_mlp 6.4 ms/img，约157 fps）。无论控制源为何，CIM IP在两种模式下完全相同，且计算结果bit-exact一致。

\section{并行度可扩展性的仿真验证}
\label{sec:par_ob_sweep}

\subsection{动机与方法}

如§\ref{sec:two_extremes}所述，本设计的输出并行度由编译期参数PAR\_OB控制：核心通过\texttt{generate}对PAR\_OB份16$\times$16 Tile完全参数化例化。得益于乘法器时分复用（单Tile的DSP48占用由256降至约64），板级实现已可在PYNQ-Z2的220块DSP预算内部署PAR\_OB=2（MAC约128块、实测共134块/61\%）乃至PAR\_OB=3（MAC约192块、实测共198块/90\%）；而PAR\_OB$\geq$4所需的DSP（$\geq$256块）已超出该器件预算，物理上无法在板上例化。这是PYNQ-Z2的器件资源天花板而非架构能力上限——为验证更高并行度下架构的\emph{可综合性}与\emph{功能正确性}，下文通过周期级仿真将PAR\_OB扫描至16。

为验证更高并行度下架构的\emph{可综合性}与\emph{功能正确性}，本文在Synopsys VCS中对一个256$\times$256全连接层（N\_IB=16、N\_OB=16）进行了PAR\_OB $\in \{1,2,4,8,16\}$的周期级仿真扫描。该层规模的选取使N\_OB能被所有扫描点整除。每个PAR\_OB配置均重新综合（elaborate）并运行，由测试平台读取硬件性能计数器\texttt{perf\_cycles}，并将输出与整数golden model逐元素比对。结果如表\ref{tab:par_ob_sweep}所示。

\begin{table}[H]
	\centering
	\caption{PAR\_OB并行度扫描（256$\times$256层，N\_OB=16，VCS周期级仿真）}
	\label{tab:par_ob_sweep}
	\small
	\begin{tabularx}{\textwidth}{>{\centering\arraybackslash}X>{\centering\arraybackslash}X>{\centering\arraybackslash}X>{\centering\arraybackslash}X>{\centering\arraybackslash}X}
		\toprule
		PAR\_OB & 计算周期数 & 实测加速比 & 理想加速比 & bit-exact \\
		\midrule
		1  & 4384 & 1.00× & 1×  & PASS \\
		2  & 3344 & 1.31× & 2×  & PASS \\
		4  & 2824 & 1.55× & 4×  & PASS \\
		8  & 2564 & 1.71× & 8×  & PASS \\
		16 & 2434 & 1.80× & 16× & PASS \\
		\bottomrule
	\end{tabularx}
\end{table}

扫描得到两个明确结论：其一，\emph{五种并行度配置全部成功elaborate且仿真输出与golden model 100\% bit-exact一致}（errors=0/256），证明阵列架构在PAR\_OB提升至16时仍完全正确、可综合——板级部署PAR\_OB=2/3、未在板上例化更高并行度，确系PYNQ-Z2的DSP资源所限（PAR\_OB$\geq$4需$\geq$256块DSP，超出220块预算），而非架构无法支持更高并行度。其二，实测加速比\emph{次线性}：并行度提升16倍仅换来约1.80倍的周期下降。

\subsection{加速比次线性的成因分析}

次线性的根因可由FSM的周期构成精确解释。单个输出分组（ob\_group）的总周期由两部分构成：

（A）乘加阶段（可并行）。权重fetch、x\_eff锁存、4个quarter MAC子状态（TILE\_SPLIT=4）与psum累加，对N\_IB个输入块循环执行。该阶段在所有PAR\_OB份Tile上\emph{并行}完成，因此其总周期随PAR\_OB增大而减小：分组数为N\_OB/PAR\_OB，故乘加总周期从PAR\_OB=1的约2592周期降至PAR\_OB=16的约642周期。

（B）输出/requant阶段（串行）。偏置加法、激活、requant、移位、钳位、写回OBUF构成逐神经元的7级流水（ST\_BIAS\_ADD$\to\cdots\to$ST\_WRITE\_OBUF），对每个输出神经元\emph{逐一串行}处理。该阶段每个分组处理PAR\_OB$\times$16个神经元，而分组数为N\_OB/PAR\_OB，故输出阶段总周期为$\frac{N\_OB}{PAR\_OB}\times PAR\_OB\times 16\times 7 = N\_OB\times 16\times 7$，约1792周期——\emph{与PAR\_OB完全无关，是不可被并行度压缩的固定开销}。

二者叠加即为表\ref{tab:par_ob_sweep}的实测值：随PAR\_OB从1增至16，可并行的乘加阶段占比从约59\%降至约26\%，而固定的输出阶段占比从约41\%升至约74\%，逐渐主导总延迟，遵循Amdahl定律——当固定串行部分约占一半时，无论并行度多高，总加速比上限即约2倍。这一周期模型与实测值吻合至$\pm$2周期（误差仅来自ST\_IDLE/ST\_DONE边沿）。值得强调的是，单纯增大层规模并不能改善该比值：当N\_OB由16增至64时，乘加与输出阶段同比例增长，实测加速比仍恒为约1.80倍。

\subsection{提高并行度收益的途径}

上述分析直接指明了改进方向——\emph{瓶颈不在乘加并行度本身，而在串行的输出/requant流水}。据此可采取以下措施提高加速比：

（1）输出流水线化（最关键）。当前输出阶段每个神经元独占7个时钟周期（逐级走完流水），若将其改造为真正的吞吐流水线——每周期接纳一个神经元、7级填充后每周期输出一个结果——则输出阶段从$N\_OB\times16\times7$降至约$N\_OB\times16\times1$。据周期模型估算，仅此一项即可将PAR\_OB=16的加速比从1.80倍提升至约3.25倍。

（2）权重fetch与计算重叠。当前每个输入块需经ST\_FETCH/ST\_WAIT\_SRAM串行取权重（约$2\times$PAR\_OB周期），可通过预取（在当前块计算时fetch下一块权重）将其隐藏。结合输出流水线化，PAR\_OB=16的加速比可进一步提升至约5.3倍。

（3）输出阶段的并行化。更彻底的方案是让多个Tile的输出共享多套并行的requant单元，使输出阶段也随PAR\_OB缩放；代价是额外的requant逻辑面积，需与DSP/LUT预算权衡。

（4）配合DSP48 INT8 SIMD打包释放并行资源。如§\ref{sec:future_work}所述，利用单DSP48E1的25$\times$18乘法器同时计算两路INT8乘法可将DSP用量再减半（单Tile约32块），从而在同一PYNQ-Z2上将板级并行度由当前的PAR\_OB=2/3进一步提升（如PAR\_OB=4$\sim$6）。需注意：唯有在上述输出流水线化改造之后，提升的并行度才能转化为可观的端到端加速，否则收益将被固定的输出开销吞没。

综上，本节通过周期级仿真确证了阵列架构在PAR\_OB=1$\sim$16下均\emph{可综合且功能完全正确}，板级部署PAR\_OB=2/3（更高并行度仅受DSP资源约束）；同时定量揭示了当前加速比次线性的根因（串行输出流水构成约占半数的固定开销），并给出了从架构层面提高并行度收益的明确路径。
% ====================================================================
\chapter{总结与展望}
% ====================================================================

\section{工作总结}

本文设计并实现了一种面向边缘智能推理的INT8数字存算一体矩阵计算阵列架构，在PYNQ-Z2（Zynq-7020）FPGA平台上完成了完整的综合部署与板级验证。主要成果总结如下：

（1）架构设计：以16×16 CIM Tile为原子计算单元，设计了包含多级流水线的核心加速器引擎，支持通过CSR在运行时配置层维度（不超过MAX\_IN\_DIM=1536、MAX\_OUT\_DIM=256）与量化参数。所有设计参数集中管理于cim\_pkg.sv，实现了模块化、参数化的RTL框架。

（2）数据通路优化：设计了AXI4-Stream + DMA双向批量传输架构，将数据搬运从逐字MMIO替换为DMA批量传输；实现了输入/输出缓冲双bank乒乓结构，将DMA传输与硬件计算重叠执行；针对连续FC层设计了OBUF→IBUF内部硬件直拷的层融合机制，消除层间DMA往返。累计将LeNet-5端到端延迟从3,193.52 ms/img降至29.88 ms/img（约107×加速，33.5 fps）。在与ARM Cortex-A9纯软件同口径的系统级端到端对比中，CIM硬件在三种网络上均快于软件（MLP约2.24×、small\_mlp约1.23×、LeNet-5相对batched-BLAS约1.34×），在计算核纯算力口径下更领先约一到两个数量级（约65$\sim$191倍）。

（3）软件映射优化：引入并适配了块对角权重打包（SQ-mapping）这一已有的卷积映射方法，通过将多个输出像素的im2col列合并到同一次MVM调用，将小卷积核场景下的MVM调用次数削减约90\%（Conv1 97.6\%、Conv2 89.1\%），单次MVM维度占用率从不足2\%提升至约60\%--98\%。同时通过im2col/MaxPool向量化、layer-wise批量化等手段将Python侧开销压缩至总延迟的约13\%。

（4）工程问题解决：针对Vivado BRAM推断失败问题，通过16-bank权重SRAM拆分解决；针对关键路径时序违例，通过TILE\_SPLIT\_FACTOR流水拆分与后量化路径两级流水将时序收敛频率提升至64 MHz（WNS +0.013 ns、完全收敛，作为板级签核工作点），并可在75/80 MHz下功能正确运行（时序违例但常温功能正确的超频点）。

（5）软核集成与轻量化：成功集成PicoRV32 RISC-V软核替代ARM PS进行推理控制，CIM IP完全不修改。相比ARM模式，PicoRV32模式展现出显著的轻量化优势：LUT和FF均显著减少（LUT: 15231 vs 15567，-336个；FF: 14654 vs 16790，-2136个），在64 MHz下存在轻微时序违例（WNS -0.160 ns，11个failing endpoints）但常温上板功能正确。资源减少源于不需要DMA IP及其关联AXI Stream与Interconnect逻辑（合计节省超2400个LUT/FF），PicoRV32软核本身仅约1500 LUT且不含复杂流水。200张MNIST图片验证准确率约95.5\%（191/200），全部logits与ARM路径bit-exact一致。

（6）验证完备性：建立了"Python golden model → VCS仿真 → PYNQ上板"三层一致的验证流程。在两个独立测试集上，MLP网络200张图片分类准确率99.5\%、LeNet-5 CNN 200张图片99\%--100\%（二者与golden model均100\% bit-exact一致）。所有优化阶段的硬件输出均与golden model保持100\% bit-exact一致；各配置的分类准确率取决于INT8量化模型本身（见表\ref{tab:arm_multi_model}）。

\section{不足与展望}
\label{sec:future_work}

（1）DSP占用率与并行度：得益于乘法器时分复用，单Tile的DSP48E1占用由256降至约64，板级实现可在PYNQ-Z2的220块DSP内部署PAR\_OB=2（约61\%）乃至PAR\_OB=3（约90\%）；而PAR\_OB$\geq$4所需DSP超出器件预算，未能在板上例化。这是器件资源约束而非架构限制——§\ref{sec:par_ob_sweep}的VCS周期级仿真已证明阵列在PAR\_OB=1$\sim$16下均可综合且功能100\% bit-exact正确。后续可通过DSP48 INT8×2 SIMD打包技术（利用单DSP的25×18乘法器同时计算两个独立INT8乘法，将单Tile DSP用量再减半至约32块）释放资源，将板级并行度由当前的PAR\_OB=2/3进一步提升（如PAR\_OB=4$\sim$6）。但如§\ref{sec:par_ob_sweep}的成因分析所示，单纯提升并行度的收益受串行输出/requant流水（约占半数的固定开销）所限而呈次线性；唯有先将输出阶段流水线化（预期可使PAR\_OB=16的加速比从1.80倍提升至约3.25倍，叠加权重预取后约5.3倍），提升的并行度才能充分转化为端到端加速。二者结合是后续提升硬件compute吞吐的关键路径。

（2）最大维度限制：当前MAX\_IN\_DIM=1536、MAX\_OUT\_DIM=256的配置已使BRAM占用接近PYNQ-Z2的物理上限（ARM模式88.21\%、PicoRV32模式92.50\%），适用于MNIST尺度网络但无法支持CIFAR-10/ImageNet级别模型。后续需通过权重分片加载（超标层分多次加载，消除维度硬上限）或迁移至更大BRAM容量的平台来解决。

（3）更复杂网络与算子支持：当前系统已支持Conv + FC + ReLU + MaxPool组成的网络，但尚未实现AveragePool、BatchNorm、Softmax等操作以及Depthwise Convolution、Residual Connection等结构。BatchNorm可在量化阶段静态折叠入权重与偏置（RTL零改动），MaxPool硬件化可进一步消除当前毫秒量级的Python侧池化开销（见表\ref{tab:latency_breakdown}）。

（4）面向成熟推理框架的集成：当前Python驱动需要为每个网络手动编写im2col与层调度逻辑，扩展到新模型的工程成本较高。未来可将CIM硬件抽象为ONNX Runtime的自定义执行后端，仅需在卷积/全连接算子内部注册硬件调用接口，即可复用成熟推理框架的完整前端图优化与算子调度能力，一次性获得YOLO、MobileNet、SqueezeNet等主流网络的支持。

（5）稀疏计算支持：ReLU激活后的特征图典型稀疏度为40--60\%，当前设计对所有零值元素仍执行完整的MAC运算与数据搬运。通过结构化剪枝结合权重压缩传输、零值跳过FSM，可进一步降低有效计算量与DMA传输量。

（6）设计自动化：当前改变PAR\_OB等编译期参数依赖脚本以sed方式patch cim\_pkg.sv，缺乏优雅性。后续可考虑用Chisel或SpinalHDL等参数化硬件描述语言重构核心加速器，以trait形式声明层级参数，一次elaborate即可出多个配置版本，同时可利用其与Verilator的天然集成简化仿真流程。

总体而言，本文围绕在资源受限的小型FPGA上实现INT8数字存算一体计算阵列的完整验证闭环，完成了从架构设计、数据通路优化、软核集成到三层一致验证的系统性工作；上述不足与展望多集中在并行度、网络规模与算子覆盖的进一步拓展，以及向成熟推理框架和设计自动化方向的演进，它们与本文已落地的工作并不冲突，而是在同一套可复现平台之上自然延伸的下一步。

\xjtuendcontent

% ====================================================================
% 致谢
% ====================================================================
\xjtuspchapter{致谢}{致\qquad 谢}
\chaptermark{致\quad 谢}

本课题的研究工作是在梁峰老师的悉心指导下完成的，在此谨向梁老师致以最诚挚的感谢。特别感谢课题组师兄王泽宇在毕设项目中关于DMA优化方案给予的宝贵指导与帮助。同时感谢课题组各位同学在项目研发过程中给予的帮助与建议。

% ====================================================================
% 参考文献
% ====================================================================
\xjtubib{refs}

% ====================================================================
% 附录
% ====================================================================
\xjtuappendix

\xjtuappendixchapter{外文翻译（原文）}
\chaptermark{附\quad 录\ A}
% 让附录标题与PDF第一页排在同一页：保留原标题，第一页紧贴标题下方放置
\par\nointerlineskip\vspace*{-1.5cm}% 标题与图片的间距，调小或改为负值可使图片上移
\noindent
\setbox0=\hbox{}%
\hspace*{\dimexpr(\textwidth-\wd0)/2\relax}% 按纸张宽度居中（左右页边距对称）
\raisebox{-\height}[0pt][0pt]{\box0}%
% 其余页与原来完全一致
\includepdf[pages=2-,scale=0.95,offset=0 85,pagecommand={\thispagestyle{plain}}]{appendix/appendix_a_original.pdf}

\xjtuappendixchapter{外文翻译（译文）}
\chaptermark{附\quad 录\ B}
% 让附录标题与PDF第一页排在同一页：保留原标题，第一页紧贴标题下方放置
\par\nointerlineskip\vspace*{-2.0cm}% 标题与图片的间距，调小或改为负值可使图片上移
\noindent
\setbox0=\hbox{}%
\hspace*{\dimexpr(\textwidth-\wd0)/2\relax}% 按纸张宽度居中（左右页边距对称）
\raisebox{-\height}[0pt][0pt]{\box0}%
% 其余页与原来完全一致
\includepdf[pages=2-,scale=0.95,offset=0 85,pagecommand={\thispagestyle{plain}}]{appendix/appendix_b_translation.pdf}

\xjtuappendixchapter{源代码}
\chaptermark{附\quad 录\ C}

本文所述INT8 CIM加速器的全部设计源码、仿真测试平台、Python驱动与量化工具链、PicoRV32固件及FPGA综合脚本均可通过以下地址获取：

\begin{center}
\url{https://github.com/Invoker-pray/INT8-CIM-of-jiao}
\end{center}

仓库目录结构(master分支)如下：

\begin{itemize}
\item \texttt{hw/rtl/} — SystemVerilog RTL源码（CIM Tile、加速器核心、存储子系统、AXI接口）
\item \texttt{hw/tb/} — VCS仿真测试平台（Tile单元测试、系统MVM测试、MNIST端到端测试）
\item \texttt{hw/scripts/} — ARM版本仿真与综合脚本
\item \texttt{picorv32/hw/scripts + picorv32/fw} - picorv32版本仿真与综合脚本
\item \texttt{sw/} — Python驱动、量化工具链、golden model与板级benchmark
\item \texttt{picorv32/} — PicoRV32软核集成（RTL封装、固件、仿真与综合）
\item \texttt{vivado\_proj} — ARM控制模式Vivado工程（PYNQ-Z2，64/75/80 MHz）
\item \texttt{picorv32/vivado\_proj/} — PicoRV32控制模式Vivado工程（PYNQ-Z2，64/75/80 MHz）
\item \texttt{Thesis/data/} — 板级实测benchmark原始数据（CSV格式）
\end{itemize}

\xjtuendappendix

\end{document}
