Invoker-pray/INT8-CIM-of-jiao/Thesis/paper/fig/latency_breakdown.png

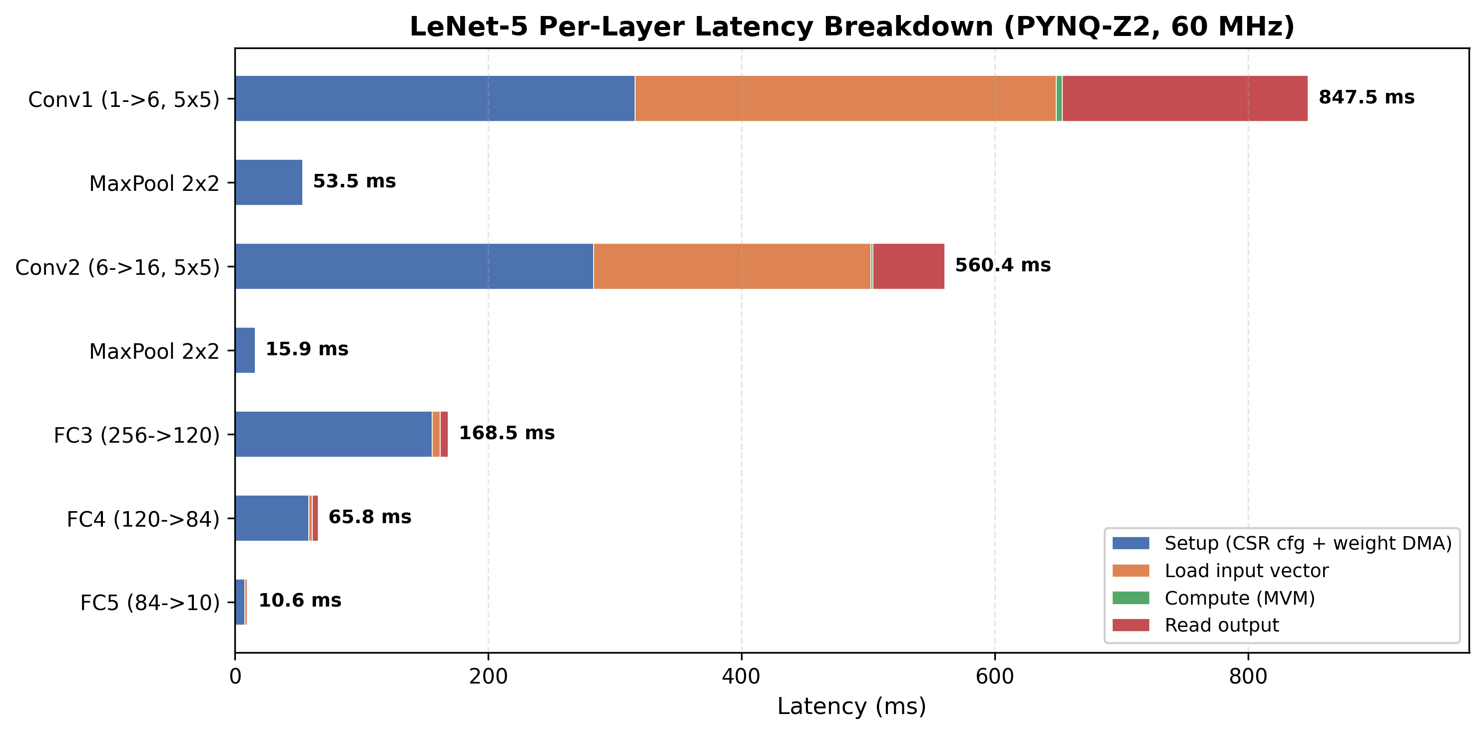
Thesis/paper/fig/latency_breakdown.png
