Invoker-pray/INT8-CIM-of-jiao/Thesis/paper/figures/XJTU_2024.png

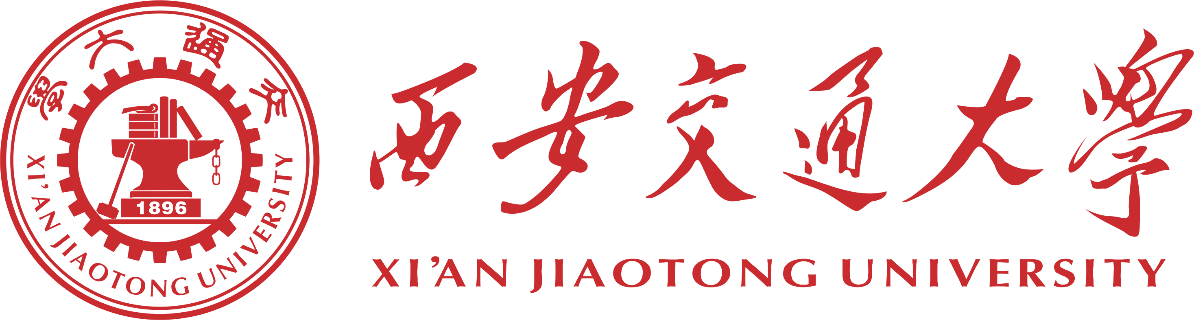
Thesis/paper/figures/XJTU_2024.png
