Invoker-pray/INT8-CIM-of-jiao/sw/scripts/benchmark_e2e.py

#!/usr/bin/env python3
"""
benchmark_e2e.py  —  End-to-end batch benchmark for thesis Chapter 5.

Usage (on PYNQ, run from sw/):
    python scripts/benchmark_e2e.py
    python scripts/benchmark_e2e.py --model lenet5 --n_images 200 --data_dir lenet5_data
    python scripts/benchmark_e2e.py --model mlp    --n_images 200 --data_dir mnist_real_data

Output:
    Console: formatted table  (Model / n_img / total_s / ms_per_img / fps / accuracy)
    File:    results/benchmark_<model>_<timestamp>.csv

The --n_images argument is capped at the number of available test images.
"""

import argparse
import glob
import os
import sys
import time
import csv
from datetime import datetime

import numpy as np


# ---------------------------------------------------------------------------
# Argument parsing
# ---------------------------------------------------------------------------
def parse_args():
    p = argparse.ArgumentParser(description="CIM SoC end-to-end batch benchmark")
    p.add_argument(
        "--model",
        default="lenet5",
        choices=["lenet5", "mlp"],
        help="Model architecture (default: lenet5)",
    )
    p.add_argument(
        "--n_images",
        type=int,
        default=200,
        help="Number of test images (default: 200; capped by available images)",
    )
    p.add_argument(
        "--data_dir",
        default=None,
        help="Data directory (default: lenet5_data / mnist_real_data)",
    )
    p.add_argument(
        "--bitstream",
        default="cim_soc.bit",
        help="Bitstream path (default: cim_soc.bit)",
    )
    p.add_argument(
        "--out_dir",
        default="results",
        help="Directory for CSV output (default: results/)",
    )
    p.add_argument(
        "--use-dma",
        action="store_true",
        help="Enable experimental DMA data path (default: legacy MMIO)",
    )
    p.add_argument(
        "--batch",
        action="store_true",
        help="Use layer-wise batching (predict_batch) for optimized throughput",
    )
    p.add_argument(
        "--no-fusion",
        action="store_true",
        help="Disable Phase C FC-layer fusion for A/B comparison",
    )
    p.add_argument("--verbose", action="store_true", help="Print per-image prediction")
    p.add_argument(
        "--out-name",
        default=None,
        help="Exact CSV basename (no extension). If omitted, a timestamped "
        "name benchmark_<model>_<ts> is used. Used by benchmark.py to "
        "produce precisely-named files like arm_dma_batch_<model>.csv.",
    )
    return p.parse_args()


# ---------------------------------------------------------------------------
# Helpers
# ---------------------------------------------------------------------------
def make_csv_basename(args):
    """Build the CSV basename from the run configuration.

    Pattern:  arm{_dma}{_batch}{_no-fusion}_{data_dir}
      - controller prefix is always "arm" here (ARM PS controls the run)
      - "_dma"        present iff --use-dma
      - "_batch"      present iff --batch
      - "_no-fusion"  present iff --no-fusion
      - data_dir is the basename of --data_dir (e.g. lenet5_data, mnist_real_data,
        small_mlp_data), trailing slashes stripped

    Examples:
      arm_lenet5_data                      (MMIO, no batch, fusion on)
      arm_dma_lenet5_data                  (DMA only)
      arm_dma_batch_lenet5_data            (DMA + batch, fusion on)
      arm_dma_batch_no-fusion_lenet5_data  (DMA + batch, fusion off)
    """
    data_tag = os.path.basename(os.path.normpath(args.data_dir))
    parts = ["arm"]
    if args.use_dma:
        parts.append("dma")
    if args.batch:
        parts.append("batch")
    if args.no_fusion:
        parts.append("no-fusion")
    parts.append(data_tag)
    return "_".join(parts)


def read_hex_u8(path):
    with open(path) as f:
        return [int(line.strip(), 16) & 0xFF for line in f if line.strip()]


def load_lenet5_model(drv, data_dir):
    from cim_driver import CIMModel, weight_to_chunks, bias_to_u32

    d = np.load(os.path.join(data_dir, "lenet5_qparams.npz"))
    model = CIMModel(drv)

    model.add_conv(
        d["conv1_weight"],
        d["conv1_bias"],
        zp=int(d["conv1_zp"]),
        mult=int(d["conv1_mult"]),
        shift=int(d["conv1_shift"]),
        stride=1,
        padding=0,
        relu=True,
    )
    model.add_pool(2, 2)

    model.add_conv(
        d["conv2_weight"],
        d["conv2_bias"],
        zp=int(d["conv2_zp"]),
        mult=int(d["conv2_mult"]),
        shift=int(d["conv2_shift"]),
        stride=1,
        padding=0,
        relu=True,
    )
    model.add_pool(2, 2)

    model.add_fc(
        256,
        120,
        weight_to_chunks(d["fc3_weight"]),
        bias_to_u32(d["fc3_bias"]),
        zp=int(d["fc3_zp"]),
        mult=int(d["fc3_mult"]),
        shift=int(d["fc3_shift"]),
        relu=True,
        weight_int8=d["fc3_weight"],
        bias_int32=d["fc3_bias"],
    )
    model.add_fc(
        120,
        84,
        weight_to_chunks(d["fc4_weight"]),
        bias_to_u32(d["fc4_bias"]),
        zp=int(d["fc4_zp"]),
        mult=int(d["fc4_mult"]),
        shift=int(d["fc4_shift"]),
        relu=True,
        weight_int8=d["fc4_weight"],
        bias_int32=d["fc4_bias"],
    )
    model.add_fc(
        84,
        10,
        weight_to_chunks(d["fc5_weight"]),
        bias_to_u32(d["fc5_bias"]),
        zp=int(d["fc5_zp"]),
        mult=int(d["fc5_mult"]),
        shift=int(d["fc5_shift"]),
        relu=False,
        weight_int8=d["fc5_weight"],
        bias_int32=d["fc5_bias"],
    )

    return model


def load_mlp_model(drv, data_dir):
    from cim_driver import CIMModel, weight_to_chunks, bias_to_u32

    # mnist_real_data: quant_params.hex + fc1/fc2 weight/bias tiles
    qp_path = os.path.join(data_dir, "quant_params.hex")
    with open(qp_path) as f:
        vals = [int(l.strip(), 16) for l in f if l.strip()]
    # [fc1_mult, fc1_shift, fc2_mult, fc2_shift]
    fc1_mult, fc1_shift, fc2_mult, fc2_shift = vals[:4]

    # ---- Zero points ----
    # The MNIST 784->128->10 and small_mlp 784->16->10 models are BOTH quantized
    # with input zp = 0 (x_eff = x_u8 - 0 = x_u8).  Using zp = -128 here injects a
    # constant +128 into every input element, which dominates FC1 and collapses
    # every prediction to a single fixed class.  Therefore:
    #   - if zero_points.hex exists, read it (with signed restore — -128 is
    #     stored as the unsigned word 0xffffff80);
    #   - if it does NOT exist, default to 0  (NOT -128), matching how the
    #     models were actually quantized.
    def _to_signed32(v):
        return v - 0x100000000 if (v & 0x80000000) else v

    zp_path = os.path.join(data_dir, "zero_points.hex")
    if os.path.exists(zp_path):
        with open(zp_path) as f:
            zp_vals = [int(l.strip(), 16) for l in f if l.strip()]
        fc1_zp = _to_signed32(zp_vals[0]) if zp_vals else 0
        fc2_zp = _to_signed32(zp_vals[1]) if len(zp_vals) > 1 else 0
    else:
        fc1_zp = fc2_zp = 0
    print(
        f"  MLP zero points: fc1_zp={fc1_zp}, fc2_zp={fc2_zp} "
        f"({'from zero_points.hex' if os.path.exists(zp_path) else 'default 0'})"
    )

    # Load weight tiles as raw chunk lists
    def load_hex_u32(path):
        with open(path) as f:
            return [int(l.strip(), 16) for l in f if l.strip()]

    fc1_chunks = load_hex_u32(os.path.join(data_dir, "fc1_weight_tiles.hex"))
    fc2_chunks = load_hex_u32(os.path.join(data_dir, "fc2_weight_tiles.hex"))
    fc1_bias = load_hex_u32(os.path.join(data_dir, "fc1_bias.hex"))
    fc2_bias = load_hex_u32(os.path.join(data_dir, "fc2_bias.hex"))

    model = CIMModel(drv)
    # model.add_fc(784, 128, fc1_chunks, fc1_bias,
    #             zp=fc1_zp, mult=fc1_mult, shift=fc1_shift, relu=True)
    # model.add_fc(128, 10, fc2_chunks, fc2_bias,
    #             zp=fc2_zp, mult=fc2_mult, shift=fc2_shift, relu=False)
    # return model

    # Infer the hidden dimension from the data instead of hardcoding 128, so the
    # same `--model mlp` works for BOTH 784->128->10 (mnist_real_data) and
    # 784->16->10 (small_mlp_data). fc1_bias holds exactly one INT32 per fc1
    # output neuron with no padding (see golden_model_torch.py / small_mlp_
    # quantize.py), therefore len(fc1_bias) == hidden dim.
    hidden = len(fc1_bias)
    print(f"  MLP hidden dim inferred from fc1_bias: 784 -> {hidden} -> 10")
    model.add_fc(
        784,
        hidden,
        fc1_chunks,
        fc1_bias,
        zp=fc1_zp,
        mult=fc1_mult,
        shift=fc1_shift,
        relu=True,
    )
    model.add_fc(
        hidden,
        10,
        fc2_chunks,
        fc2_bias,
        zp=fc2_zp,
        mult=fc2_mult,
        shift=fc2_shift,
        relu=False,
    )
    return model


# ---------------------------------------------------------------------------
# Main
# ---------------------------------------------------------------------------
def main():
    args = parse_args()

    if args.data_dir is None:
        args.data_dir = "lenet5_data" if args.model == "lenet5" else "mnist_real_data"

    img_dir = os.path.join(args.data_dir, "test_images")
    img_files = sorted(glob.glob(os.path.join(img_dir, "img_????.hex")))
    if not img_files:
        print(f"ERROR: no test images found in {img_dir}", file=sys.stderr)
        sys.exit(1)

    n = min(args.n_images, len(img_files))
    img_files = img_files[:n]
    print(f"Benchmark: model={args.model}, n_images={n}, data_dir={args.data_dir}")

    # Load driver + model
    from cim_driver import CIMDriver

    print(f"Loading bitstream {args.bitstream} ...")
    drv = CIMDriver(args.bitstream, use_dma=args.use_dma)
    print(f"Driver mode: {'DMA' if args.use_dma else 'legacy MMIO'}")
    if args.model == "lenet5":
        model = load_lenet5_model(drv, args.data_dir)
        input_shape = (1, 28, 28)
    else:
        model = load_mlp_model(drv, args.data_dir)
        input_shape = (784,)
    if args.no_fusion:
        model.use_fusion = False

    print(f"Model loaded. Starting benchmark on {n} images ...\n")

    # ---------------------------------------------------------------------------
    # Inference loop
    # ---------------------------------------------------------------------------
    correct = 0
    wrong_list = []

    # Load all images + labels
    all_images = []
    all_labels = []
    all_names = []
    for img_path in img_files:
        name = os.path.basename(img_path).replace(".hex", "")
        img_u8 = np.array(read_hex_u8(img_path), dtype=np.uint8)
        label_path = os.path.join(img_dir, f"{name}_label.txt")
        label = int(open(label_path).read().strip())
        all_images.append(img_u8.reshape(input_shape))
        all_labels.append(label)
        all_names.append(name)

    t_start = time.time()

    if args.batch:
        # Layer-wise batching: load weights ONCE per layer
        results, prof = model.predict_batch(all_images, profile=True)
        for (pred, _), label, name in zip(results, all_labels, all_names):
            if pred == label:
                correct += 1
            else:
                wrong_list.append((name, pred, label))
                if args.verbose:
                    print(f"  WRONG {name}: pred={pred} label={label}")

        # Print batch profiler report
        print("\n--- Batch Profiler (per-image avg) ---")
        if prof:
            total = prof.get("total_ms", 0)
            n_img = prof.get("n_images", 1)
            per_img = total / n_img
            print(f"  {'Phase':<30s} {'avg_ms':>8s}  {'pct':>6s}")
            print(f"  {'-' * 30}  {'-' * 8}  {'-' * 6}")

            # Aggregate per-phase timings across all layers
            # Primary phases (mutually exclusive):
            #   im2col → pack → (load_x → compute → read_out) → pool
            # setup is amortized per-layer config+load_w+load_b
            # dma_x_* are sub-components of load_x (not additive)
            primary_keys = (
                "im2col_ms",
                "pack_ms",
                "setup_ms",
                "load_x_ms",
                "compute_ms",
                "read_out_ms",
                "pool_ms",
            )
            detail_keys = ("dma_x_setup_ms", "dma_x_transfer_ms")
            agg = {}
            for l in prof.get("layers", []):
                for k in primary_keys + detail_keys:
                    agg[k] = agg.get(k, 0) + l.get(k, 0)

            # Print primary phases
            for k in primary_keys:
                v = agg.get(k, 0)
                if v > 0.005:
                    pct = v / per_img * 100 if per_img else 0
                    print(f"  {k:<30s} {v:8.2f}  {pct:5.1f}%")

            # Detail sub-timings (indented, no double-count in gap)
            for k in detail_keys:
                v = agg.get(k, 0)
                if v > 0.005:
                    print(f"    {k:<28s} {v:8.2f}  {'(sub)'}")

            # Final argmax
            final_ms = prof.get("final_ms", 0)
            if final_ms > 0.005:
                print(
                    f"  {'final_ms':<30s} {final_ms:8.2f}  {final_ms / per_img * 100:5.1f}%"
                )

            # Compute gap: per_img minus primary phases minus final
            prof_sum = sum(agg.get(k, 0) for k in primary_keys) + final_ms
            gap = per_img - prof_sum
            if gap > 0.5:
                print(f"  {'(other/unprofiled)':<30s} {gap:8.2f}")
            print(f"  {'-' * 30}  {'-' * 8}  {'-' * 6}")
            print(f"  {'TOTAL':<30s} {per_img:8.2f}")
            print()
    else:
        for name, img_u8, label in zip(all_names, all_images, all_labels):
            pred, _ = model.predict(img_u8)
            if pred == label:
                correct += 1
            else:
                wrong_list.append((name, pred, label))
                if args.verbose:
                    print(f"  WRONG {name}: pred={pred} label={label}")

    t_end = time.time()

    # ---------------------------------------------------------------------------
    # Results
    # ---------------------------------------------------------------------------
    total_s = t_end - t_start
    ms_per_img = total_s / n * 1000
    fps = n / total_s
    accuracy = correct / n * 100

    # Table header
    col = [
        ("Model", 10),
        ("n_img", 6),
        ("total_s", 9),
        ("ms/img", 9),
        ("fps", 7),
        ("accuracy", 10),
    ]
    hdr = "  ".join(f"{name:<{w}}" for name, w in col)
    sep = "  ".join("-" * w for _, w in col)
    vals = [
        args.model,
        str(n),
        f"{total_s:.2f}s",
        f"{ms_per_img:.1f}",
        f"{fps:.2f}",
        f"{correct}/{n} ({accuracy:.1f}%)",
    ]
    row = "  ".join(f"{v:<{w}}" for v, (_, w) in zip(vals, col))

    print(sep)
    print(hdr)
    print(sep)
    print(row)
    print(sep)

    if wrong_list:
        print(f"\nWrong predictions ({len(wrong_list)}):")
        for name, pred, label in wrong_list:
            print(f"  {name}: pred={pred} label={label}")

    # ---------------------------------------------------------------------------
    # CSV output
    # ---------------------------------------------------------------------------
    os.makedirs(args.out_dir, exist_ok=True)
    ts = datetime.now().strftime("%Y%m%d_%H%M%S")
    # Auto-name from config (arm{_dma}{_batch}{_no-fusion}_{data_dir}); an
    # explicit --out-name overrides; otherwise fall back to timestamped.
    if args.out_name:
        base = args.out_name
    else:
        base = make_csv_basename(args)
    csv_path = os.path.join(args.out_dir, f"{base}.csv")
    with open(csv_path, "w", newline="") as f:
        writer = csv.writer(f)
        writer.writerow(
            [
                "model",
                "n_img",
                "total_s",
                "ms_per_img",
                "fps",
                "correct",
                "accuracy_pct",
            ]
        )
        writer.writerow(
            [
                args.model,
                n,
                f"{total_s:.3f}",
                f"{ms_per_img:.2f}",
                f"{fps:.3f}",
                correct,
                f"{accuracy:.2f}",
            ]
        )
    print(f"\nCSV saved: {csv_path}")


if __name__ == "__main__":
    main()
