Invoker-pray/INT8-CIM-of-jiao/(commit log)

2026-03-19 Thu Mar 19 07:53:03 PM CST 2026 fix the accel problem: golden model signal extension wrong.
    [bias_sram.sv, cim_accel_core.sv, cim_axi_lite_slave.sv, cim_pkg.sv, cim_tile.sv, input_buffer.sv, output_buffer.sv]
2026-03-19 Thu Mar 19 09:49:30 PM CST 2026 fix 5 problems: 1. weight_sram change to BRAM-friendly; 2. AXI achieve two channel(AWVALID, WVALID) independently hand shake; 3. weight DMA -> burst mode; 4. argmax lo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
    [cim_axi_lite_slave.sv, output_buffer.sv, weight_sram.sv]
2026-03-19 Thu Mar 19 10:15:41 PM CST 2026 done: 1. mnist end to end testbench, pass; 2. modify the sw/golden_model.py, add print usage, add im2col explicit and implicit;
2026-03-19 Fri Mar 20 01:08:09 AM CST 2026 update: README.md; modify: hw/rtl/mem/weight_mem.sv, must read-write in words, so it will be inferenced as BRAM; modify: hw/rtl/axi/cim_axi_lite_slave, fix the chunck 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
    [cim_axi_lite_slave.sv, weight_sram.sv]
2026-03-19 Fri Mar 20 01:19:07 AM CST 2026 modify: hw/rtl/axi/cim_axi_lite_slave.sv , little bug, change ibuf_x_tile from logic signed to logic.
    [cim_axi_lite_slave.sv]
2026-03-20 Fri Mar 20 04:18:22 PM CST 2026 modify(hw): rtl/pkg.cim_pkg.sv, rtl/axi/cim_axi_lite_slave(_wrapper).sv, scripts/vivado_build.tcl, fixed address bugs bychanging address schedule.
    [cim_axi_lite_slave.sv, cim_axi_lite_slave_wrapper.v, cim_pkg.sv]
2026-03-20 Fri Mar 20 04:42:21 PM CST 2026 modify: hw/rtl/cim_axi_lite_slave.sv, hw/rtl/mem/weight_sram.sv, fixed 2 problems: 1. brust mode chunk_idx shift wrong; 2. weight_sram RMW pipeline adventure. modify: 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
    [cim_axi_lite_slave.sv, weight_sram.sv]
2026-03-20 Fri Mar 20 05:18:08 PM CST 2026 change some rtl file to fix the cacluate error.
    [cim_axi_lite_slave.sv, input_buffer.sv, weight_sram.sv]
2026-03-20 Fri Mar 20 05:34:45 PM CST 2026 change some rtl file to fix the cacluate error.(part2)
    [tb_cim_accel_core.sv, tb_mnist_e2e.sv]
2026-03-20 Fri Mar 20 09:22:35 PM CST 2026 update README.md; modify: cim_pkg.sv, cim_accel_core.sv. tb_cim_accel_core.sv, vivado_build.tcl, change cim_accel_core.sv to pipeline, fix timing violation. delete: hw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
    [cim_accel_core.sv, cim_pkg.sv, tb_cim_accel_core.sv]
2026-03-21 Sat Mar 21 02:56:59 PM CST 2026 modify: cim_pkg.sv, add 3 stages; cim_accel_core.sv, divide the compute path into 3 stages: (1). ST_XEFF_REG: BREAM-read + ZP substract + latch x_eff_reg; (2). ST_MAC,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
2026-03-21 Sat Mar 21 03:54:22 PM CST 2026 modify: cim_pkg.sv, cim_accel_core.sv, run_tb_cim_accel_core.sh, run_tb_mnist_e2e.sh. divide ST_STORE into 2 stage: ST_STORE: requantize + store result to requant_r; S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
2026-03-21 modify: cim_pkg.sv, cim_accel_core.sv, divide ST_STORE into 2 stage, seperate MAC and (rounding + clamp).
2026-03-22 checkpoint 1: 现在是2026.03.22，已经基本完成了step 1~3的所有内容。当前的项目是，已经实现了PL侧，硬件的MVM + bias + ReLU + Requantize, 软件侧实现了im2col, 当然也完全可以支持MaxPool等计算，还没考虑但是应该比较容易实现的是AveragePool, Dropout, BatchNorm, Softmax等。
    现在理论上已经可以跑所有由组成的网络，已经覆盖了大多数CNN；当前的实际瓶颈是硬件尺寸限制导致输入不能够大于784x128，Conv 层 im2col 后 col_len = C_in × K × K 不能超过 784，C_out 不能超过 128。对于 MNIST 尺寸的网络完全够用，但跑 ImageNet 级别的模型就需要分块或扩容，这一点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
2026-03-23 Mon Mar 23 03:57:59 PM CST 2026 modify: picorv32/ , fixed some path wrong.
    [cim_rv32_top.sv, firmware.c, gen_fw_data.py, picorv32_cim_bridge.sv, small_mlp_quantize.py, tb_cim_rv32.sv, uart_tx.sv]
2026-03-23 Mon Mar 23 04:28:06 PM CST 2026 modify: picorv32/ , fixed some problems. patch 1
    [gen_fw_data.py, verilog_byte_to_word.py]
2026-03-23 Mon Mar 23 04:37:33 PM CST 2026 fix picorv32 problems, patch 3
    [cim_rv32_top.sv]
2026-03-23 Mon Mar 23 11:44:18 PM CST 2026 vivado_build, patch 3. problem remain: not generate fw_hex_batch/golden_result.txt; change mode to simutanrously run a notebook on hostPC and PYNQ respectively, achiev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
2026-03-29 Sun Mar 29 04:44:04 PM CST 2026 fixed syntax error in picorv32/hw/tb/tb_cim_rv32.sv
    [tb_cim_rv32.sv]
2026-03-31 Tue Mar 31 10:41:46 PM CST 2026 modify: picorv32/hw, cim_rv32_top.sv, tb_cim_rv.sv, update tb and top, fixed some matching problems.
    [cim_rv32_top.sv, tb_cim_rv32.sv]
2026-04-10 update paper (36p), README, docs, sw: step6 Phase2-3 + B3 benchmark
    - paper.tex: add §2.1 CIM两种实现极端对比, §4.5 SQ-mapping优化,
    §4.6.3 profiler延迟拆解, §5.2 扩展未来工作(6)(7)(8), 更新KV260状态
    - sw/scripts/benchmark_e2e.py: 新增端到端batch benchmark脚本
    - sw/benchmark_lenet5_20260410.csv: LeNet-5 200张实测数据(99.5%, 1625ms/img)
    - sw/lenet5_test_pynq.ipynb: 精简重写(14→7 cells), 使用cim_driver API
    - docs/sw_usage.md: 新增benchmark_e2e.py文档
    - README.md: step6 Phase2/3 全部打勾
    [benchmark_lenet5_20260410.csv]
2026-04-10 paper polish: add table refs, latency figure; pytest regression; README fix
    Paper (36p):
    - Add 10 missing \ref citations for tables/sections (tab:util_arm,
    tab:timing_arm, tab:mlp_perf, tab:lenet5_perf, tab:hw_latency,
    tab:speedup, tab:util_rv32, tab:rv32_verify, sec:two_extremes,
    sec:sqmapping).
    - Insert latency breakdown figure (fig/latency_breakdown.pdf) into
    profiler section — compute (green) is barely visible, visually
    conveying that MMIO transfer is the bottleneck, not HW compute.
    - Remove duplicate bib entry Sun2023AFS (already done in prior commit,
    refs.bib cleanup).
    Testing:
    - Add sw/tests/ with 16 offline pytest cases (0.08s):
    test_golden_model.py (10): zero_point,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
2026-04-10 add 55MHz timing-clean variant: TCL/XDC/benchmark + paper update
    - hw/scripts/vivado_build_55mhz.{sh,tcl}: new build targeting 55 MHz
    (same RTL, eliminates WNS=-0.086ns on CIM Tile MAC chain)
    - hw/constraints/cim_soc_55mhz.xdc: 18.182ns period constraint
    - sw/benchmark_lenet5_55mhz.csv: 200-img LeNet-5 result at 55MHz
    (199/200=99.5%, wall time 339.3s vs 325.1s at 60MHz, +4.4%)
    - paper.tex: add §5.3 "55MHz时序收敛变体" with comparison table;
    fix unit spacing (MHz/ns/μs/W throughout); replace bare μ with
    $\mu$ to fix missing-character warning; update conclusion §(2)
    [benchmark_lenet5_55mhz.csv]
2026-04-18 docs(c3): add design spec + README step 8 rewrite + design prompts
    docs/c3_dma_design.md (604 lines) — authoritative C3 design spec:
    §0 profiler motivation (LeNet-5 1696 ms/img, 99.7% in MMIO)
    §1 design principles (bit-exact hard constraint, zero core RTL churn)
    §2 PS-PL topology + Python data flow
    §3 cim_axi_stream_sink interface + FSM + tready/tlast policy
    §4 file change manifest
    §5 Vivado BD TCL increments (HP0, GP1, axi_dma_0, xlconcat, psr_dma)
    §6 cim_driver.py use_dma path
    §7 verification strategy (unit TB, e2e, pytest mock)
    §8 risk register (7 items)
    §9 6-commit rollout + 1 cleanup
    §10-11 open questions + references
    README.md step 8 rewritten to ali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
2026-04-18 feat(rtl): add cim_top wrapper + MUX on memory writes (C3 commit 3)
    Third RTL commit of C3 — wires the sink into the memory-write path.
    - hw/rtl/cim_top.sv (NEW) — new IP top. Instantiates cim_axi_lite_slave
    + cim_axi_stream_sink and wires:
    * slave side-band outputs (cfg_dest/len/base_addr, cfg_start,
    status_clear, stream_path_en) → sink inputs
    * sink status (busy/done/overflow/underflow) → slave
    * sink memory-write ports (wsram/ibuf/bsram) → slave's new
    stream_*_wr_* input ports
    Exposes S_AXI_LITE + S_AXIS_DATA + irq_done to BD.
    - hw/rtl/axi/cim_axi_lite_slave.sv —
    * Added 10 new input ports: stream_wsram_wr_*, stream_ibuf_wr_*,
    stream_bsr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
2026-04-18 feat(bd): integrate axi_dma + S_AXI_HP0 + xlconcat (C3 commit 4)
    Fourth C3 commit — point of no return. Tag pre-c3-bd at HEAD~1
    (37bf6c4) is the rollback target if this BD integration breaks build
    or bit-exact regression.
    - hw/rtl/cim_top_wrapper.v (NEW) — pure-Verilog BD top for cim_top.sv.
    Exposes S_AXI (AXI4-Lite CSR) + S_AXIS (AXI4-Stream data) + irq_done.
    Bundle inference follows Xilinx conventions (S_AXI_* / S_AXIS_*).
    - hw/scripts/vivado_build.tcl:
    * rtl_files: +cim_axi_stream_sink.sv, cim_top.sv, cim_top_wrapper.v
    (legacy cim_axi_lite_slave_wrapper.v retained for rollback).
    * PS config: +PCW_USE_M_AXI_GP1, +PCW_USE_S_AXI_HP0 (64-bit),
    +PCW_NUM_F2P_INTR_I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
2026-04-18 feat(sw): add DMA data path behind use_dma flag (C3 commit 5)
    Fifth C3 commit — software driver gains the AXI-Stream + axi_dma path.
    Default `use_dma=False` preserves the legacy MMIO behavior; existing
    notebooks run unchanged. Commit 6 will flip the default to True after
    on-board 200-image bit-exact validation on the new bitstream.
    sw/cim_driver.py:
    - CSR constants: +_CSR_STREAM_DEST (0x050), +_CSR_STREAM_LEN (0x054),
    +_CSR_STREAM_STATUS (0x058), +_CTRL_STREAM_EN (bit 3),
    +_DEST_{WEIGHT,INPUT,BIAS} codes.
    - CMA buffer sizing: _DMA_BUF_WEIGHTS=20000, _DMA_BUF_INPUT=200,
    _DMA_BUF_BIAS=128 (covers LeNet-5 Conv2 packed weight ~2400 chunks
    with 4× headroom).
    - CIMDriver.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
2026-04-18 feat: enable DMA path by default + track step 8 landing (C3 commit 6)
    Sixth C3 commit — code-side complete. Flips `use_dma=True` default so
    new CIMDriver() uses the stream path out of the box. Users with
    pre-C3 bitstreams must pass use_dma=False or rebuild.
    The benchmark + paper half of the original commit 6 intent (LeNet-5
    200-image accuracy / throughput measurement and paper section rewrite)
    requires on-board runs and is left explicitly to the author:
    bash hw/scripts/vivado_build.sh
    # copy cim_soc.bit / .hwh to PYNQ-Z2
    # run lenet5_test_pynq.ipynb → 200 images must hit 99.5% acc
    python sw/scripts/benchmark_e2e.py --model lenet5 --n_images 200
    # A2 profiler: load_w_ms fracti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
2026-04-20 feat: C3 55MHz build fix + paper data update + multifreq notebook
    - hw/scripts/vivado_build_55mhz.tcl: use signal-level AXIS wiring
    (connect_bd_net) instead of connect_bd_intf_net to bypass BD 41-237
    FREQ_HZ mismatch at non-standard 55 MHz (Zynq PLL ~55.17 MHz)
    - hw/scripts/vivado_build.tcl: sync AXIS wiring approach
    - Thesis/paper/paper.tex: update 55MHz comparison table with measured
    data (340.1s/343.9s wall time, 99.5% acc), update SQ-mapping
    table (340.1s baseline), update C3 benchmark MMIO column,
    update TODO markers
    - sw/benchmark_lenet5_60mhz_checkpoint3_c3.csv: 200-img results
    - sw/benchmark_lenet5_55mhz_checkpoint3_c3.csv: 200-img results
    - sw/lenet5_test_pynq_multifreq.ip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
    [benchmark_lenet5_55mhz_checkpoint3_c3.csv, benchmark_lenet5_60mhz_checkpoint3_c3.csv]
2026-04-20 feat(rtl): C1 pipeline split (ST_MAC_LO/HI, ST_SHIFT/CLAMP) + multi-freq builds
    - psum_accum: fix SPLIT=2 lo+hi accumulation in same clock edge
    - cim_tile: fix unpacked array assignment with for-loop psum_lo/psum_hi
    - cim_accel_core: split requantize into ST_SHIFT + ST_CLAMP (cut barrel-shifter path)
    - psum_accum: use registered tile_psum_lo_reg/hi_reg instead of combinational lo/hi tile
    - cim_pkg: add ST_SHIFT/ST_CLAMP states
    - vivado_build*.tcl/sh: multi-freq TCL variants (70/100/125MHz)
    - cim_soc_*.xdc: clock constraints for each frequency
    - benchmark CSV: LeNet-5 200 images @ 70MHz result
    - cim_driver: use_dma default + minor fixes
    Regression: 3/3 PASS (tb_cim_tile, tb_cim_accel_core, t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
    [benchmark_lenet5_70mhz_checkpoint3_c3.csv]
2026-04-22 fix(rtl): Fix DMA staging register timing bug in stream sink
    Critical fix for AXI-Stream data path that was causing 8.5% accuracy
    in DMA mode vs 99.5% in MMIO mode.
    Root cause:
    - Original code updated all 4 chunks (0-3) into staging register
    - When chunk_full (chunk 3), it used staging[127:96] which hadn't
    been updated yet in that cycle (timing bug)
    Fix:
    - Move staging register updates INSIDE else block
    - Only chunks 0-2 update staging register
    - Chunk 3 uses s_axis_tdata directly: {s_axis_tdata, staging[95:0]}
    - Applied same fix to both DEST_WEIGHT and DEST_INPUT paths
    Also added cfg_continue support to preserve staging state across
    chunked transfers.
    Expected result: DMA accuracy sho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
    [cim_axi_lite_slave.sv, cim_axi_stream_sink.sv]
2026-04-23 feat(c3): DMA fix verified + paper updated + debug scripts cleanup
    - tb: wire cfg_continue port (was X, caused all weight SRAM reads to return X)
    - tb: add test 8 — chunked transfer with cfg_continue=1 (mid-tile split)
    - sw: fix start_and_wait() clearing CTRL[3] stream-enable on every inference
    - paper: fill c3_benchmark table with real data (DMA 503.7ms, 3.35× speedup)
    - paper: add DMA bottleneck analysis + 125MHz optimization roadmap
    - sw: add benchmark_e2e_60mhz_{dma,mmio}.csv results
    - chore: delete 21 one-shot DMA debug scripts
    [benchmark_e2e_60mhz_dma.csv, benchmark_e2e_60mhz_mmio.csv]
2026-04-23 Thu Apr 23 04:49:16 PM CST 2026
    [benchmark_lenet5_20260410.csv, benchmark_lenet5_55mhz.csv, benchmark_lenet5_55mhz_checkpoint3_c3.csv, benchmark_lenet5_60mhz_checkpoint3_c3.csv, benchmark_lenet5_70mhz_checkpoint3_c3.csv]
2026-05-02 docs(CLAUDE.md): update Step 8/C3 status — DMA benchmark completed
    - DMA 上板 benchmark 已完成: 60MHz 503.65 ms/img, 55MHz 收敛通过
    - 实测 speedup 3.4× (vs MMIO 1690.54 ms/img), accuracy 99.50%
    - 数据: sw/benchmark_e2e_60mhz_dma.csv, sw/benchmark_e2e_60mhz_mmio.csv
    - 瓶颈描述从 'MMIO is bottleneck, ~270× expected' 修正为 'DMA已实现, speedup 3.4×, 下一步profile定位新瓶颈'
    - 移除过时的 Step 8 commit 6 '待跑benchmark' 描述
2026-05-02 docs(README): update C3/DMA benchmark results + add Karpathy guidelines
    - commit 6 状态: 🔄 → ✅, 补实际benchmark数据 (3.4× speedup, 99.50% acc)
    - 预期收益表: 理论值替换为实测数据, 标注实际瓶颈分析待做
    - checkpoint 3 '待完成' → '当前进度', 明确下一步指向 OPTIMIZATION_ROADMAP.md
    - CLAUDE.md 末尾追加 Karpathy 四条编码准则 (fork from forrestchang/andrej-karpathy-skills)
2026-05-02 docs: add OPTIMIZATION_ROADMAP — 20+ optimization directions prioritized P0-P3
    六大方向:
    P0: Pipeline双缓冲 + DMA latency profile
    P1: CIM Compiler + 稀疏权重 (DUB Sparsity) + Mixed precision
    P2: 时钟提升 + PicoRV32自主推理 + Transformer Attention (CIMple 2026.04)
    P3: Multi-tile KV260 + 误差建模
    References: CIMple, TinyMOA, DUB Sparsity, PSumSim, BUAA CIM Literature List
    基于 Andrej Karpathy 编码准则完成调研
2026-05-02 perf(sw): add DMA-specific profiler + latency analysis report
    cim_driver.py:
    - _stream_load: 新增 _dma_timings 参数, 区分 dma_setup_ms/dma_transfer_ms
    - load_weights/load_bias/load_input: 透传 _dma_timings
    - infer_fc: DMA 模式下输出 dma_w_setup_ms/dma_w_transfer_ms 等细分
    scripts/dma_latency_report.py (新):
    - 读取 benchmark CSV → 理论延迟分解报告
    - 诊断: PYNQ DMA API开销 = 89% (180 calls × 2.5ms PYNQ overhead)
    - 建议: merge DMA transfers (183→61 calls), read_output S2MM
    验证: 脚本输出与实际 60MHz DMA benchmark CSV 对照, 误差 5.2%
2026-05-03 fix(sw): forward DMA timing fields through infer_fc_input_only + profile output
    infer_fc_input_only() now passes _dma_timings to load_input(), so Conv
    layers get non-zero dma_x_setup_ms/dma_x_transfer_ms. FC and Conv
    profile dicts also forward all DMA sub-fields for per-layer breakdown.
    Add dma_profiler_test.ipynb for on-board profiler runs.
2026-05-03 feat(rtl,sw): P0 — DMA S2MM read_output eliminates serial MMIO bottleneck
    Profiler shows read_output MMIO at 257ms (61.7% of 416ms e2e per-image).
    RTL: new cim_axi_stream_source.sv (~130 lines), AXIS master reads
    output_buffer and streams ceil(N/4) 32-bit beats via M_AXIS_RESULT.
    CSR_RESULT_LEN/CTRL/STATUS at 0x060/0x064/0x068. obuf_rd_addr MUX
    between legacy AXI read FSM and stream source.
    BD: axi_dma S2MM enabled (c_include_s2mm=1, 32-bit), M_AXIS_RESULT
    connected to S_AXIS_S2MM. HP1 enabled for S2MM DDR writes.
    xlconcat expanded 2→3 ports for s2mm_introut.
    Python: read_output() auto-detects DMA, uses dma.recvchannel for
    N-element read-back in one transfer. Legacy MMIO fallback pres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
2026-05-03 fix(rtl,sw): resolve multi-driver on result_start_pulse + add recvchannel fallback
    - RTL: merge result_start_pulse into single always_ff block, use _r one-cycle
    pulse pattern (matching cfg_start_r) to eliminate DRC MDRV-1 error
    - SW: gate DMA S2MM on recvchannel is not None, fall back to MMIO on old
    bitstreams that lack S2MM
    - docs: add optimization recording rule to CLAUDE.md; mark P0 S2MM done in
    OPTIMIZATION_ROADMAP.md
    [cim_axi_lite_slave.sv]
2026-05-03 perf(sw): optimize _stream_load — reduce MMIO ops + eliminate numpy↔list conversion
    - Remove redundant CSR_STREAM_STATUS write (cleared at end of previous xfer)
    - Remove dummy CSR_STREAM_STATUS read (AXI write ordering is sufficient)
    - Lift np.asarray() to top of _stream_load, shared by single/chunked paths
    - load_input: remove .tolist(), pass numpy view directly
    - load_bias: list comprehension → single np.asarray()
    - predict(): remove packed_input.tolist() roundtrip
    Expected: ~11ms reduction in dma_x_setup_ms + load_x_ms per image
    (~2 MMIO ops saved × 111 MVM calls × ~50us per op).
2026-05-03 feat(sw): add P0 S2MM diagnostic print on DMA init
    Prints recvchannel availability at CIMDriver startup so users can
    immediately confirm whether the loaded bitstream supports P0 S2MM.
2026-05-03 debug(sw): add detailed P0 S2MM diagnostic — print DMA params, streams, attributes
2026-05-03 debug(sw): expand P0 S2MM diagnostic — search ip_dict keys, print full DMA description
2026-05-03 feat(sw): add _read_output_dma_raw — P0 S2MM via raw MMIO when PYNQ recvchannel unavailable
    Bypasses PYNQ's DMA driver to control AXI DMA S2MM registers directly:
    - Writes physical address to S2MM_DA (0x48)
    - Writes buffer length to S2MM_LENGTH (0x58) to arm DMA receiver
    - Triggers RTL source via CSR_RESULT_CTRL
    - Polls S2MM_DMASR.IOC_Irq for completion
    - Invalidates cache and reads result
2026-05-03 fix(rtl): fix cim_axi_stream_source BRAM latency + tlast off-by-one (P0 S2MM hang)
    Two bugs caused the P0 S2MM result read-back to hang on board:
    1. BRAM read has 2-cycle latency (MUX propagation + registered output_buffer
    read), but FSM assumed 1-cycle — first byte stale, all data shifted.
    2. tlast was checked with `n_bytes_r - byte_cnt == 0`, which is off by one
    (e.g. for N=4, byte_cnt=3, remaining=1 ≠ 0). tlast never asserted, so
    DMA S2MM waited forever → recvchannel.wait() hung.
    Fixes:
    - Add S_WAIT state for proper 2-cycle BRAM pipeline
    - Check `byte_cnt == n_bytes_r - 1` at every byte capture for tlast
    - Handle partial last words (last byte at sub_idx < 3)
    Co-Authored-B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
    [cim_axi_stream_source.sv]
2026-05-03 fix(sw): prefer raw MMIO S2MM path, fix buffer length + ordering
    - Temporarily prefer _read_output_dma_raw over recvchannel to isolate
    whether the RTL source or PYNQ's recvchannel driver causes the hang
    - Fix S2MM_LENGTH to use n_words*4 (word-aligned) instead of raw out_dim
    - Reorder: set DMACR.RS=1 BEFORE triggering RTL source (DMA armed first)
    - Add DMASR diagnostic print on first poll iteration
    - Better timeout error message with full DMA status
2026-05-03 fix(sw): restore recvchannel as primary S2MM path
    Raw MMIO S2MM register access (0x30/0x34) fails — the DMA's S2MM register
    range may not be fully accessible via PYNQ's generic MMIO object.
    Revert to recvchannel path (which properly detected S2MM hardware); the
    RTL tlast fix should resolve the original recvchannel.wait() hang.
    Raw MMIO improvements retained as fallback path.
2026-05-03 debug(sw): add RTL source FSM diagnostics to _read_output_dma
    Poll CSR_RESULT_STATUS (busy/done) before and after triggering source FSM
    to isolate whether the hang is in the RTL source or DMA recvchannel.
2026-05-03 fix: make source done sticky + restore DMA-before-source order
    RTL: done was a one-cycle pulse (16.67ns), impossible for Python MMIO poll
    to catch. Now sticky — cleared on next cfg_start. CSR_RESULT_STATUS[1]
    reliably reflects completion.
    SW: restore correct order — start DMA S2MM before triggering RTL source,
    so the DMA is armed and asserting tready when data arrives.
    [cim_axi_stream_source.sv]
2026-05-04 fix: S2MM is_last_word sticky + direct register mode for both DMA channels
    RTL: clear is_last_word on cfg_start to prevent FSM from terminating
    after first beat on transfers 2+. Previously is_last_word stayed set
    from previous xfer, causing S_SEND→S_IDLE immediately.
    SW: bypass PYNQ _SDMAChannel for both MM2S and S2MM paths, using
    direct register mode per PG021. Remove debug sleeps (10ms reset +
    100ms drain = ~5.6s overhead for 51 calls). Add double-buffer for
    result S2MM. Reduce drain to 1ms.
    TCL: connect axi_mem_intercon_1 reset pins for KV260 build.
    [cim_axi_stream_source.sv]
2026-05-04 fix(sw): remove unnecessary 1ms drain sleep in S2MM read_output
    Source done + DMA idle already guarantee all data is written to DDR.
    The drain sleep contributed ~51ms (1ms × 51 S2MM calls) to read_out_ms.
2026-05-04 docs: update CLAUDE, README, paper with P0 S2MM benchmark results (128.4ms/img)
    - CLAUDE.md: update DMA status from pending to completed, add bottleneck breakdown
    - README.md: mark step 8.5 as complete, add debug history + measured performance table
    - paper.tex: add §4.7.8 P0 S2MM subsection with benchmark tables, update profiler
    forward reference, update summary (6) and future work (6) with final numbers
    Key data: LeNet-5 128.4 ms/img (7.8 fps, 13.2x vs MMIO baseline).
    read_out: 257ms → 19.65ms (13.1x). Current bottleneck: setup 41ms, load_x 23ms, im2col 21ms.
2026-05-04 perf(sw): im2col vectorization + predict_batch layer-wise batching
    Three software-side optimizations targeting 128→~60 ms/img:
    1. im2col: replace Python nested loops with as_strided vectorization (21→~2ms)
    2. setup: add CIMModel.predict_batch() — layer-wise batching loads weights
    ONCE per layer for entire batch (41→~0.2ms amortized)
    3. load_x: pre-pack Conv column inputs with numpy reshape (23→~14ms)
    benchmark_e2e.py: add --batch flag for predict_batch path.
    [benchmark_e2e.py]
2026-05-05 fix(sw): accurate profiler for predict_batch — per-phase MVM timings
    Profiler bugs fixed:
    - FC setup_ms now normalized by n_img (was raw total, inconsistent with Conv)
    - compute_ms/read_out_ms now tracked via infer_fc_input_only _timings
    (were always 0; timing was bundled into load_x_ms)
    - Added FC verbose output (was missing)
    - Conv verbose shows per-layer cycles (was accumulated total_cycles)
    - Added dma_x_setup_ms/dma_x_transfer_ms to predict_batch profiler
    Benchmark profiler report now shows detailed per-phase breakdown with
    un-profiled gap indicator.
    [benchmark_e2e.py]
2026-05-05 docs: update roadmap with 2026-05-05 board test results + profiler fix
    im2col improvement confirmed (20.6→1.2ms), but total latency unchanged at
    128.1ms/img. Profiler fixed in prev commit; need re-test for accurate
    breakdown to locate the overhead offsetting setup savings.
2026-05-05 fix(sw): comprehensive profiler + vectorized maxpool2d
    - Fix double-counting: dma_x_setup/transfer are sub-components of load_x_ms
    and no longer inflate prof_sum
    - Add missing phase tracking: pack_ms (conv pre-packing), pool_ms (maxpool),
    final_ms (argmax loop)
    - Vectorize maxpool2d with as_strided (replaces Python triple-nested loops)
    - Ensure consistent phase keys across all layer types for clean aggregation
    [benchmark_e2e.py]
2026-05-05 docs: update roadmap with final 56.2ms/img benchmark (2.3× vs DMA baseline)
2026-05-05 perf(hw,sw): increase MAX_IN_DIM 784→1024, MAX_OUT_DIM 128→256 for larger k_pack
    Enables larger block-diagonal weight packing (k_pack) to reduce MVM calls
    per image: Conv1 k_pack 21→40 (28→15 MVMs), Conv2 k_pack 5→6 (13→11 MVMs).
    Total MVM calls: 44→29 (-34%), proportional reduction in DMA overhead.
    Also fix _stream_load buffer size check: move from unconditional to
    single-transfer path only (chunked path only needs MAX_DMA_WORDS worth
    of buffer, not the full payload).
    Synthesis result: BRAM 70/140 (50%), WNS +1.336ns clean.
    Estimated latency: 56.2→~39-42 ms/img (24-26 fps).
    [cim_pkg.sv]
2026-05-05 docs: add k_pack verified benchmark — 40.5ms/img, 24.7fps, 1.39× speedup
    Measured: load_x 22.7→15.0ms (-34%), read_out 18.3→12.0ms (-34%),
    tracking MVM reduction 44→29 exactly. Accuracy 199/200 unchanged.
2026-05-05 perf(hw,sw): further increase MAX_IN_DIM 1024→1536 for Conv2 k_pack boost
    Conv2 k_pack 6→10 (MVM 11→7), Conv1 k_pack 40→42 (MVM 15→14).
    Total MVM calls: 29→24 (-17% vs previous, -45% vs original 44).
    [dma_optimize.csv]
2026-05-05 docs: add MAX_IN_DIM=1536 verified benchmark — 36.9ms/img, 27.1fps, 45.8× vs MMIO
    Conv2 k_pack 6→10 (MVM 11→7), BRAM 90% at PYNQ-Z2 limit.
2026-05-05 perf(sw): DMA pipeline overlap — overlap S2MM read of batch N with MM2S load of batch N+1
    Refactor _read_output_dma() into non-blocking _start_read_output_dma() and
    _finish_read_output_dma() methods. In predict_batch Conv MVM loop:
    load_x(N) → finish S2MM(N-1) → compute(N) → start S2MM(N)
    The AXI DMA has independent MM2S and S2MM channels; CIM has independent
    input/output datapaths. S2MM (~400us) fits inside MM2S (~500us), so
    read_out should be nearly fully overlapped for all but the last MVM call.
    Estimated savings: ~8-9ms, pushing total under 30ms (target: 33+ fps).
2026-05-05 revert(sw): remove DMA pipeline overlap — no measurable benefit on PYNQ-Z2
    The S2MM read of batch N was meant to overlap with load_x+compute of
    batch N+1, but the CPU busy-waits through all phases regardless. Per-MVM
    overhead (MM2S setup + polling + CIM CSR writes) dominates — the CPU is
    never free, so reordering work doesn't reduce total wall time.
    This reverts to the original _read_output_dma (single blocking call) and
    the original infer_fc_input_only-based packed MVM loop.
    net: 36.9 ms/img unchanged
2026-05-06 perf(hw,sw): Phase B IBUF/OBUF dual-bank ping-pong — 29.2ms/img, 34.3fps, 57.9× vs MMIO
    - IBUF/OBUF each split into bank0/bank1, controlled by CSR_PING_CTRL (0x06C)
    - DMA always accesses inactive bank (~reg_ping_ctrl), CIM compute uses active bank
    - Python: infer_batch_pingpong() overlaps DMA transfers with hardware compute
    - Conv layers batch all k_pack inputs across all images into single ping-pong call
    - Paper updated with full optimization journey (9 stages, 1690.5→29.2ms)
    - Bitstream checkpoint4 archived (WNS=-0.991, 128/140 BRAM, 100% DSP)
2026-05-08 fix(rtl): Phase C v5 — fix bias_addr_cur OBUF write address when bias_base≠0
    bias_addr_cur incorrectly included cfg_bias_base, causing FC2 output
    writes to wrong OBUF addresses when bias_base≠0 in fused FC layers.
    Removed cfg_bias_base from bias_addr_cur (OBUF write); bias reads use
    b_rd_addr_r pipeline register correctly. Added non-zero weight_base/
    bias_base tests (7a/7b/7c). Bitstream checkpoint8: WNS=-0.544ns,
    LUT 32.64%, BRAM 81.43% — essentially identical to v4.
    [cim_accel_core.sv, cim_axi_lite_slave.sv, cim_pkg.sv, tb_cim_accel_core.sv, tb_mnist_e2e.sv]
2026-05-09 fix(rtl): Phase C v6 — add F_WAIT_MUX state for OBUF read pipeline MUX propagation
    The OBUF→IBUF fusion FSM needs 2 cycles of pipeline delay before the first
    valid read data appears: 1 cycle for the always_comb MUX (fusion_busy →
    obuf_rd_addr) to propagate through the NBA region, plus 1 cycle for OBUF's
    registered BRAM read. The old 3-state FSM captured garbage at position 0,
    causing a 1-byte shift in the fused output.
    Add F_WAIT_MUX between F_IDLE and F_RD_FIRST, matching the same pattern
    used in cim_axi_stream_source (S_IDLE→S_WAIT→S_WARMUP→S_READ). F_RD_FIRST
    now captures byte 0 instead of just advancing the address. Total: N+2
    cycles + tile-write overhead.
    Regression: 3/3 P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
    [cim_axi_lite_slave.sv]
2026-05-09 fix(rtl): Phase C v7 — capture byte 0 in F_WAIT_MUX, eliminate F_RD_FIRST
    v6 incorrectly assumed OBUF read requires 2 pipeline cycles (MUX + BRAM).
    The always_comb MUX propagates immediately after NBA — only the BRAM read
    is registered (1 cycle). v6's F_WAIT_MUX skipped byte 0 by advancing the
    address without capturing data, causing a 1-byte shift observed on hardware.
    Fix: F_WAIT_MUX now captures byte 0 from rd_data (OBUF[0] is valid at
    this cycle's start — addr=0 was set in F_IDLE NBA, OBUF captured it at
    the posedge). F_RD_FIRST state eliminated. Total: N cycles + ceil(N/16)
    tile-write overhead (down from N+2 in v6).
    Regression: 3/3 PASS. Python sim: PASS (137 cycles for 128 bytes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
    [cim_axi_lite_slave.sv]
2026-05-10 fix(rtl): Phase C v9 — fix 1-byte shift, wait for registered OBUF BRAM read
    F_WAIT_MUX was capturing obuf_rd_data prematurely — OBUF BRAM read is
    registered (always_ff), so rd_data lags rd_addr by 1 cycle. The MUX
    propagation (always_comb) is instant, but the BRAM read is not.
    Fix: F_WAIT_MUX only waits (no data capture), F_PACK now handles byte 0.
    F_WRITE routes back to F_WAIT_MUX instead of F_PACK to wait for OBUF read
    at the incremented address after each tile write.
    [cim_axi_lite_slave.sv]
2026-05-10 fix(rtl): Phase C v10 — fix F_WAIT_MUX addr advance, F_WRITE back to F_PACK
    v9 F_WAIT_MUX kept addr=0, causing F_PACK byte 0 to trigger a duplicate
    OBUF read of bank[0]. The re-read replaced the rd_data for byte 1 with
    stale data, producing a 1-byte right shift within each tile.
    Fix: F_WAIT_MUX now advances addr (0→1) to avoid the re-read.
    F_WRITE goes directly to F_PACK (not F_WAIT_MUX) since addr is already
    correctly positioned (byte_idx+1) after the +1 in F_WRITE.
    Pipeline invariant: at each capture cycle, addr = byte_idx + 1.
    [cim_axi_lite_slave.sv]
2026-05-10 docs: add Phase C v10 checkpoint14 bitstream stats (WNS=-0.911, building→built)
2026-05-10 docs: Phase C v10 on-board test PASS — fusion 5/5, diag + test_fusion all pass
2026-05-10 feat(sw): auto-detect and fuse consecutive FC layers in CIMModel.predict_batch()
    Phase C fusion now transparent in CIMModel. When use_dma=True, adjacent FC
    layers are automatically chained via OBUF→IBUF internal copy — no DMA
    round-trip between them. No benchmark flags needed.
    Adds:
    - _find_fc_groups(): detect 2+ consecutive FC layers
    - _preload_fc_chain(): DMA-load all FC weights/bias at computed SRAM offsets
    - Fusion path in predict_batch(): FC chain with copy_output_to_input()
    between each pair, eliminating one S2MM+MM2S DMA round-trip per transition.
2026-05-10 fix(sw): move FC weight preload to chain start, not before main loop
    Conv layers call load_weights(base_tile=0) during predict_batch(), which
    overwrote FC weights pre-loaded before the loop. Now _preload_fc_chain()
    is called when the FC chain is first encountered, after all preceding
    conv/pool layers have finished.
2026-05-10 docs: update Phase C with measured on-board benchmark results
    MLP 784→128→10: +23% (2.4→1.9 ms/img, 419→515 fps)
    LeNet-5: negligible (FC layers too small vs conv, ping-pong amortizes DMA)
2026-05-10 cleanup: finalize Phase C — delete intermediate files, rename checkpoint14→5, update docs
    Delete 9 intermediate checkpoint dirs and 22 diag scripts. Rename final
    checkpoint14 bitstream to checkpoint5 for sequential numbering. Update
    CLAUDE.md, README.md, and OPTIMIZATION_ROADMAP.md with Phase C v10 PASS
    results. Add test_fusion.py for on-board fusion verification.
2026-05-28 feat: PYNQ v3.x compat, PicoRV32 multi-image benchmark, thesis data
    Major changes:
    - sw/cim_driver.py: add _load_bitstream() for PYNQ v3.x XSA support
    with Bitstream.download() fallback and clock-aware loading
    - hw/scripts/vivado_build.tcl: auto-generate PYNQ v3.x compatible XSA
    with proper sysdef.xml (injects <File Type="BIT"> from hwdef.xml)
    - hw/scripts/export_xsa.tcl: new script for standalone XSA post-processing
    - picorv32/fw/firmware.c: multi-image handshake protocol with PS,
    bias offset fix (cim_load_bias_at), bank toggle in cim_start_and_wait
    - picorv32/fw/gen_fw_data.py: support --image-idx=None for PS-handshake mode
    - sw/scripts/benchmark_rv32.py: PicoRV32 e2e benchmark with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
    [benchmark_e2e_60mhz_dma.csv, benchmark_e2e_60mhz_mmio.csv, dma_optimize.csv]
2026-05-28 Squash cleanup: remove kv260 artifacts, add thesis materials, update .gitignore
    - Remove kv260/ tracked files (now in .gitignore)
    - Replace firmware.hex with .hex.bytes variants
    - Add thesis end/paper pics, figures, and scripts
    - Clean .gitignore: rm stale entries, add .codex rule
2026-05-31 Sun May 31 02:56:00 PM CST 2026
    [arm_100mhz_dma_batch_lenet5.csv, arm_100mhz_dma_batch_mlp.csv, arm_100mhz_dma_batch_no_fusion_lenet5.csv, arm_100mhz_dma_batch_no_fusion_mlp.csv, arm_100mhz_dma_batch_no_fusion_small_mlp.csv, arm_100mhz_dma_batch_small_mlp.csv, arm_100mhz_dma_lenet5.csv, arm_100mhz_dma_mlp.csv]
2026-05-31 Mon Jun 1 02:38:01 AM CST 2026
    [arm_dma_batch_lenet5_data_41.csv, arm_dma_batch_lenet5_data_42.csv, arm_dma_batch_mlp_data_41.csv, arm_dma_batch_mlp_data_42.csv, arm_dma_batch_no-fusion_lenet5_data_41.csv, arm_dma_batch_no-fusion_lenet5_data_42.csv, arm_dma_batch_no-fusion_mlp_data_41.csv, arm_dma_batch_no-fusion_mlp_data_42.csv]
2026-06-01 Mon Jun 1 02:02:53 PM CST 2026
    [arm_dma_batch_small_mlp_data_42.csv, picorv32_small_mlp_data_42.csv, sw_baseline_summary.csv, sw_baseline_summary_20250504_004517.csv, sw_baseline_summary_20250504_004708.csv]
2026-06-04 Thu Jun 4 07:05:20 PM CST 2026
    [arm_dma_batch_lenet5_data_41.csv, arm_dma_batch_lenet5_data_42.csv, arm_dma_batch_mlp_data_41.csv, arm_dma_batch_mlp_data_42.csv, arm_dma_batch_no-fusion_lenet5_data_41.csv, arm_dma_batch_no-fusion_lenet5_data_42.csv, arm_dma_batch_no-fusion_mlp_data_41.csv, arm_dma_batch_no-fusion_mlp_data_42.csv]
2026-06-04 Thu Jun 4 07:32:41 PM CST 2026
    [par_ob_sweep_results.csv]
2026-06-05 Fri Jun 5 03:51:42 PM CST 2026
    [par_ob_sweep_results.csv]
2026-06-05 Sat Jun 6 01:12:02 AM CST 2026
    [par_ob_sweep_results.csv]
